revk/ESP32-LED/PCB/README.md

# PCBs

Various PCBs designed for use with LED code.

## Trademark

This is an open source project, but bear in mind you cannot sell boards bearing the Andrews & Arnold Ltd name, the A&A logo, the registered trademark AJK logo, or the GS1 allocated EANs assigned to Andrews & Arnold Ltd.

## Coaster

Coaster board

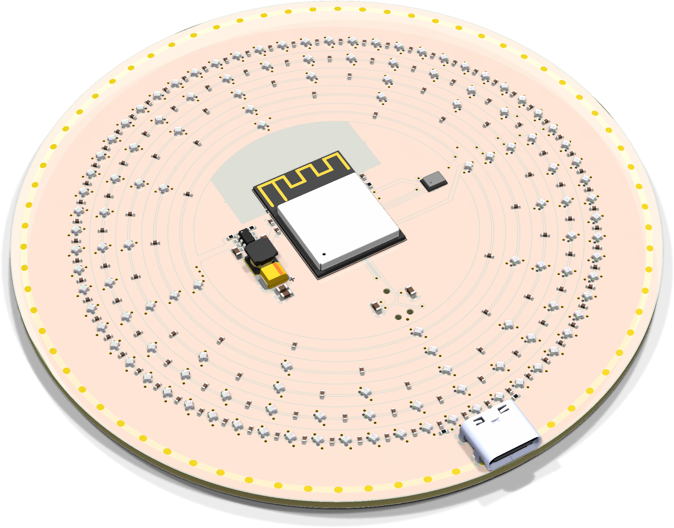
[picture p10: PCB/Coaster2/Coaster-90.png]
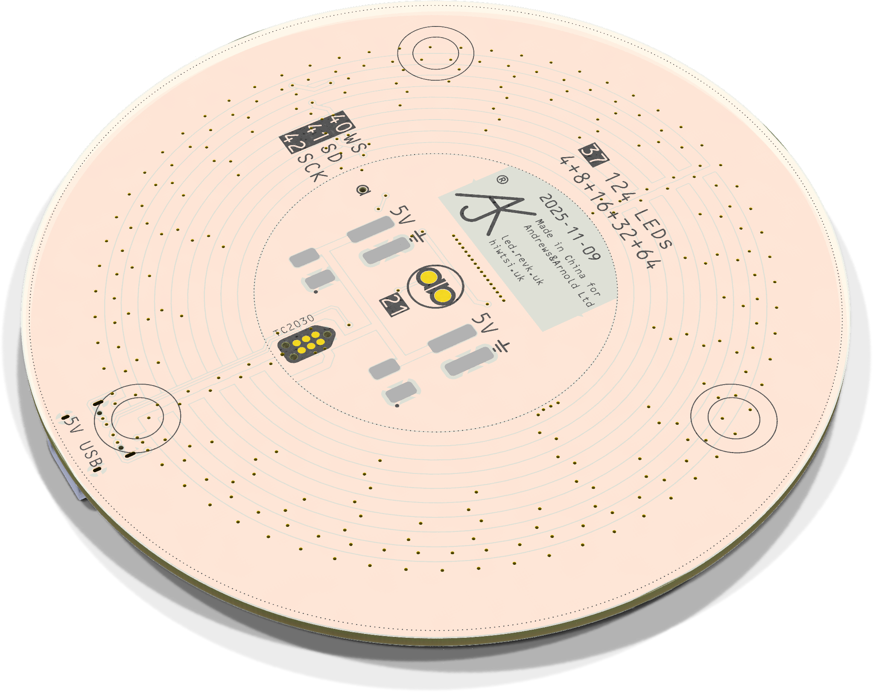
[picture p11: PCB/Coaster2/Coaster-bottom.png]
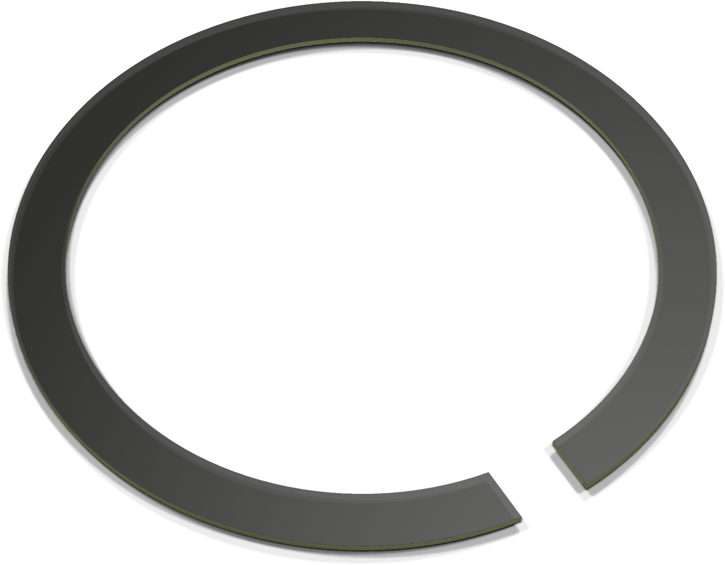
[picture p12: PCB/Coaster2/Spacer-90.png]
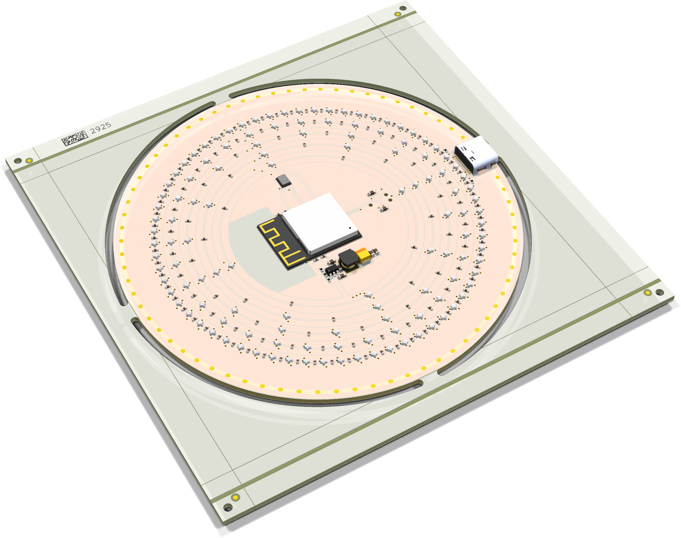
[picture p13: PCB/Coaster2/Coaster-panel.png]


## LEDA

USB-A board

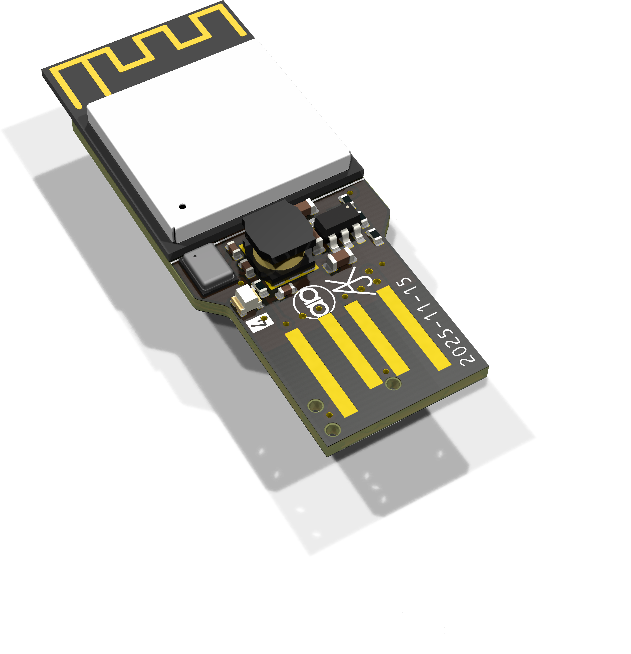
[picture p14: PCB/LEDA/LED-alt-90.png]
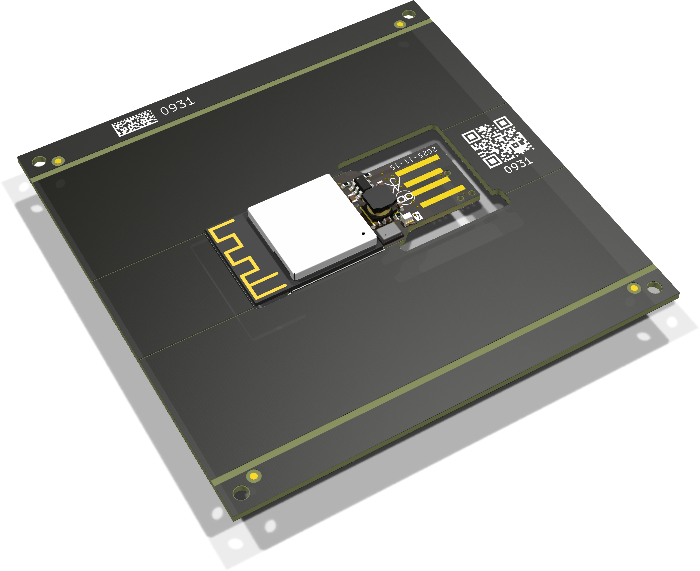
[picture p15: PCB/LEDA/LED-panel.png]


## LEDC

USB-C board

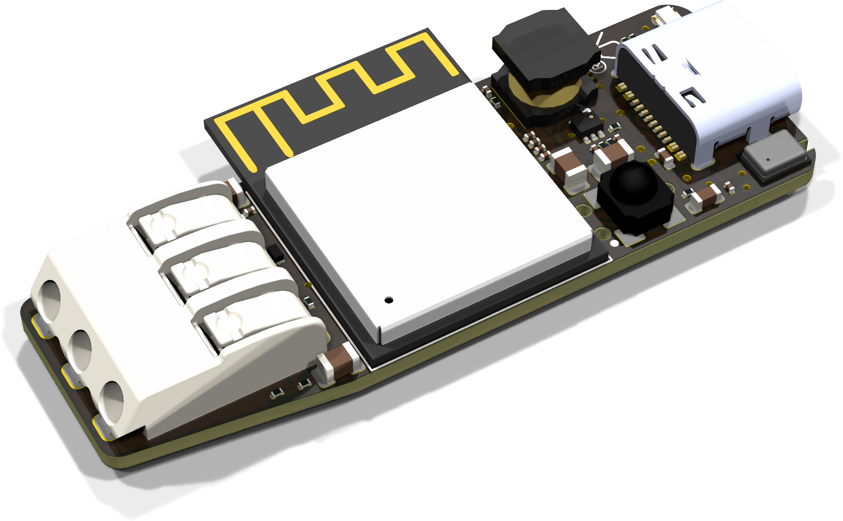
[picture p16: PCB/LEDC12/LED.png]
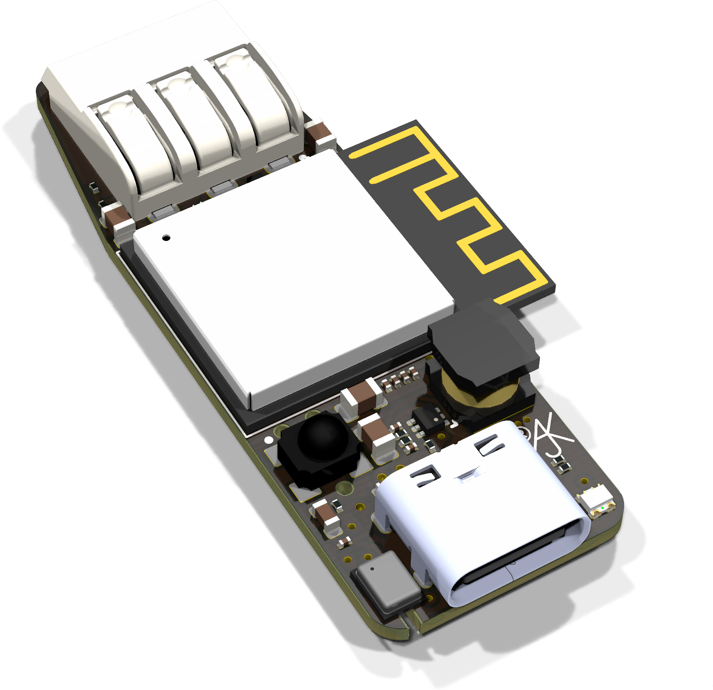
[picture p17: PCB/LEDC12/LED-90.png]
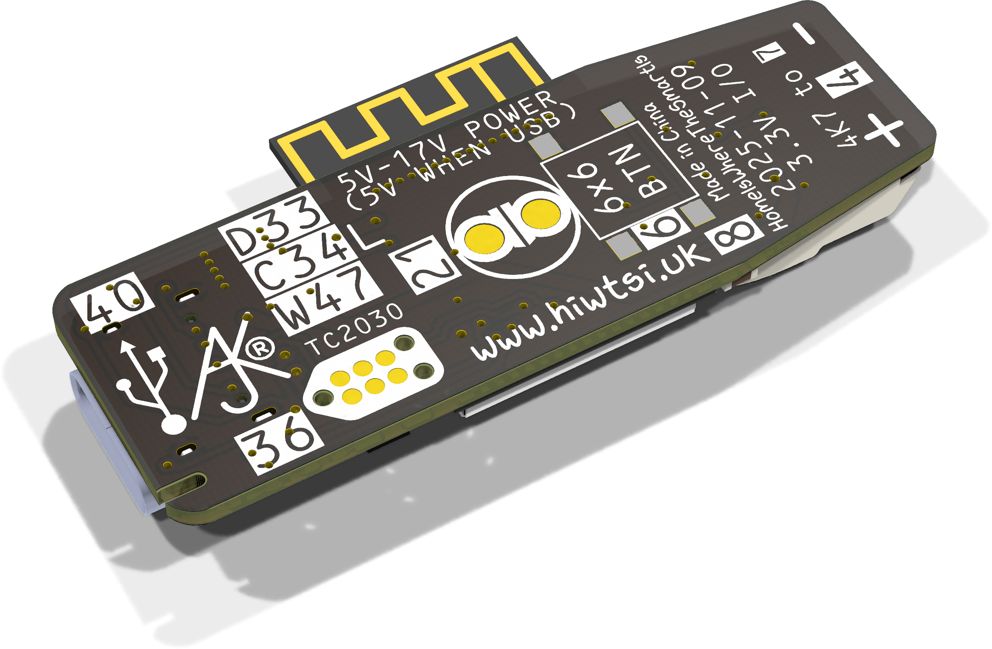
[picture p18: PCB/LEDC12/LED-bottom.png]
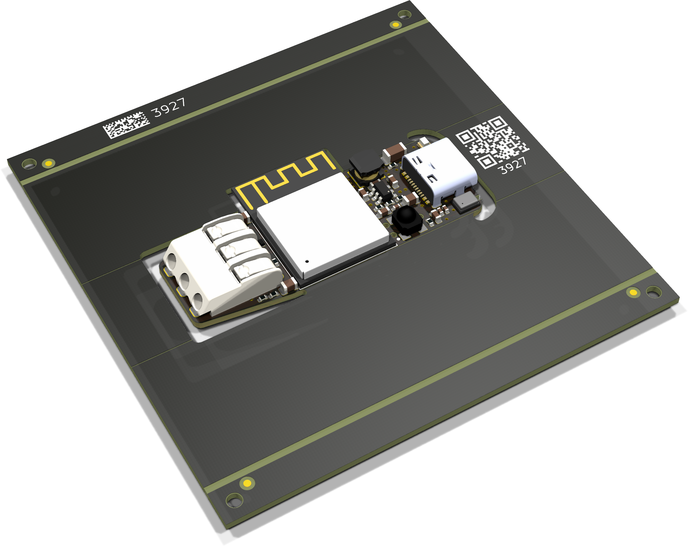
[picture p19: PCB/LEDC/LED-panel.png]
 

## LEDX

Non USB board

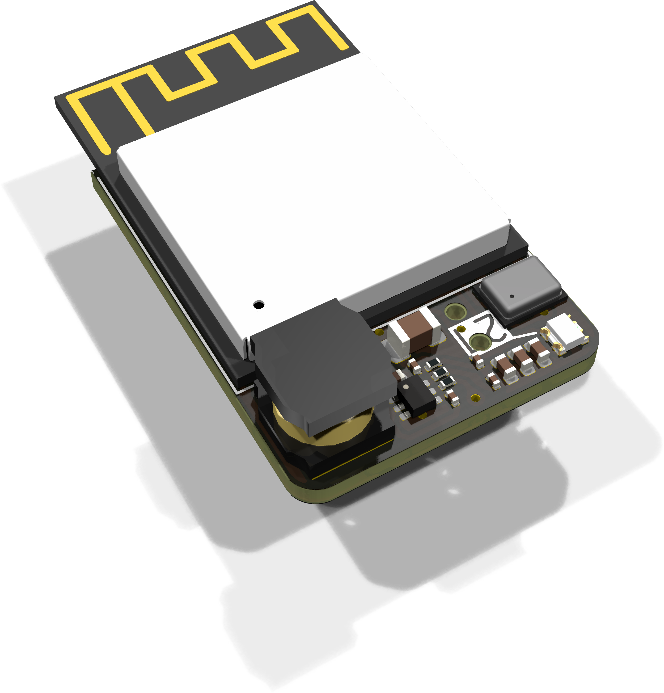
[picture p20: PCB/LEDX12/LED-90.png]
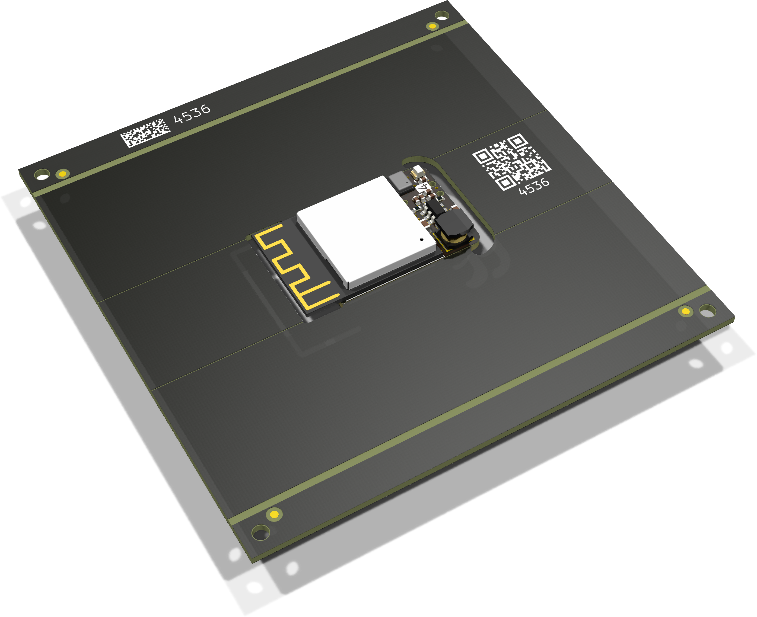
[picture p21: PCB/LEDX/LED-panel.png]


## LEDR

USB-C uber board

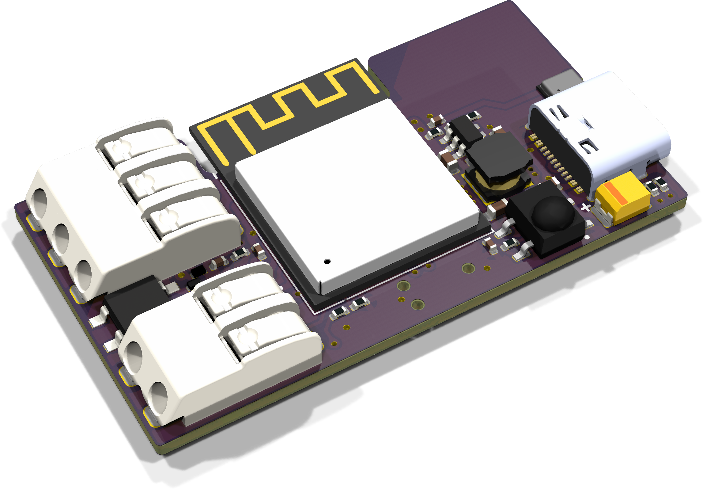
[picture p22: PCB/LEDR/LED.png]
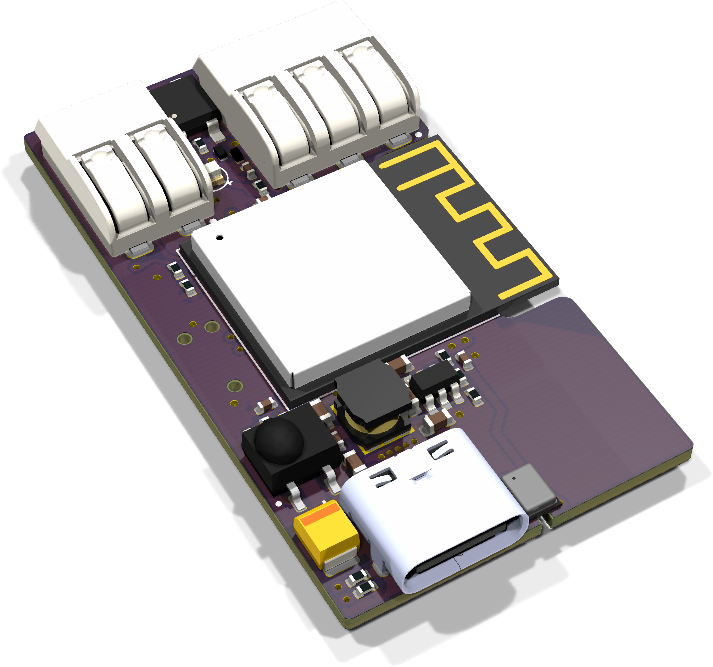
[picture p23: PCB/LEDR/LED-90.png]
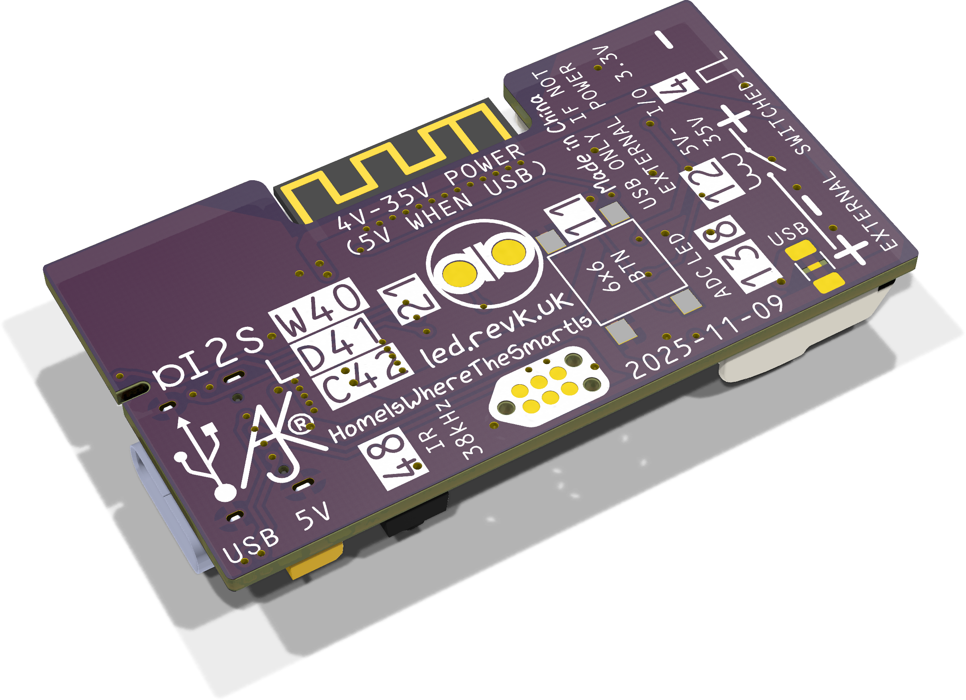
[picture p24: PCB/LEDR/LED-bottom.png]
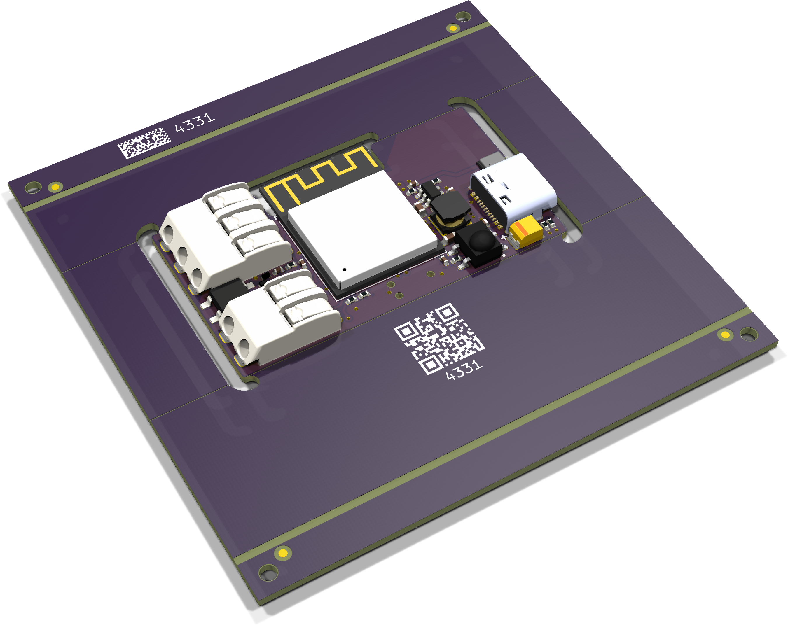
[picture p25: PCB/LEDR/LED-panel.png]


## LEDx2

USB-C dual LED board

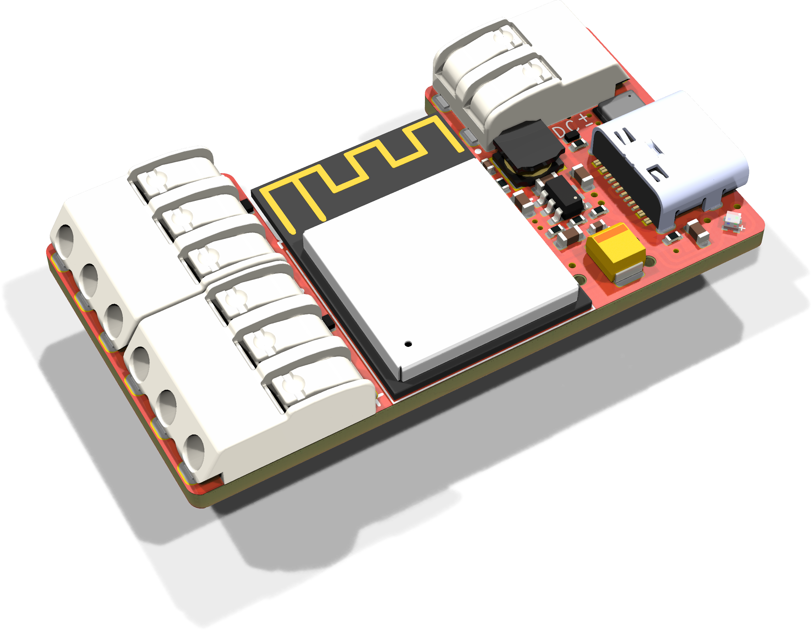
[picture p26: PCB/LEDx2/LED.png]
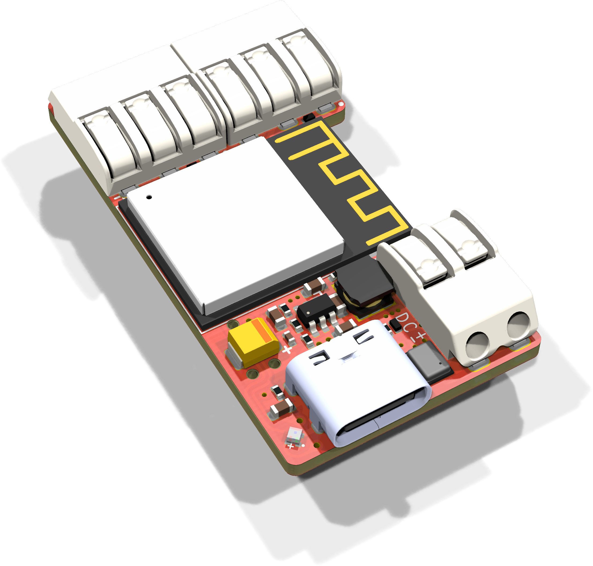
[picture p27: PCB/LEDx2/LED-90.png]
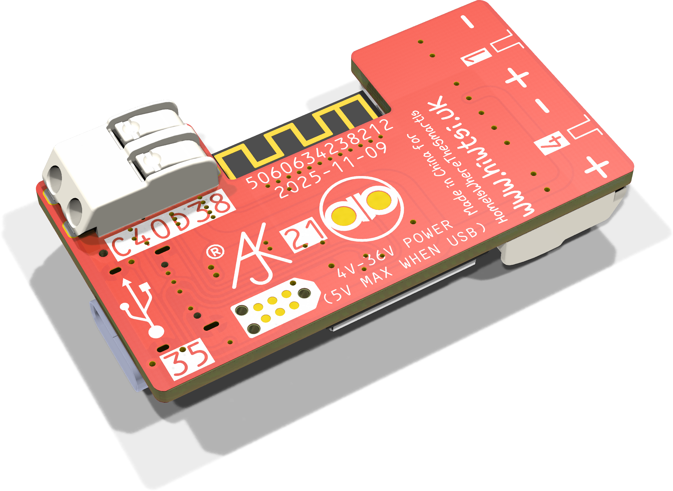
[picture p28: PCB/LEDx2/LED-bottom.png]
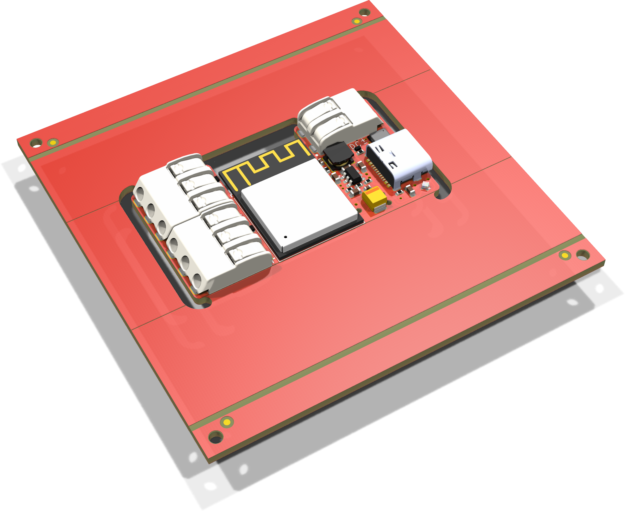
[picture p29: PCB/LEDx2/LED-panel.png]


## LED32

88 LED disk, 32mm diameter

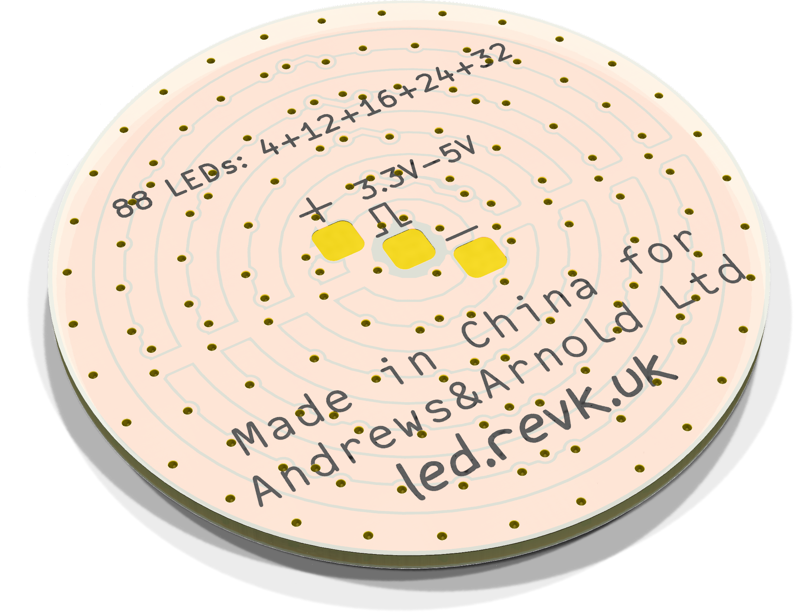
[picture p30: PCB/LED32/LED-bottom.png]
