revk/ESP32-LED/PCB/LEDA/README.md

# LEDA

## Trademark

This is an open source project, but bear in mind you cannot sell boards or cases bearing the Andrews & Arnold Ltd name, the A&A logo, the registered trademark AJK logo, or the GS1 allocated EANs assigned to Andrews & Arnold Ltd.

## PCB Designs

These files are for use with [KiCAD](https://www.kicad.org).

- [LED](LED.kicad_pro)

## 3D

3D case designs are normally automatically created from the PCB so as to ensure correct details and placement of apertures, etc.

|Design|Bottom|Top|Combined|
|---|---|---|---|
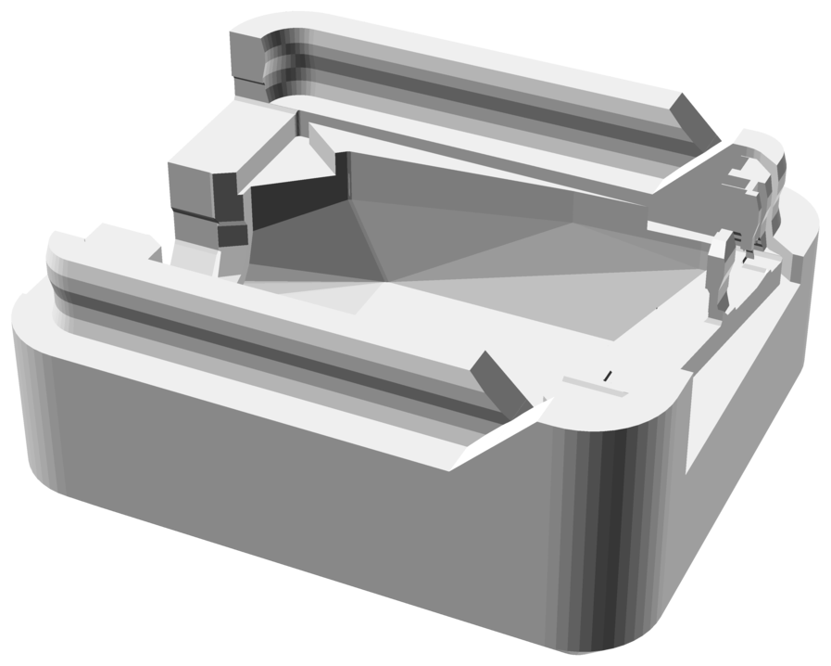
[picture p31: PCB/LEDA/LEDB.png]
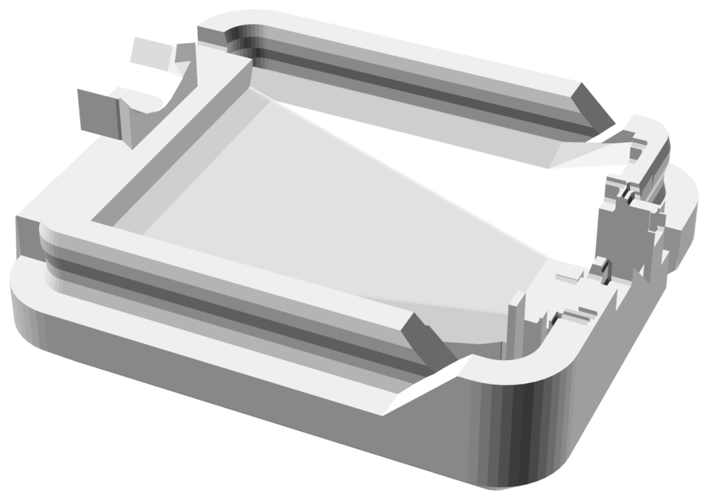
[picture p32: PCB/LEDA/LEDT.png]
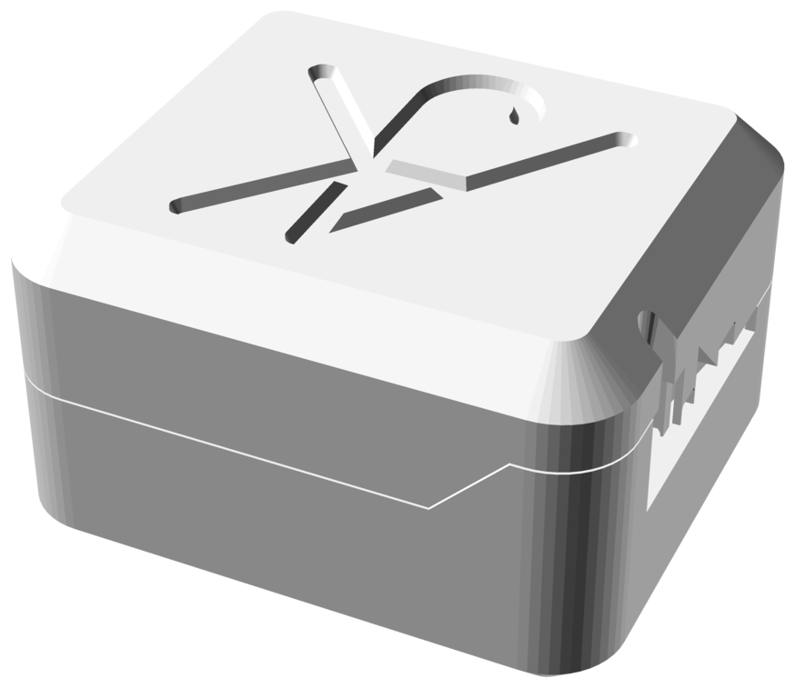
[picture p33: PCB/LEDA/LEDC.png]
|LED||||

## PCB Images

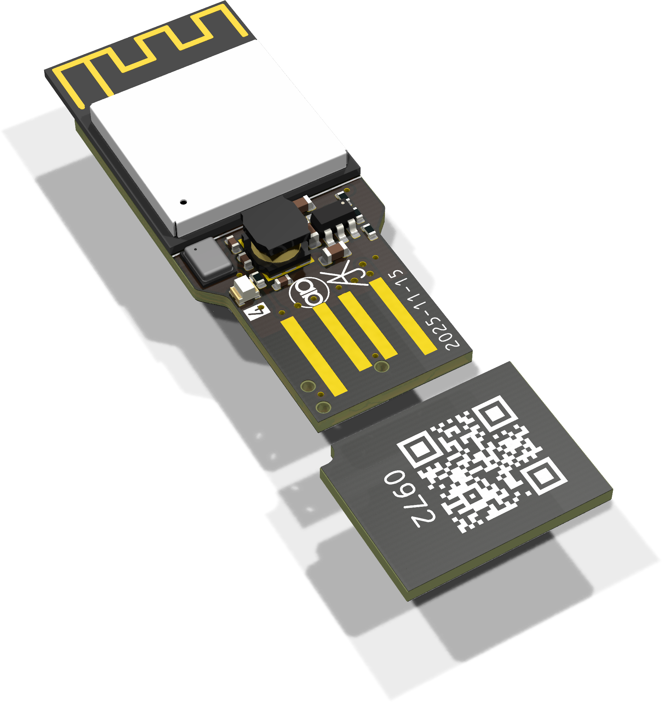
[picture p34: PCB/LEDA/LED-90.png]

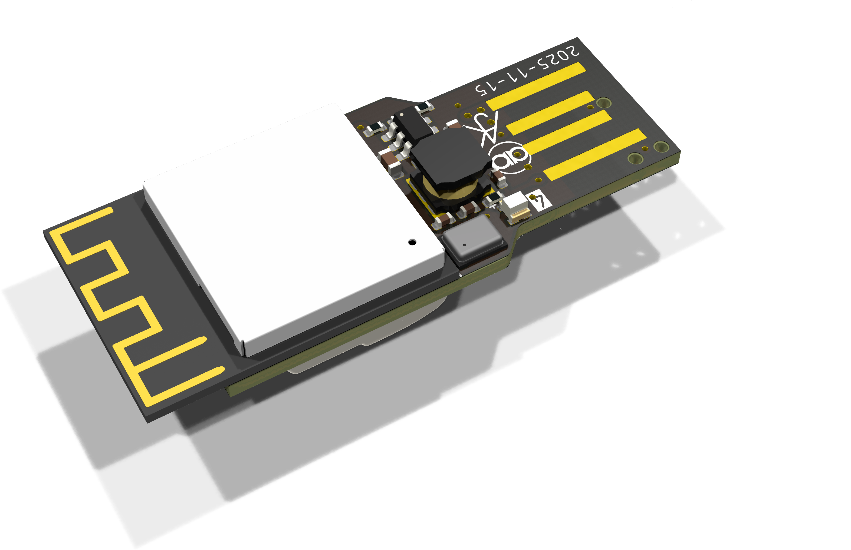
[picture p35: PCB/LEDA/LED-alt.png]
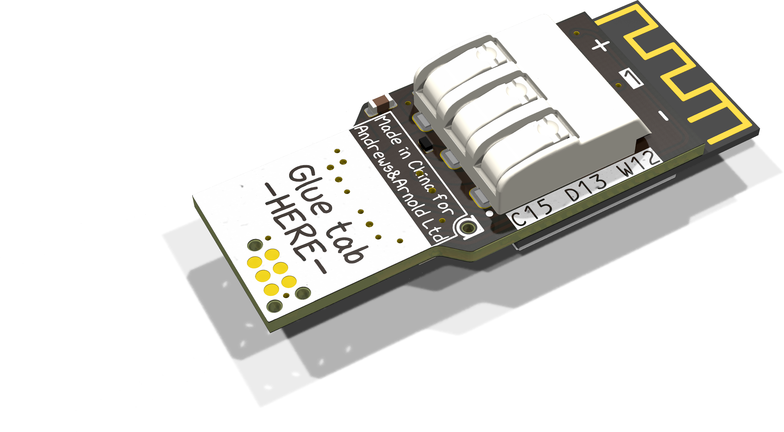
[picture p36: PCB/LEDA/LED-alt-bottom.png]

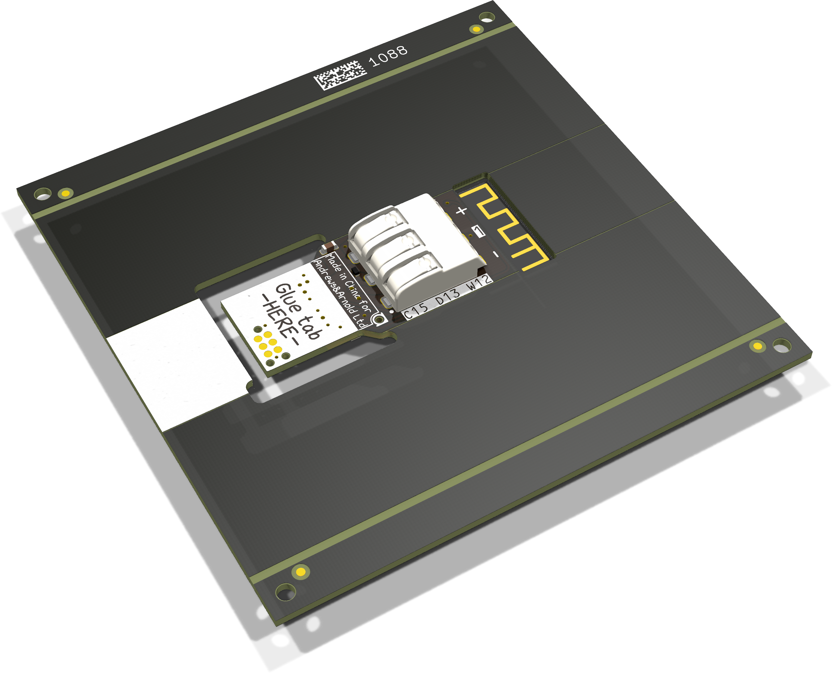
[picture p37: PCB/LEDA/LED-panel-bottom.png]


---

*Auto generated README.md 2025-11-15T10:07:33*
