revk/ESP32-LED/PCB/LEDC12/README.md

# LEDC12

## Trademark

This is an open source project, but bear in mind you cannot sell boards or cases bearing the Andrews & Arnold Ltd name, the A&A logo, the registered trademark AJK logo, or the GS1 allocated EANs assigned to Andrews & Arnold Ltd.

## PCB Designs

These files are for use with [KiCAD](https://www.kicad.org).

- [LED](LED.kicad_pro)

## 3D

3D case designs are normally automatically created from the PCB so as to ensure correct details and placement of apertures, etc.

|Design|Bottom|Top|Combined|
|---|---|---|---|
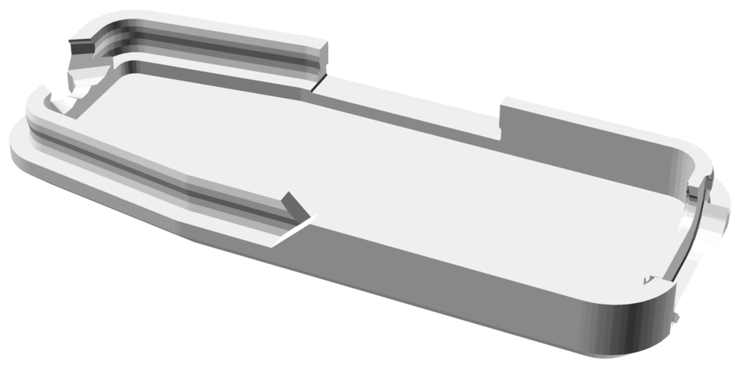
[picture p44: PCB/LEDC12/LEDB.png]
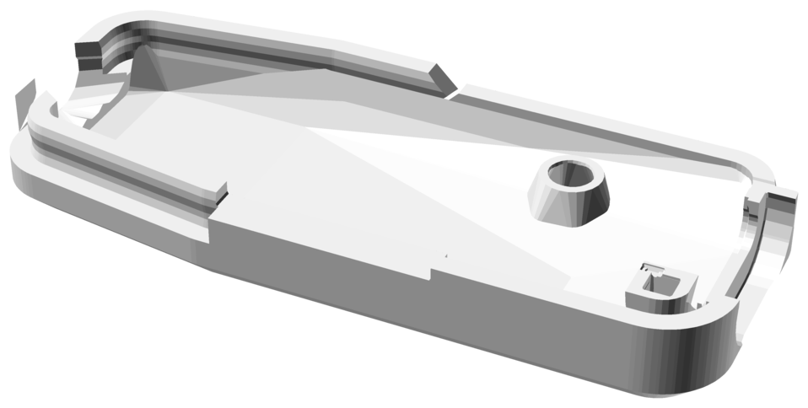
[picture p45: PCB/LEDC12/LEDT.png]
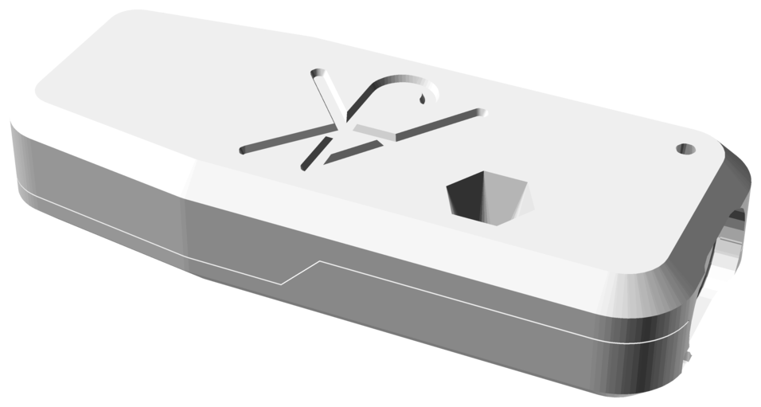
[picture p46: PCB/LEDC12/LEDC.png]
|LED||||

## PCB Images


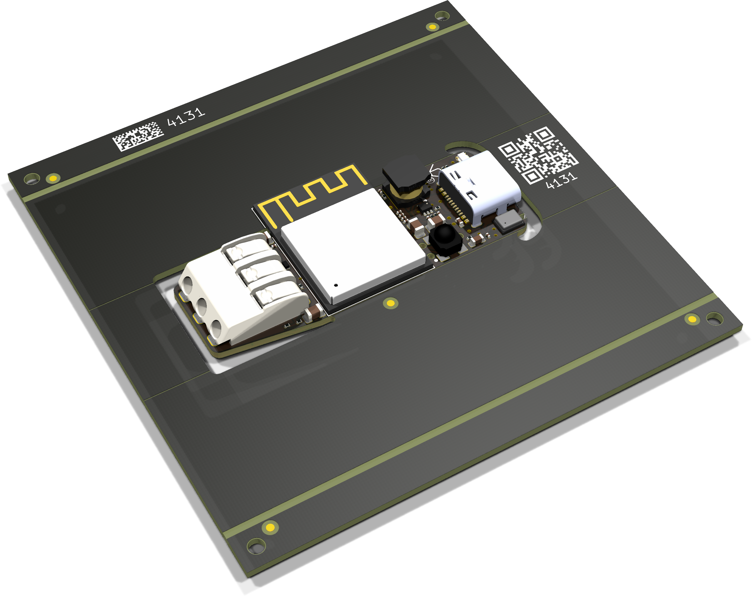
[picture p47: PCB/LEDC12/LED-panel.png]
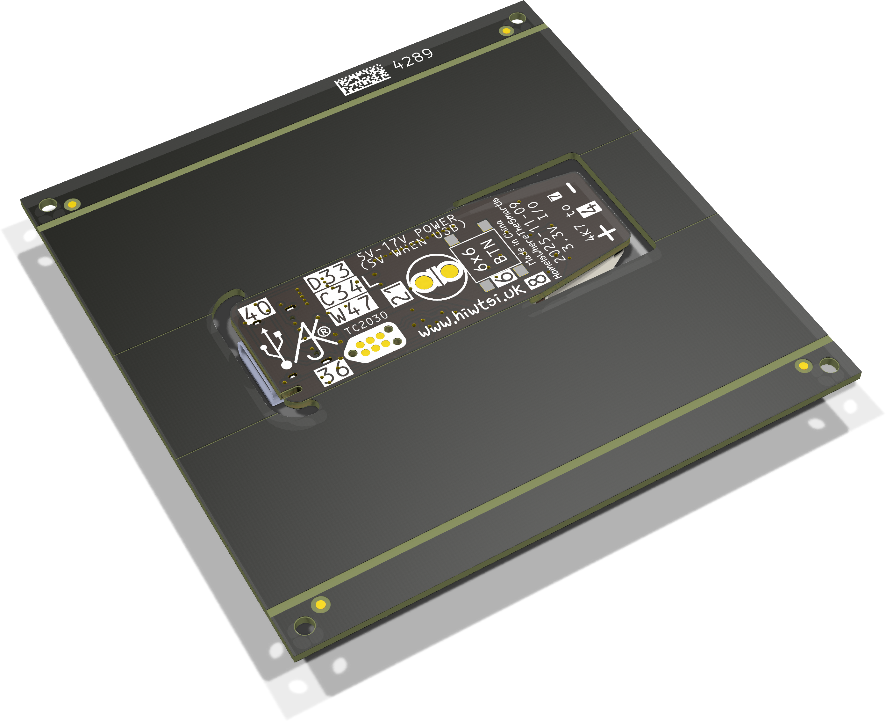
[picture p48: PCB/LEDC12/LED-panel-bottom.png]


---

*Auto generated README.md 2025-11-15T09:00:35*
