revk/ESP32-LED/PCB/LEDR/README.md

# LEDR

## Trademark

This is an open source project, but bear in mind you cannot sell boards or cases bearing the Andrews & Arnold Ltd name, the A&A logo, the registered trademark AJK logo, or the GS1 allocated EANs assigned to Andrews & Arnold Ltd.

## PCB Designs

These files are for use with [KiCAD](https://www.kicad.org).

- [LED](LED.kicad_pro)

## 3D

3D case designs are normally automatically created from the PCB so as to ensure correct details and placement of apertures, etc.

|Design|Bottom|Top|Combined|
|---|---|---|---|
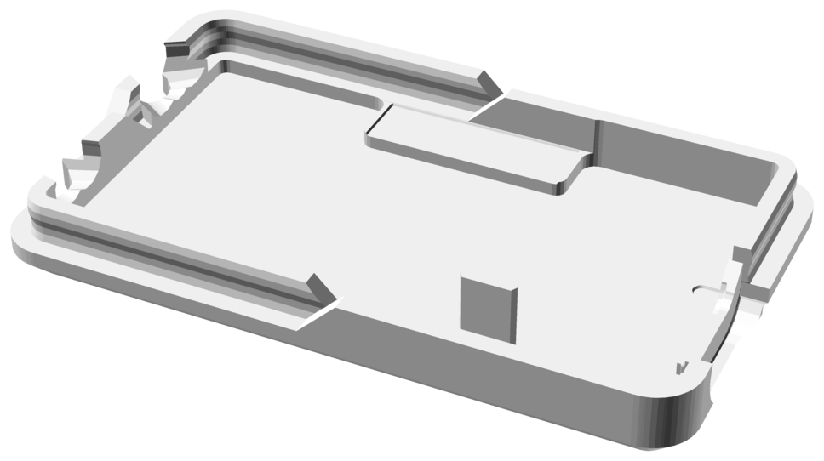
[picture p49: PCB/LEDR/LEDB.png]
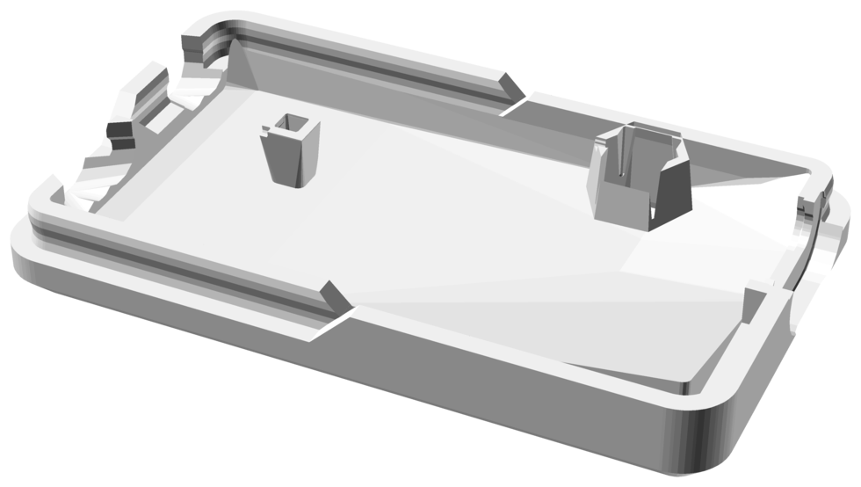
[picture p50: PCB/LEDR/LEDT.png]
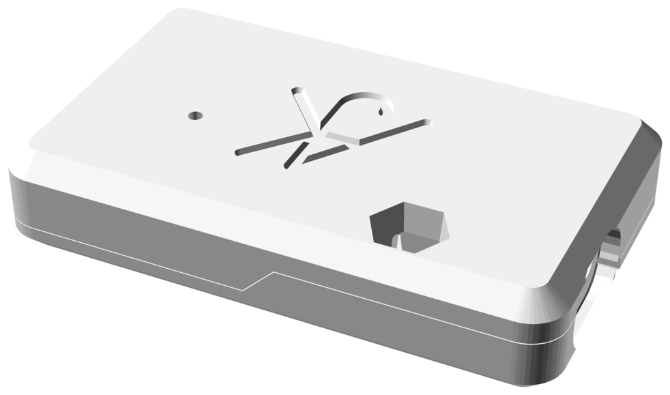
[picture p51: PCB/LEDR/LEDC.png]
|LED||||

## PCB Images


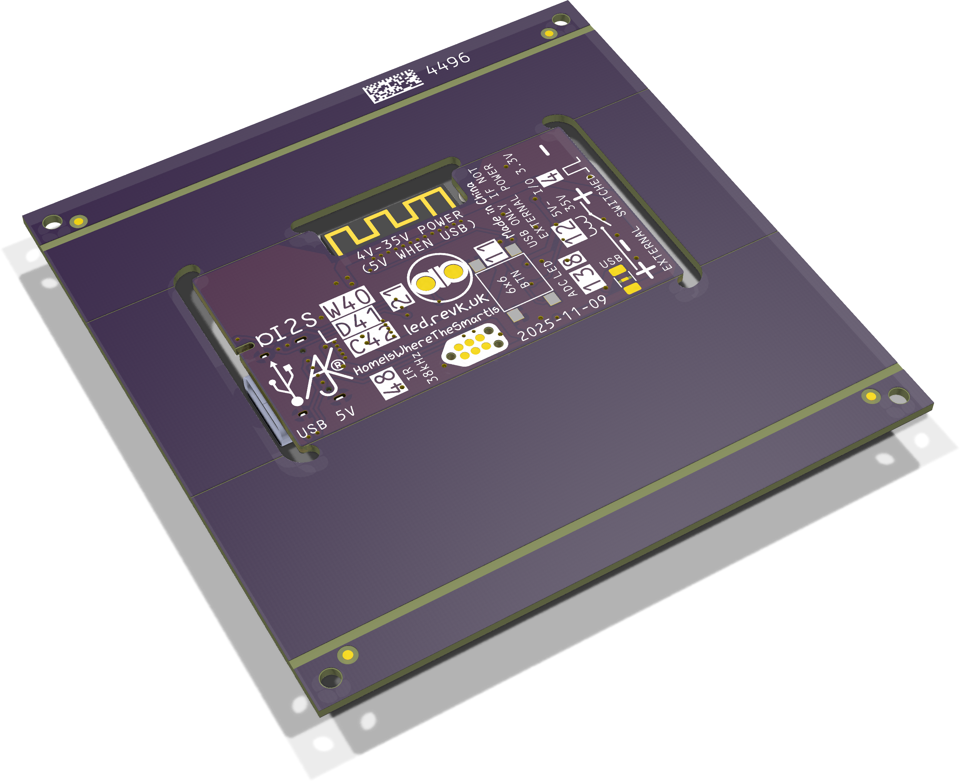
[picture p52: PCB/LEDR/LED-panel-bottom.png]


---

*Auto generated README.md 2025-11-15T09:00:37*
