revk/ESP32-LED/PCB/LEDX/README.md

# LEDX

## Trademark

This is an open source project, but bear in mind you cannot sell boards or cases bearing the Andrews & Arnold Ltd name, the A&A logo, the registered trademark AJK logo, or the GS1 allocated EANs assigned to Andrews & Arnold Ltd.

## PCB Designs

These files are for use with [KiCAD](https://www.kicad.org).

- [LED](LED.kicad_pro)

## 3D

3D case designs are normally automatically created from the PCB so as to ensure correct details and placement of apertures, etc.

|Design|Bottom|Top|Combined|
|---|---|---|---|
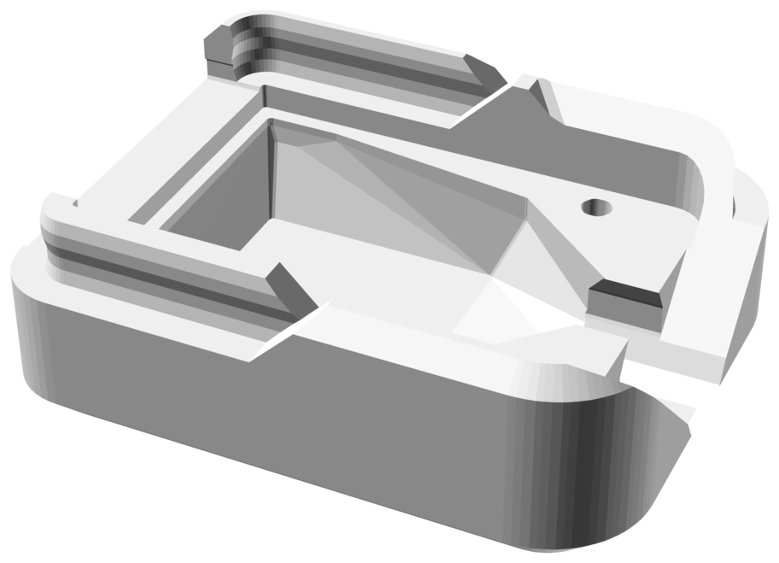
[picture p53: PCB/LEDX/LEDB.png]
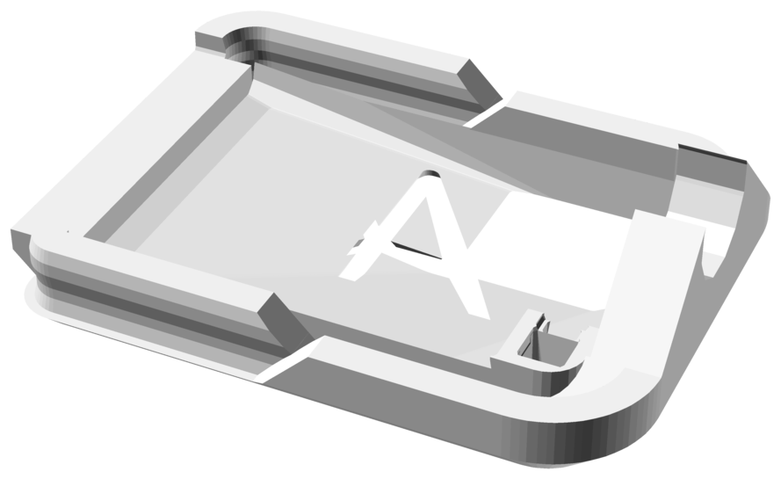
[picture p54: PCB/LEDX/LEDT.png]
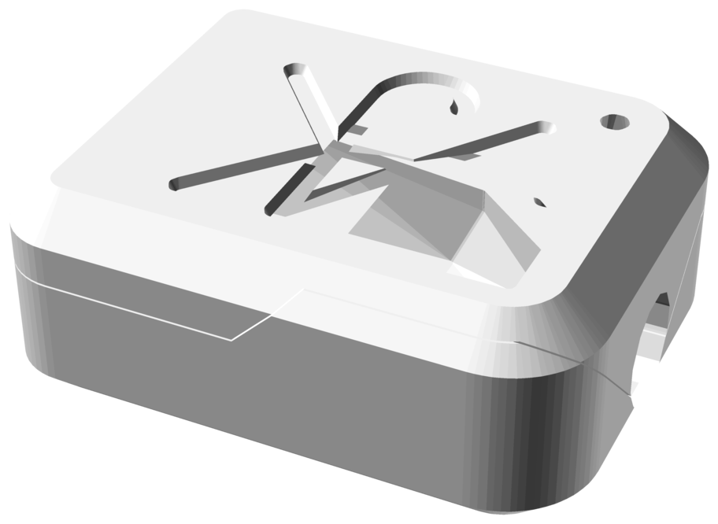
[picture p55: PCB/LEDX/LEDC.png]
|LED||||

## PCB Images

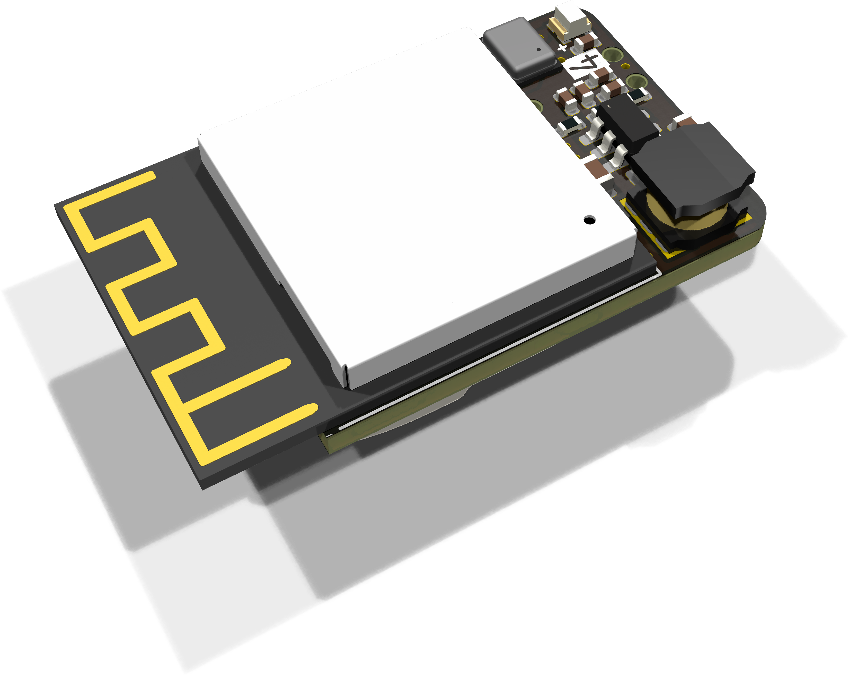
[picture p56: PCB/LEDX/LED.png]
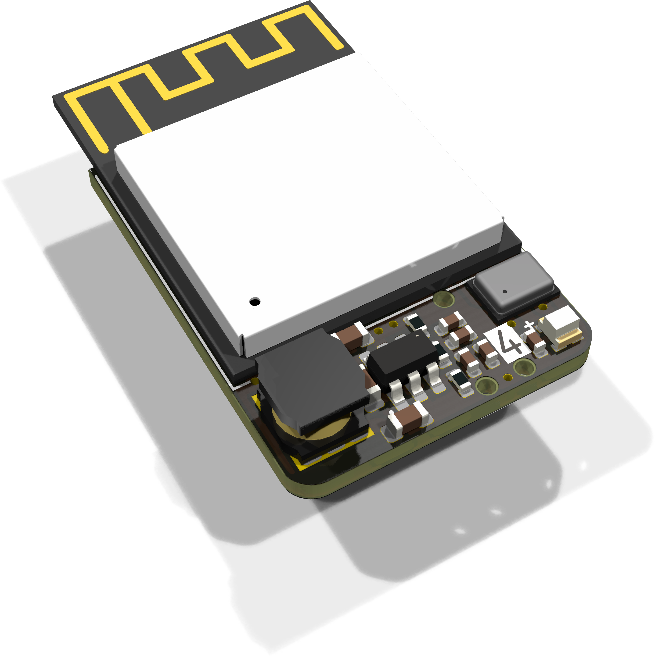
[picture p57: PCB/LEDX/LED-90.png]
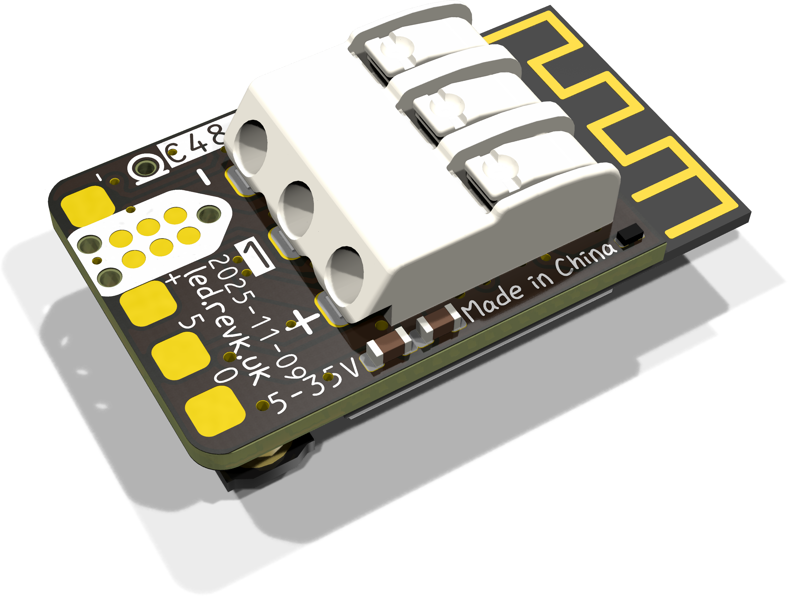
[picture p58: PCB/LEDX/LED-bottom.png]

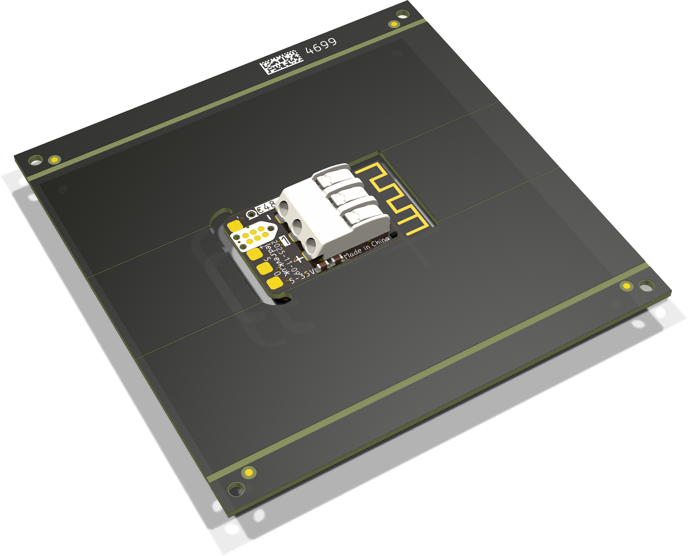
[picture p59: PCB/LEDX/LED-panel-bottom.png]


---

*Auto generated README.md 2025-11-15T09:00:40*
