revk/ESP32-LED/PCB/30x9/README.md

# 30x9

## Trademark

This is an open source project, but bear in mind you cannot sell boards or cases bearing the Andrews & Arnold Ltd name, the A&A logo, the registered trademark AJK logo, or the GS1 allocated EANs assigned to Andrews & Arnold Ltd.

## PCB Designs

These files are for use with [KiCAD](https://www.kicad.org).

- [30x9](30x9.kicad_pro)

## PCB Images

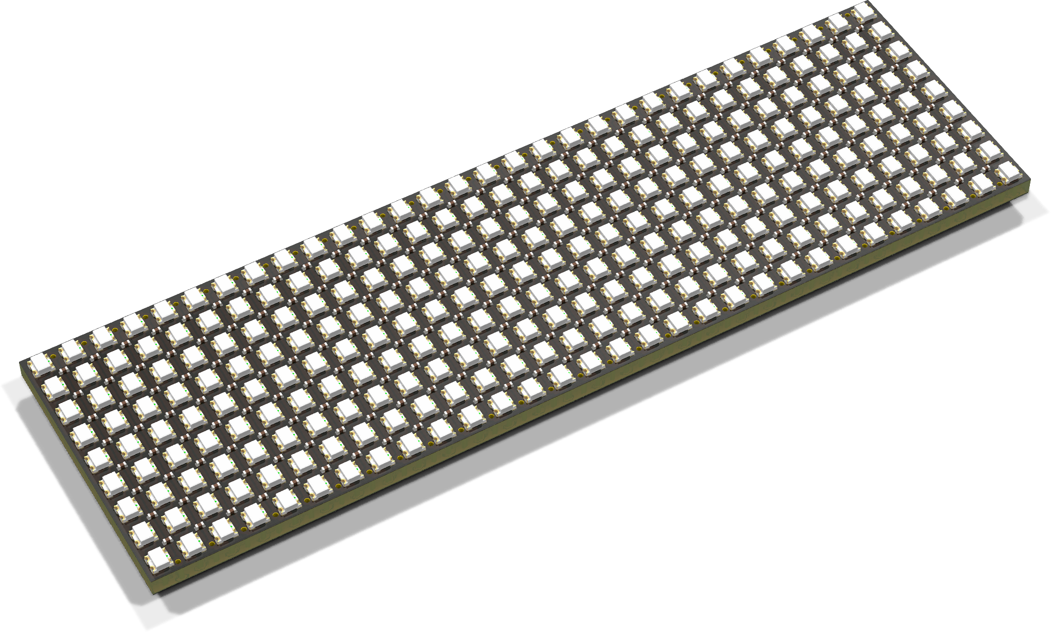
[picture p65: PCB/30x9/30x9.png]
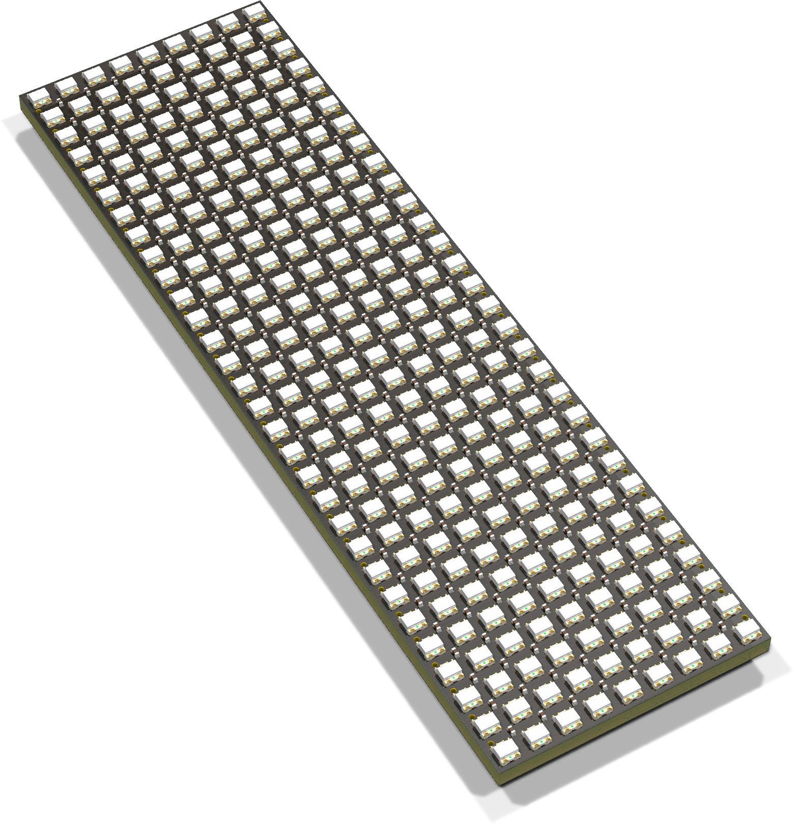
[picture p66: PCB/30x9/30x9-90.png]
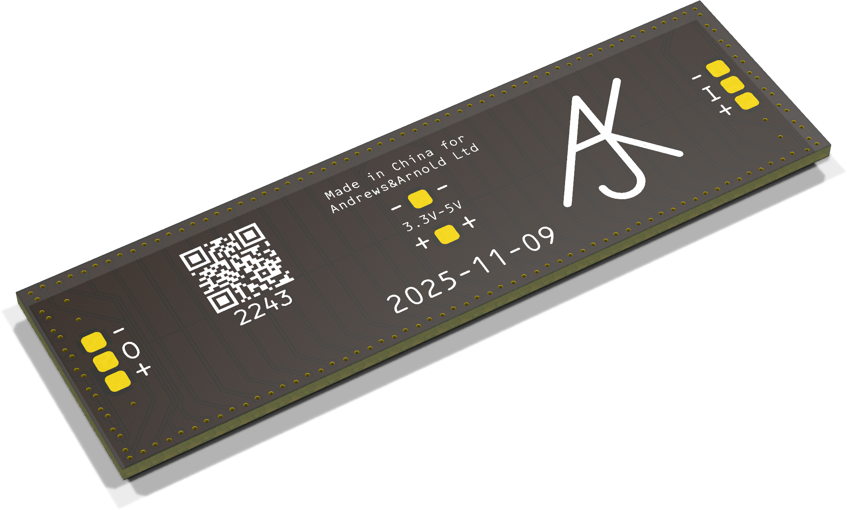
[picture p67: PCB/30x9/30x9-bottom.png]


---

*Auto generated README.md 2025-11-09T11:15:14*
