revk/ESP32-LED/PCB/Gate/README.md

# Gate

## Trademark

This is an open source project, but bear in mind you cannot sell boards or cases bearing the Andrews & Arnold Ltd name, the A&A logo, the registered trademark AJK logo, or the GS1 allocated EANs assigned to Andrews & Arnold Ltd.

## PCB Designs

These files are for use with [KiCAD](https://www.kicad.org).

- [Gate](Gate.kicad_pro)

## 3D

3D case designs are normally automatically created from the PCB so as to ensure correct details and placement of apertures, etc.

- [Stargate](Stargate.stl)
- [StargateBottom](StargateBottom.stl)
- [StargateRamp](StargateRamp.stl)
- [StargateRampBottom](StargateRampBottom.stl)
- [StargateRampTop](StargateRampTop.stl)
- [StargateTop](StargateTop.stl)

## PCB Images

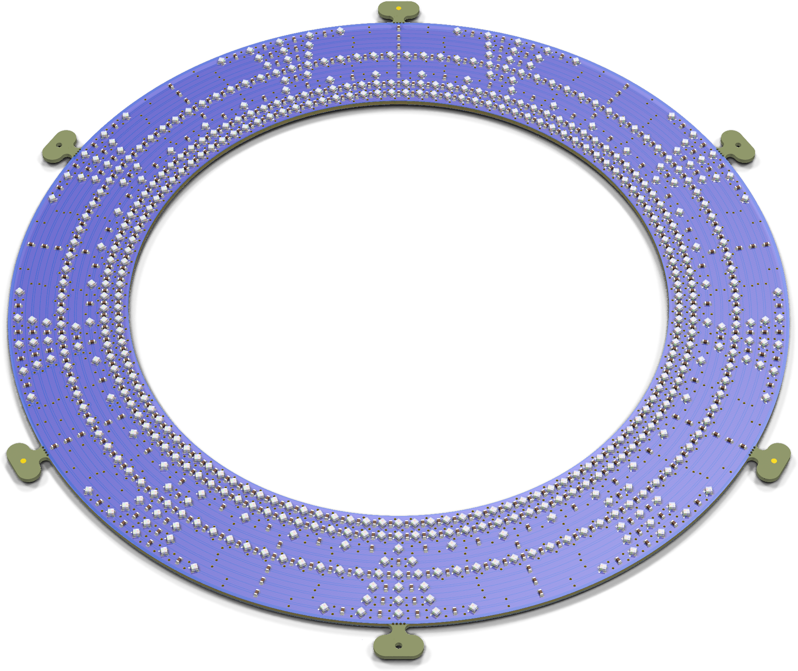
[picture p68: PCB/Gate/Gate-90.png]
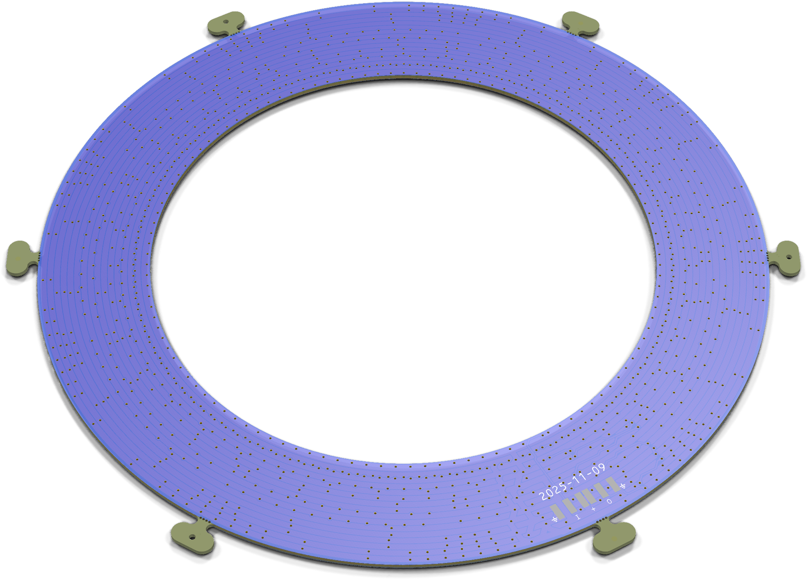
[picture p69: PCB/Gate/Gate-bottom.png]


---

*Auto generated README.md 2025-11-09T11:03:06*
