revk/ESP32-LED/PCB/5x7/README.md

# 5x7

These files are for use in [KiCad](https://www.kicad.org).

## Trademark

This is an open source project, but bear in mind you cannot sell boards bearing the Andrews & Arnold Ltd name, the A&A logo, the registered trademark AJK logo, or the GS1 allocated EANs assigned to Andrews & Arnold Ltd.

## Images

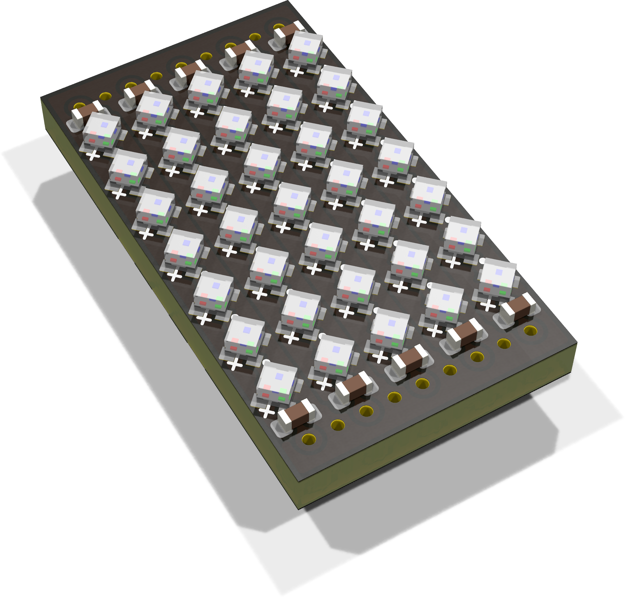
[picture p70: PCB/5x7/5x7.png]
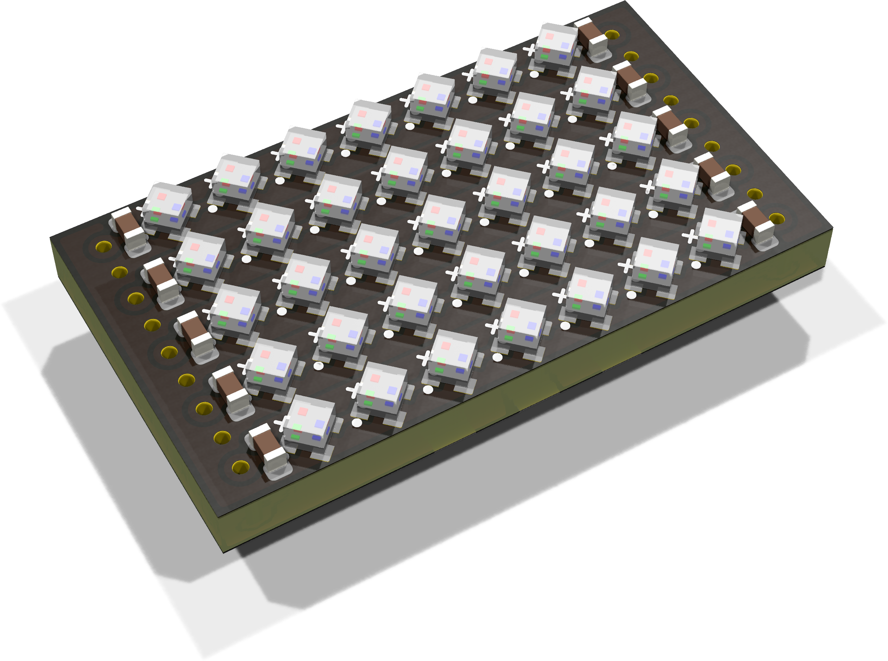
[picture p71: PCB/5x7/5x7-90.png]
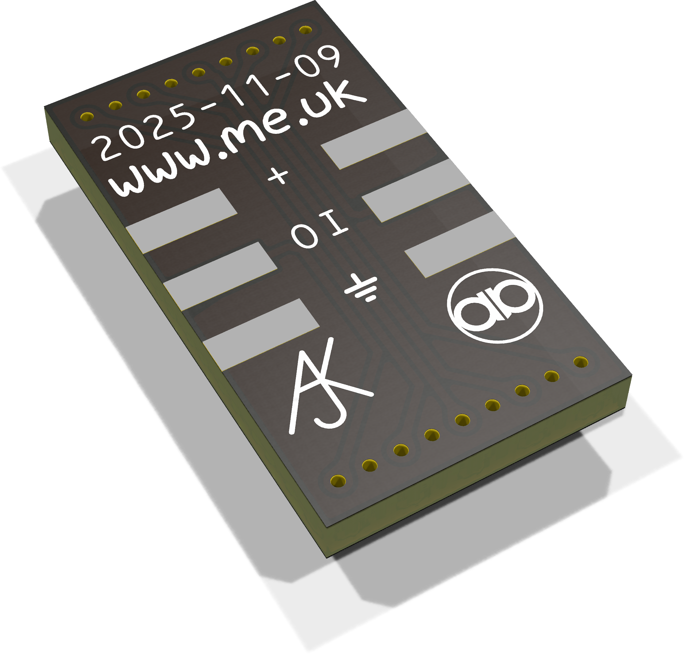
[picture p72: PCB/5x7/5x7-bottom.png]


*Auto generated 2025-08-12T11:30:27*
