revk/ESP32-LED/PCB/5x9/README.md

# 5x9

These files are for use in [KiCad](https://www.kicad.org).

## Trademark

This is an open source project, but bear in mind you cannot sell boards bearing the Andrews & Arnold Ltd name, the A&A logo, the registered trademark AJK logo, or the GS1 allocated EANs assigned to Andrews & Arnold Ltd.

## Images

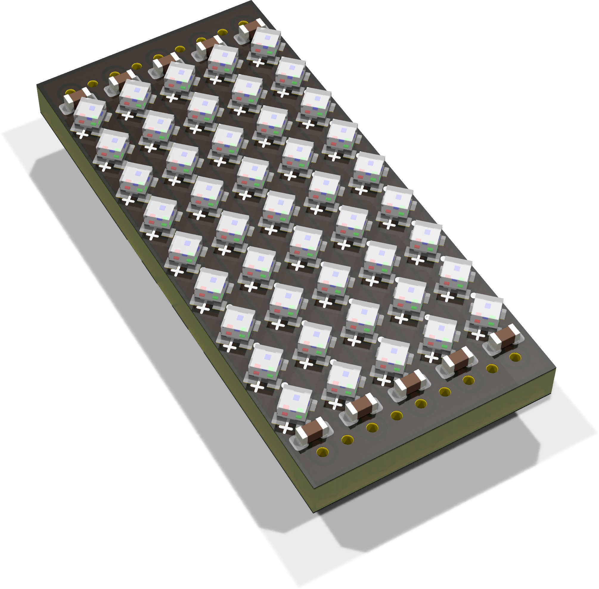
[picture p73: PCB/5x9/5x9.png]
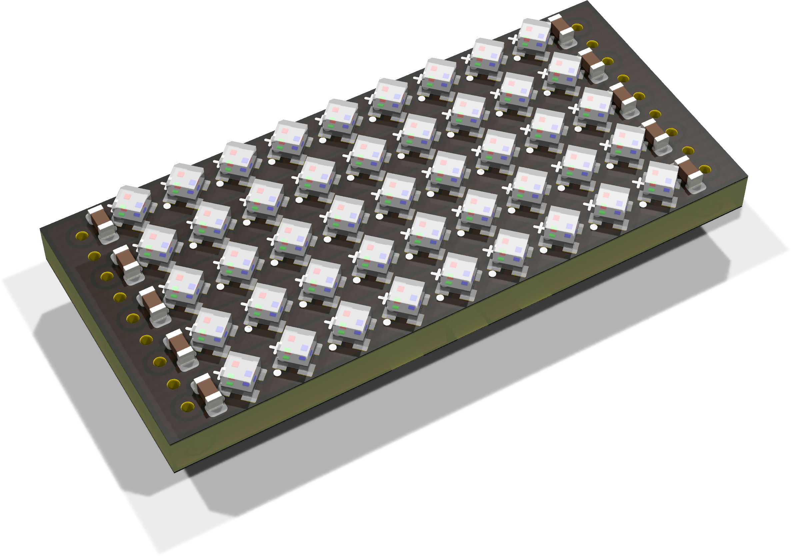
[picture p74: PCB/5x9/5x9-90.png]
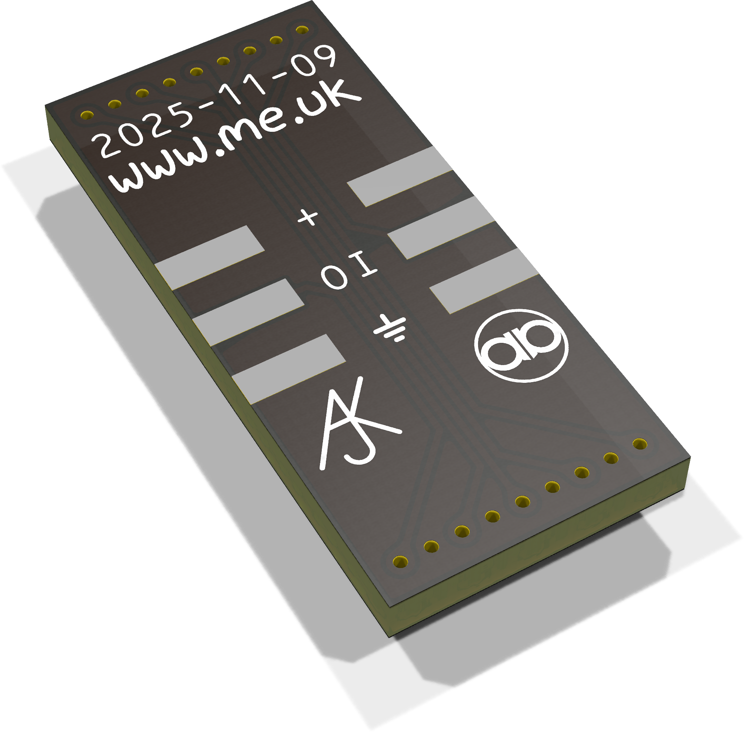
[picture p75: PCB/5x9/5x9-bottom.png]


*Auto generated 2025-08-12T11:32:16*
