revk/ESP32-LED/PCB/Clock/README.md

# Clock

These files are for use in [KiCad](https://www.kicad.org).

## Trademark

This is an open source project, but bear in mind you cannot sell boards bearing the Andrews & Arnold Ltd name, the A&A logo, the registered trademark AJK logo, or the GS1 allocated EANs assigned to Andrews & Arnold Ltd.

## Images

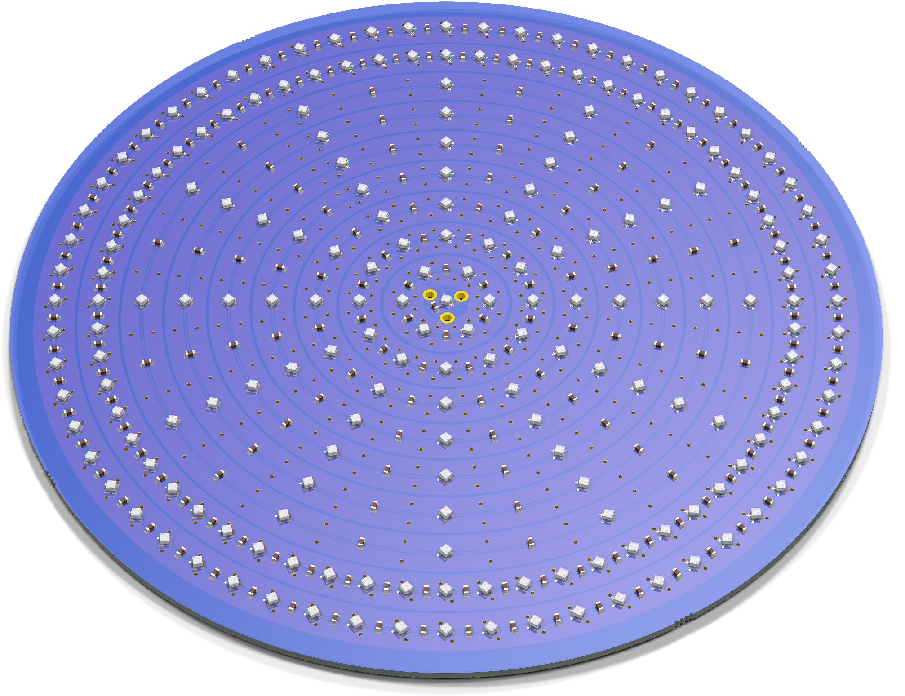
[picture p76: PCB/Clock/Clock.png]
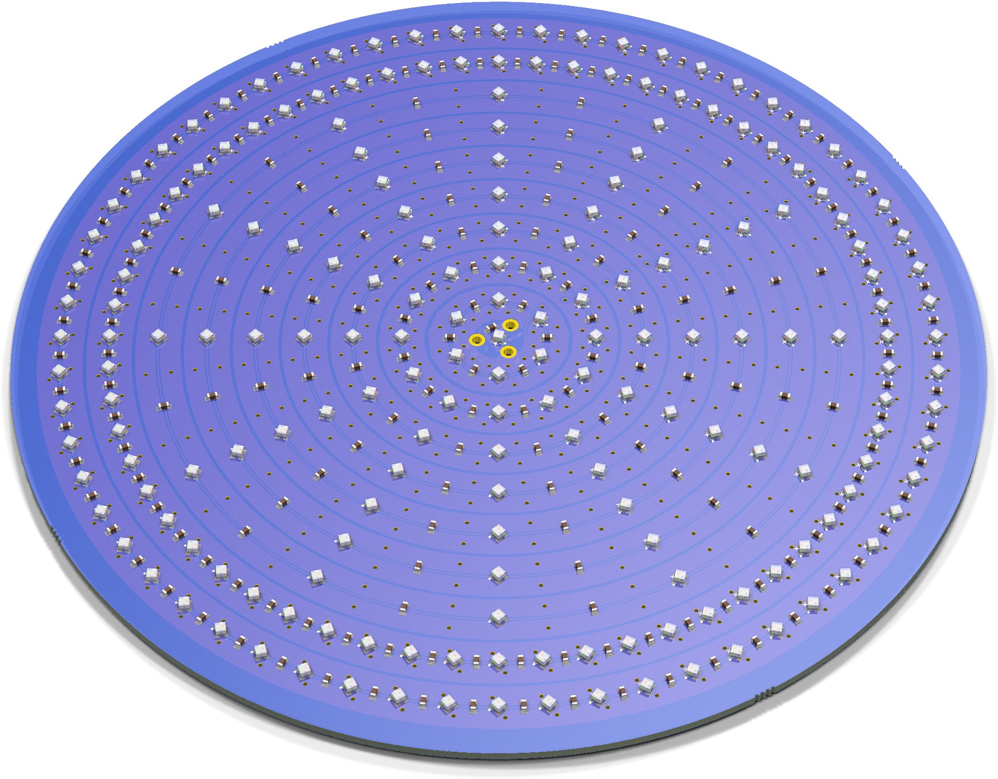
[picture p77: PCB/Clock/Clock-90.png]
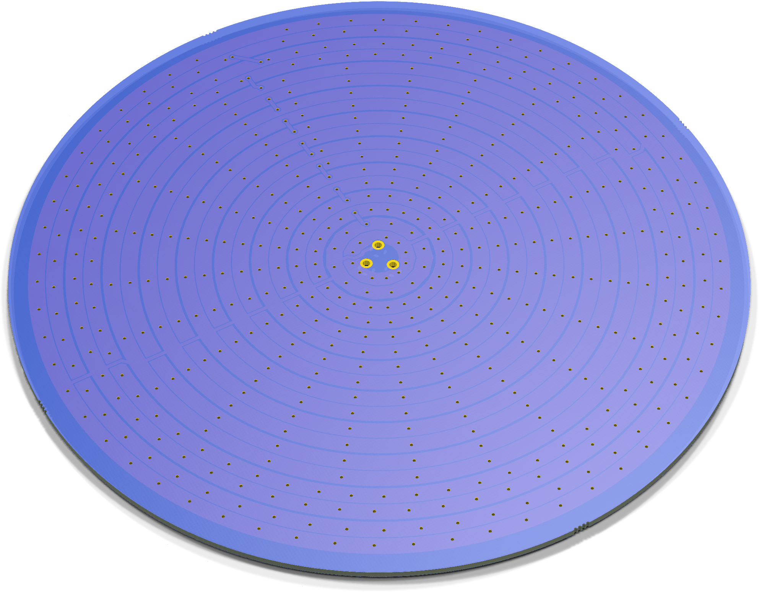
[picture p78: PCB/Clock/Clock-bottom.png]

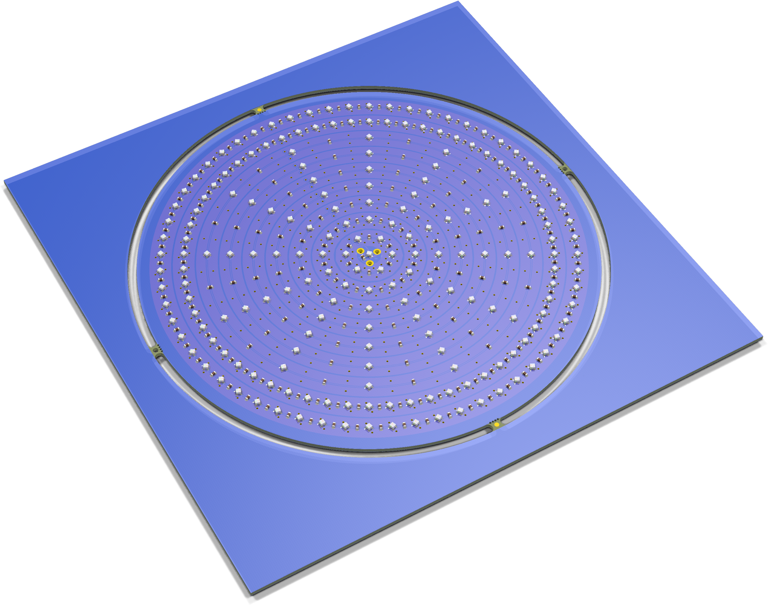
[picture p79: PCB/Clock/Clock-panel.png]
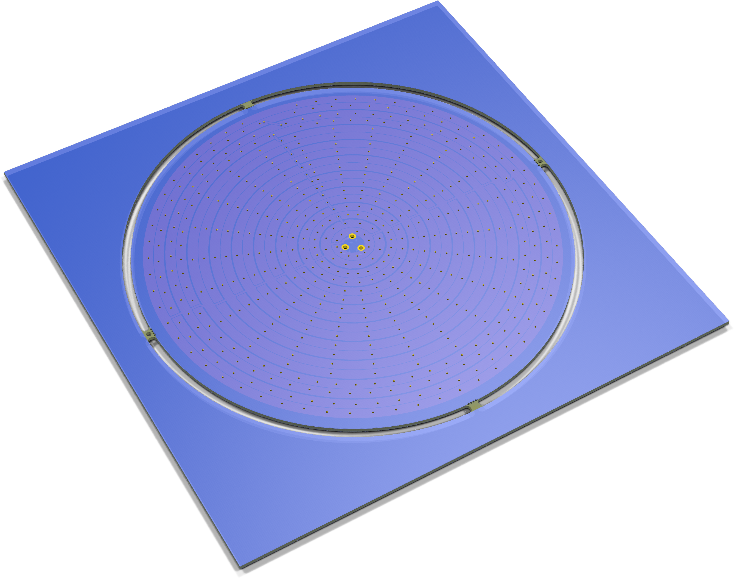
[picture p80: PCB/Clock/Clock-panel-bottom.png]


*Auto generated 2025-08-12T11:36:16*
