revk/ESP32-LED/PCB/Coaster/README.md

# Coaster

These files are for use in [KiCad](https://www.kicad.org).

## Trademark

This is an open source project, but bear in mind you cannot sell boards bearing the Andrews & Arnold Ltd name, the A&A logo, the registered trademark AJK logo, or the GS1 allocated EANs assigned to Andrews & Arnold Ltd.

## Images

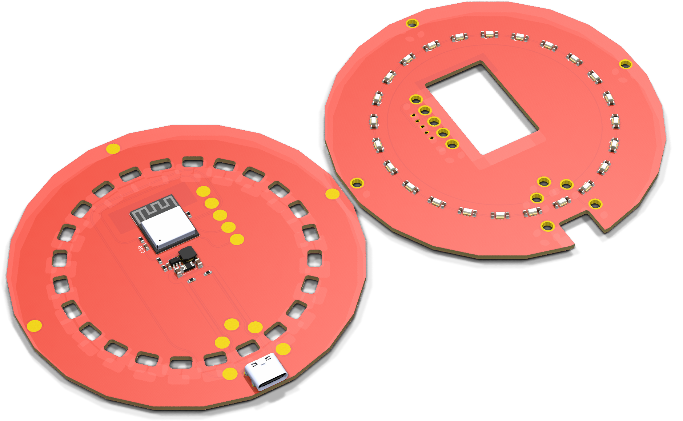
[picture p81: PCB/Coaster/Coaster.png]
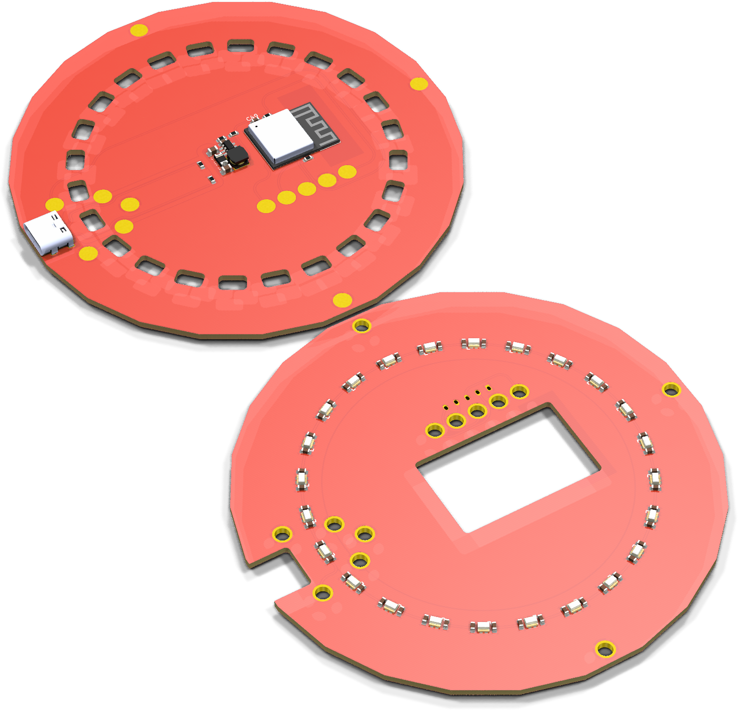
[picture p82: PCB/Coaster/Coaster-90.png]
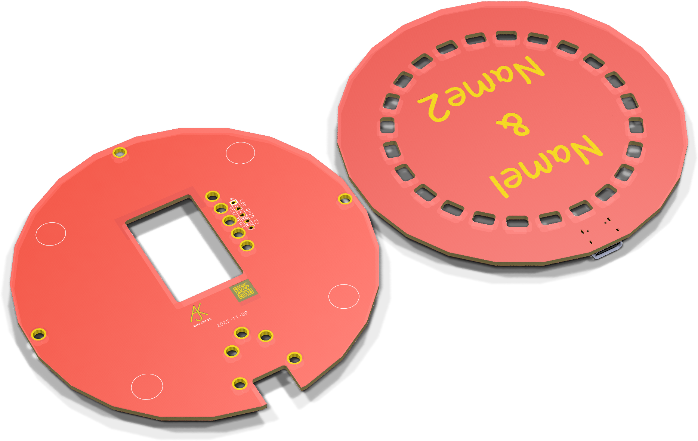
[picture p83: PCB/Coaster/Coaster-bottom.png]


*Auto generated 2025-08-12T11:38:05*
