revk/ESP32-LED/PCB/LED32/README.md

# LED

These files are for use in [KiCad](https://www.kicad.org).

## Trademark

This is an open source project, but bear in mind you cannot sell boards bearing the Andrews & Arnold Ltd name, the A&A logo, the registered trademark AJK logo, or the GS1 allocated EANs assigned to Andrews & Arnold Ltd.

## Images

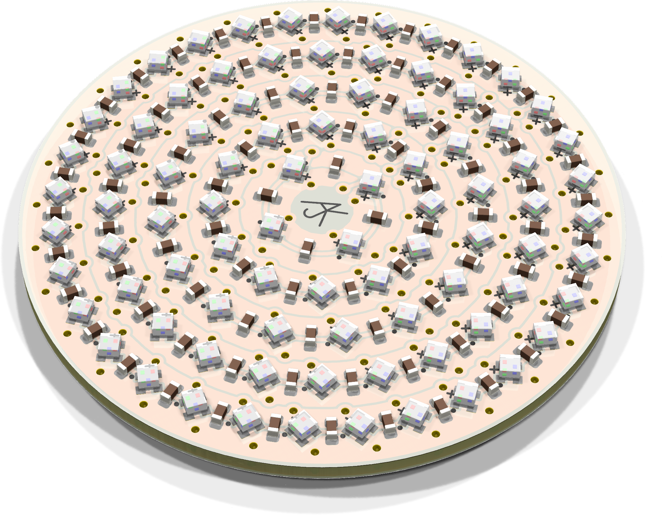
[picture p84: PCB/LED32/LED-90.png]


*Auto generated 2025-07-19T13:27:36*
