revk/ESP32-LED/PCB/LEDx2/README.md

# LED

These files are for use in [KiCad](https://www.kicad.org).

## Trademark

This is an open source project, but bear in mind you cannot sell boards bearing the Andrews & Arnold Ltd name, the A&A logo, the registered trademark AJK logo, or the GS1 allocated EANs assigned to Andrews & Arnold Ltd.

## Images


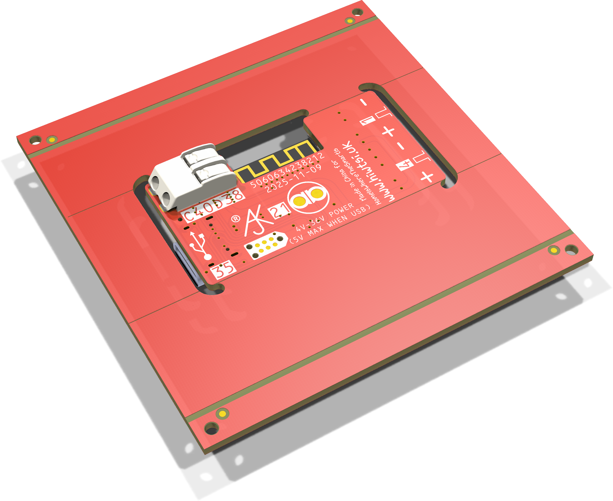
[picture p85: PCB/LEDx2/LED-panel-bottom.png]


*Auto generated 2025-07-19T13:48:54*
