revk/ESP32-LED/PCB/Coaster2/README.md

# Coaster

These files are for use in [KiCad](https://www.kicad.org).

## Trademark

This is an open source project, but bear in mind you cannot sell boards bearing the Andrews & Arnold Ltd name, the A&A logo, the registered trademark AJK logo, or the GS1 allocated EANs assigned to Andrews & Arnold Ltd.

## Images



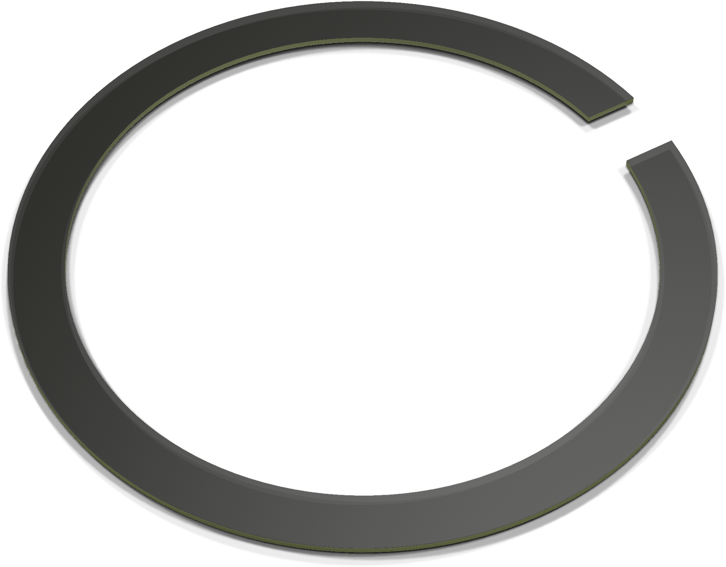
[picture p86: PCB/Coaster2/Spacer.png]
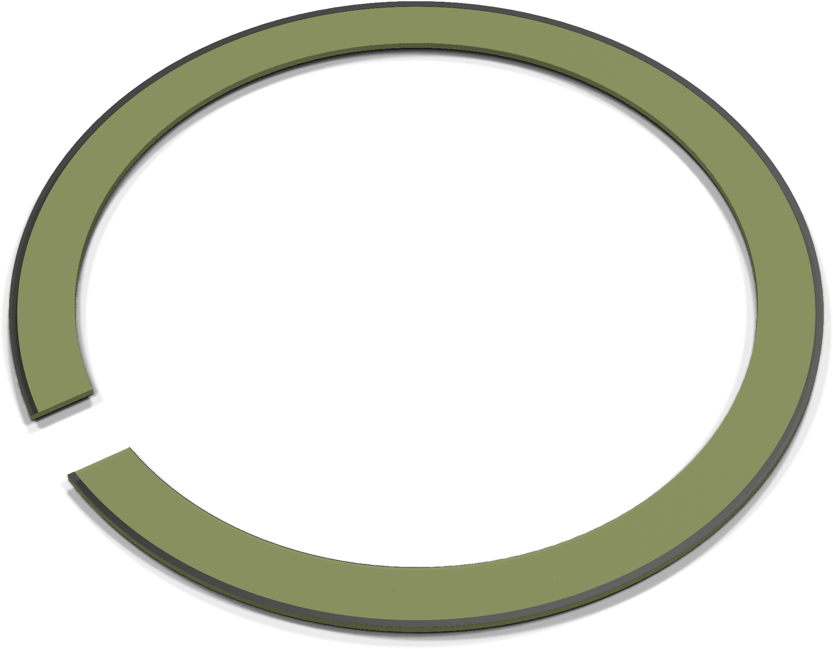
[picture p87: PCB/Coaster2/Spacer-bottom.png]
