revk/ESP32-LED/PCB/5x7.jpg

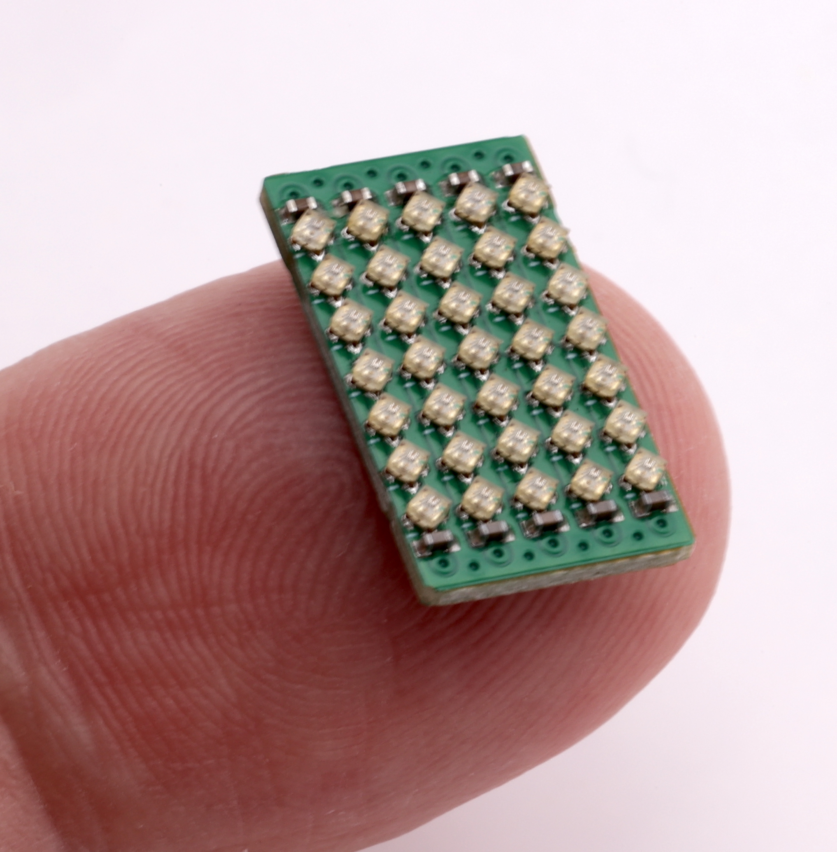
PCB/5x7.jpg
