revk/ESP32-LED/PCB/Coaster2/Coaster-panel-bottom.png

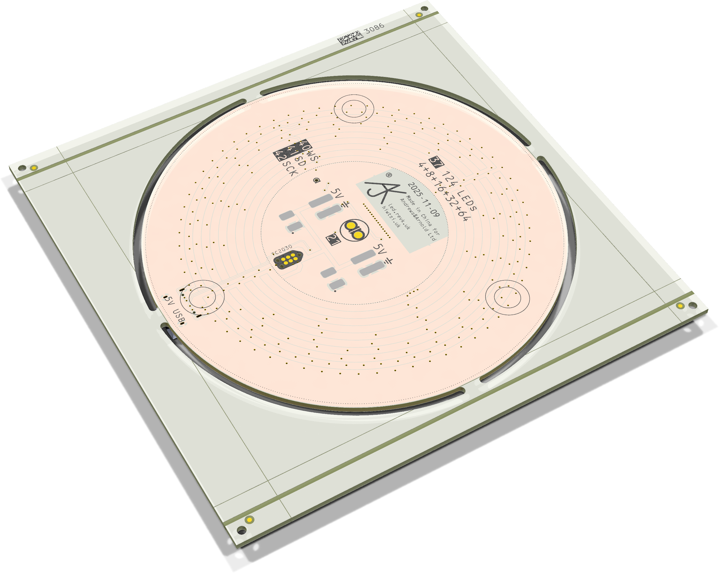
PCB/Coaster2/Coaster-panel-bottom.png
