revk/ESP32-LED/PCB/Coaster3/Coaster-bottom.png

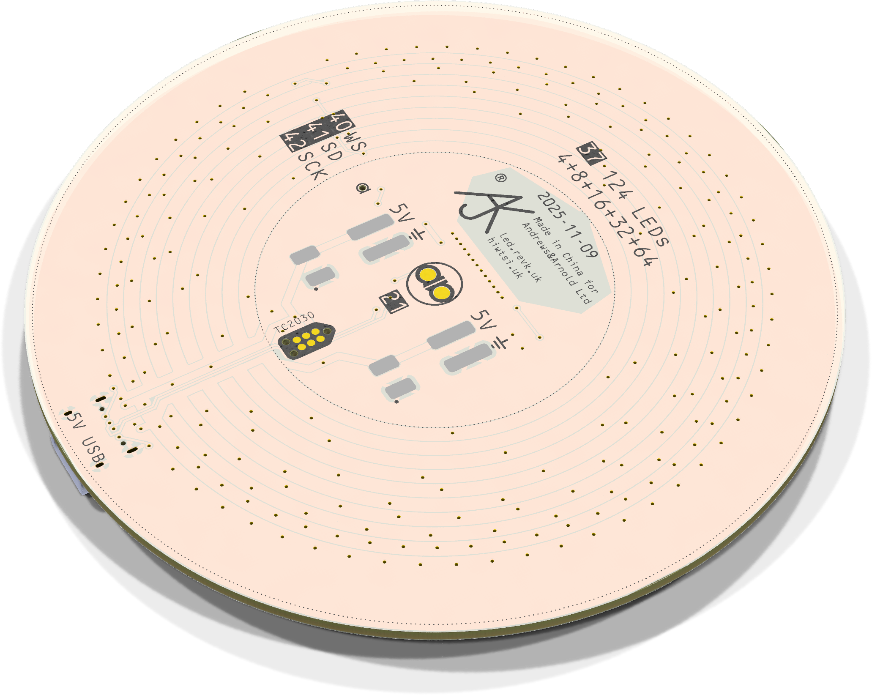
PCB/Coaster3/Coaster-bottom.png
