revk/ESP32-LED/PCB/Gate/Stargate.png

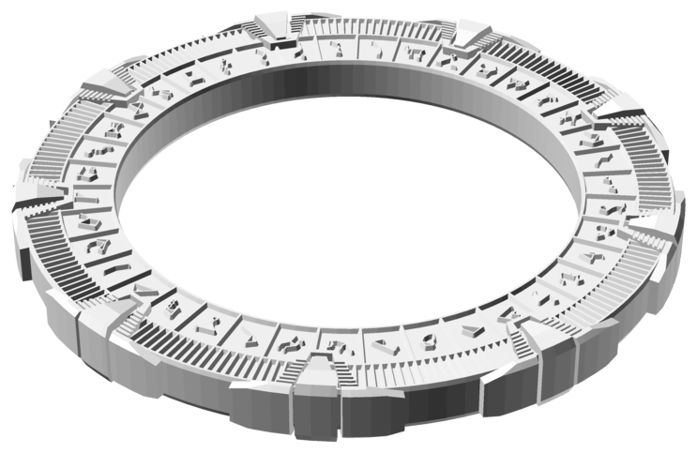
PCB/Gate/Stargate.png
