revk/ESP32-LED/PCB/Gate/StargateBottom.png

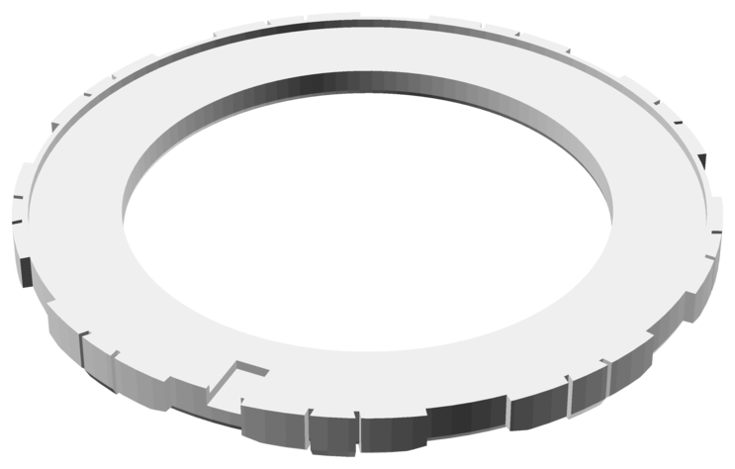
PCB/Gate/StargateBottom.png
