revk/ESP32-LED/PCB/Gate/StargateRamp.png

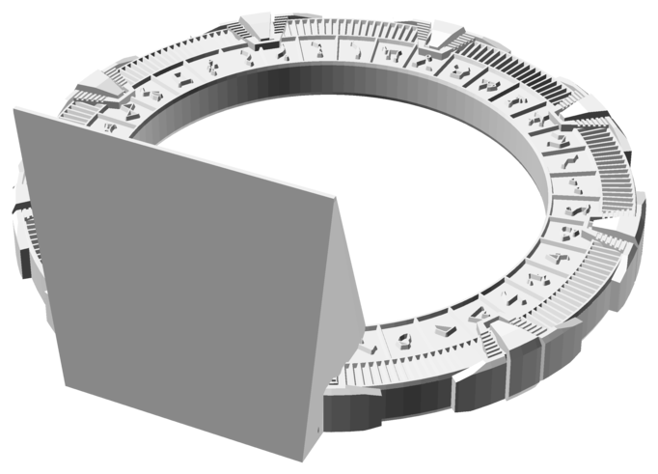
PCB/Gate/StargateRamp.png
