revk/ESP32-LED/PCB/Gate/StargateRampBottom.png

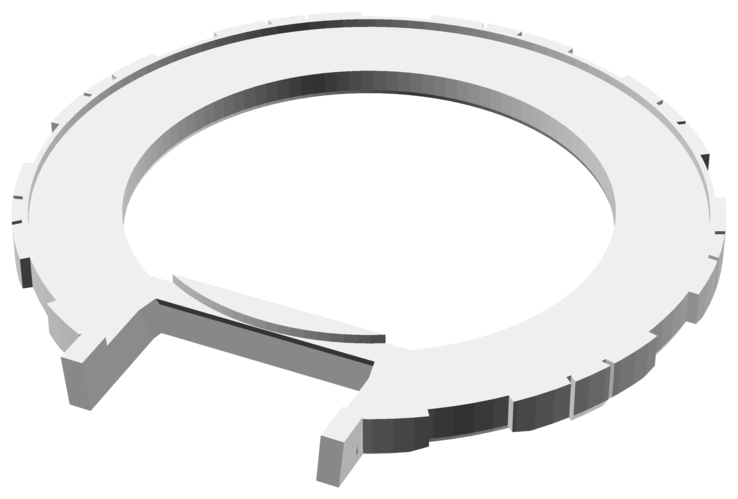
PCB/Gate/StargateRampBottom.png
