revk/ESP32-LED/PCB/Gate/StargateRampTop.png

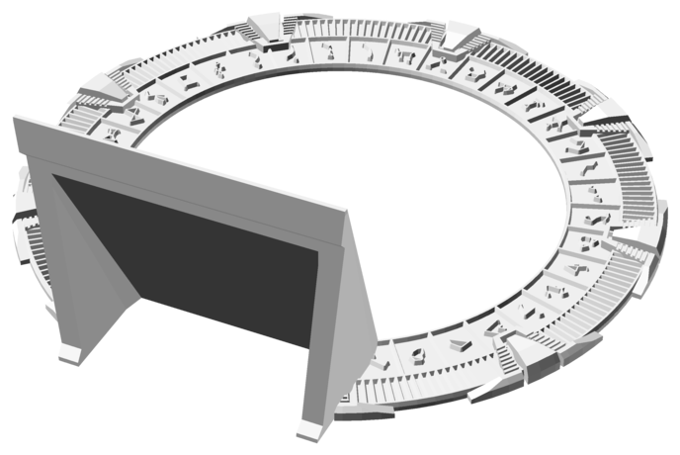
PCB/Gate/StargateRampTop.png
