revk/ESP32-LED/PCB/Gate/StargateTop.png

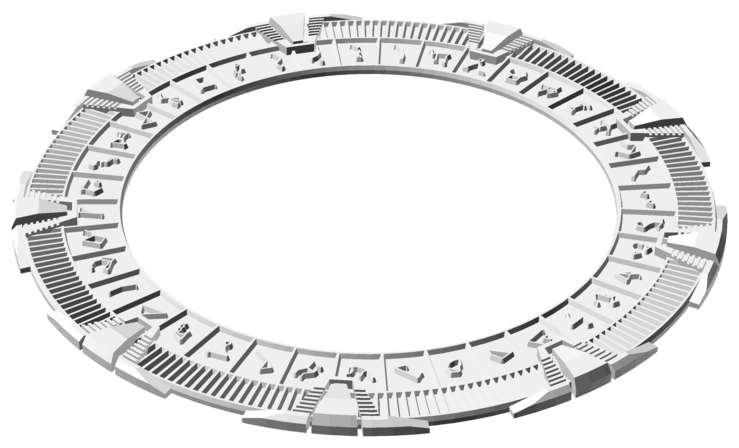
PCB/Gate/StargateTop.png
