revk/ESP32-LED/PCB/LEDC/production/bom.csv

Designator | Footprint | Quantity | Value | LCSC Part #
C1 | C_1206 | 1 | 220uF | C412252
C10 | C_0603_ | 1 | 10uF 35V | C194427
C11 | C_0603_ | 1 | 10uF 6.3V | C1691
C12 | C_0603_ | 1 | 100nF
C13, C2, C4, C8 | C_0402 | 4 | 100nF
C14 | C_0603 | 1 | 47uF
C3 | C_0603 | 1 | 22uF
C5, C6, C7 | C_0805 | 3 | 22uF 35V | C6119901
C9 | C_0402 | 1 | 1uF
D1 | SMD1615 | 1 | XL-1010RGBC-WS2812B | C5349954
D2 | DFN1006-2L | 1 | ~ | C5137770
J2 | WAGO-2060-453-998-404 | 1 | Wago | C2765056
J5 | USB-C-Socket-H | 1 | USB-C-Socket-H | C709357
L2 | L_4x4_ | 1 | 10uH | C167879
R1 | R_0402 | 1 | 124K | C2933070
R13 | R_0402 | 1 | 4k7 | C25900
R14 | R_0402_ | 1 | 39k2 | C137996
R15 | R_0402_ | 1 | 1M | C26083
R2, R3 | R_0402 | 2 | 10K | C25744
R4 | R_0402_ | 1 | 124k | C2933070
R5, R6 | R_0402 | 2 | 5K1 | C25905
R7 | R_0402 | 1 | 47R | C25118
U1 | ICS43434_MEMS_Mic_Open | 1 | ICS43434_MEMS_Mic | C5656610
U2 | IR-SMD-4P,3.35x3.9mm | 1 | IRMHF384 | C7280961
U6 | ESP32-S3-MINI-1 | 1 | ESP32-S3-MINI-1 | C3013941
U7 | SOT-23-6-MD8942 | 1 | MD8942 | C2684786
