revk/ESP32-LED/PCB/LEDX/production/bom.csv

Designator | Footprint | Quantity | Value | LCSC Part #
C1 | C_0402 | 1 | 100nF
C10, C11, C2, C9 | C_0402 | 4 | 22uF
C3 | C_0402 | 1 | 1uF
C4, C5 | C_0603 | 2 | 10uF 35V | C194427
C6 | C_0603_ | 1 | 10uF 35V | C194427
C7 | C_0603_ | 1 | 10uF 6.3V | C1691
C8 | C_0603_ | 1 | 100nF
D1 | SMD1010 | 1 | XL-1010RGBC-WS2812B | C5349953
D2 | DFN1006-2L | 1 | ~ | C5137770
J2 | WAGO-2060-453-998-404-O | 1 | Conn_01x03 | C2765056
L2 | L_4x4_ | 1 | 10uH
R1 | R_0402 | 1 | 10K
R10 | R_0402_ | 1 | 39k2
R11 | R_0402_ | 1 | 1M
R9 | R_0402_ | 1 | 124k
U1 | ICS43434_MEMS_Mic | 1 | ICS43434_MEMS_Mic | C5656610
U2 | ESP32-S3-MINI-1 | 1 | ESP32-S3-MINI-1 | C3013941
U5 | SOT-23-6-MD8942 | 1 | MD8942 | C2684786
