revk/ESP32-LED/PCB/5x7/production/bom.csv

Designator | Footprint | Quantity | Value | LCSC Part #
C1, C10, C2, C3, C4, C5, C6, C7, C8, C9 | C_0402 | 10 | 330nF
D1, D10, D11, D12, D13, D14, D15, D16, D17, D18, D19, D2, D20, D21, D22, D23, D24, D25, D26, D27, D28, D29, D3, D30, D31, D32, D33, D34, D35, D4, D5, D6, D7, D8, D9 | SMD1010 | 35 | XL-1010RGBC-WS2812B
J1, J2 | 3-PADS | 2 | Conn_01x03
