revk/ESP32-LED/PCB/Test/production/bom.csv

Designator | Footprint | Quantity | Value | LCSC Part #
D1, D10, D2, D3, D4, D5, D6, D7, D8, D9 | SMD1010 | 10 | XL-1010RGBC-WS2812B | C5349953
D11, D12, D13, D14, D15, D16, D17, D18, D19, D20, D41, D42, D43, D44, D45, D46, D47, D48 | SMD1615 | 18 | XL-1615RGBC-WS2812B | C5349954
D21, D22, D23, D24, D25, D26, D27, D28, D29, D30, D31, D32, D33, D34, D35, D36, D37, D38, D39, D40 | SMD2020 | 20 | XL-2020RGBC-WS2812B | C5349955
