revk/ESP32-LED/PCB/Gate/production/bom.csv

Designator | Footprint | Quantity | Value | LCSC Part #
C1, C10, C100, C101, C102, C103, C104, C105, C106, C107, C108, C109, C11, C110, C111, C112, C113, C114, C115, C116, C117, C118, C119, C12, C120, C121, C122, C123, C124, C125, C126, C127, C128, C129, C13, C130, C131, C132, C133, C134, C135, C136, C137, C138, C139, C14, C140, C141, C142, C143, C144, C145, C146, C147, C148, C149, C15, C150, C151, C152, C153, C154, C155, C156, C157, C158, C159, C16, C160, C161, C162, C163, C164, C165, C166, C167, C168, C169, C17, C170, C171, C172, C173, C174, C175, C176, C177, C178, C179, C18, C180, C181, C182, C183, C184, C185, C186, C187, C188, C189, C19, C190, C191, C192, C193, C194, C195, C196, C197, C198, C199, C2, C20, C200, C201, C202, C203, C204, C205, C206, C207, C208, C209, C21, C210, C211, C212, C213, C214, C215, C216, C217, C218, C219, C22, C220, C221, C222, C223, C224, C225, C226, C227, C228, C229, C23, C230, C231, C232, C233, C234, C235, C236, C237, C238, C239, C24, C240, C241, C242, C243, C244, C245, C246, C247, C248, C249, C25, C250, C251, C252, C253, C254, C255, C256, C257, C258, C259, C26, C260, C261, C262, C263, C264, C265, C266, C267, C268, C269, C27, C270, C271, C272, C273, C274, C275, C276, C277, C278, C279 | C_0402 | 200 | 100nF
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
