revk/ESP32-LED/PCB/Gate/StargateRamp.stl

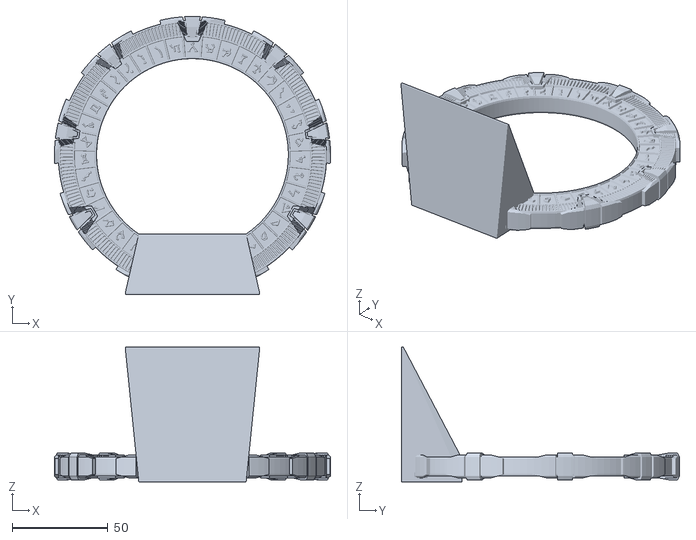
[picture p97: CAD file, 2023-10-25]
PCB/Gate/StargateRamp.stl
144.0 x 145.0 x 70.2
