revk/ESP32-LED/PCB/LEDA/LEDB.stl

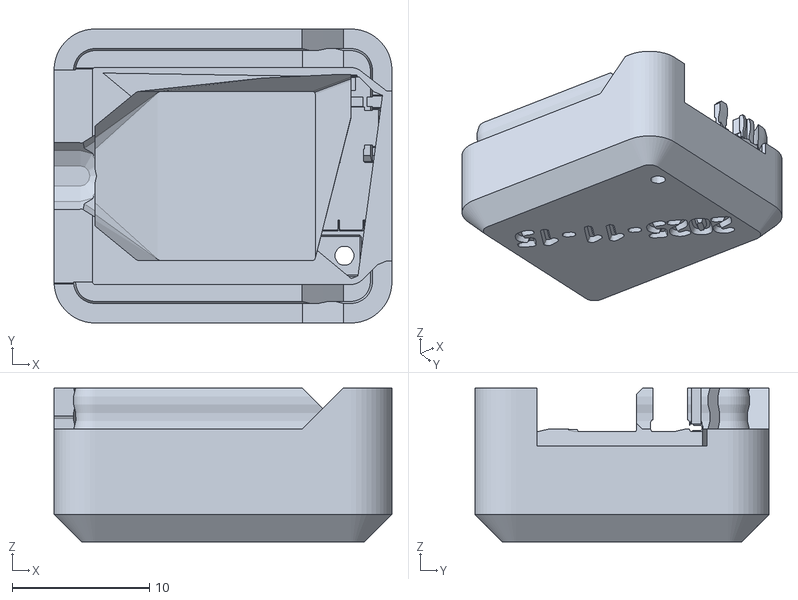
[picture p98: CAD file, 2025-11-15]
PCB/LEDA/LEDB.stl
24.6 x 21.4 x 11.2
