revk/ESP32-LED/PCB/LEDC/LEDB.stl

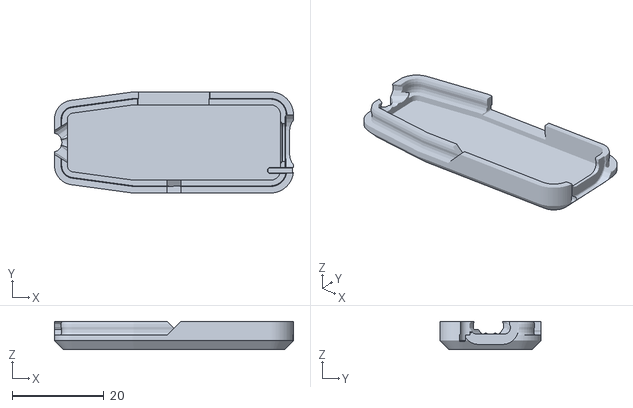
[picture p99: CAD file, 2025-11-15]
PCB/LEDC/LEDB.stl
52.0 x 22.0 x 6.20
