revk/ESP32-LED/PCB/LEDC12/LEDC.stl

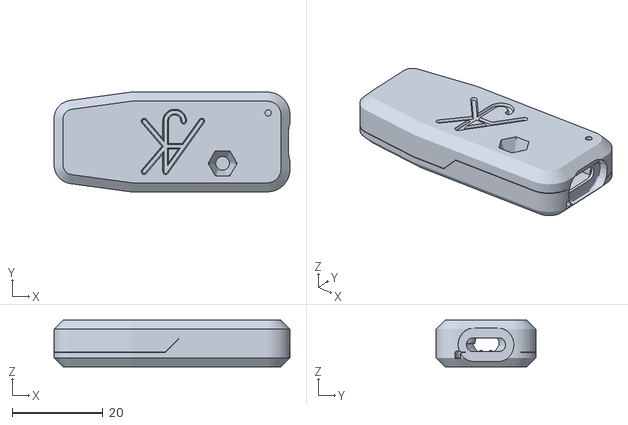
[picture p100: CAD file, 2025-11-15]
PCB/LEDC12/LEDC.stl
52.0 x 22.0 x 10.3
