revk/ESP32-LED/PCB/LEDR/LEDB.stl

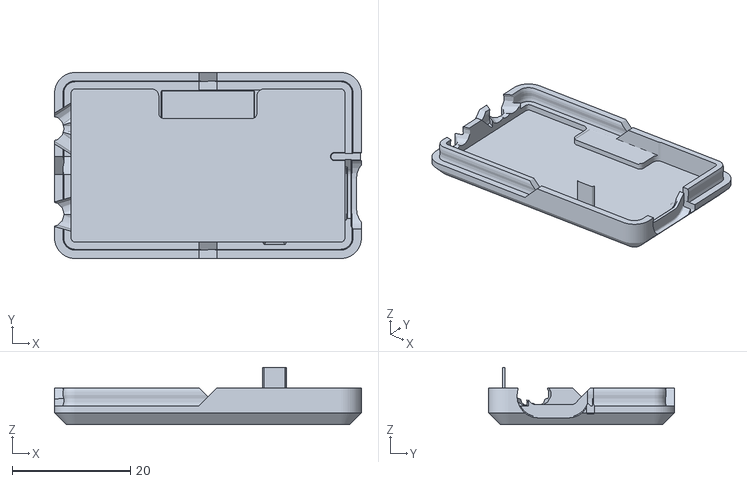
[picture p101: CAD file, 2025-11-15]
PCB/LEDR/LEDB.stl
52.0 x 31.5 x 9.73
