revk/ESP32-LED/PCB/LEDX/LEDB.stl

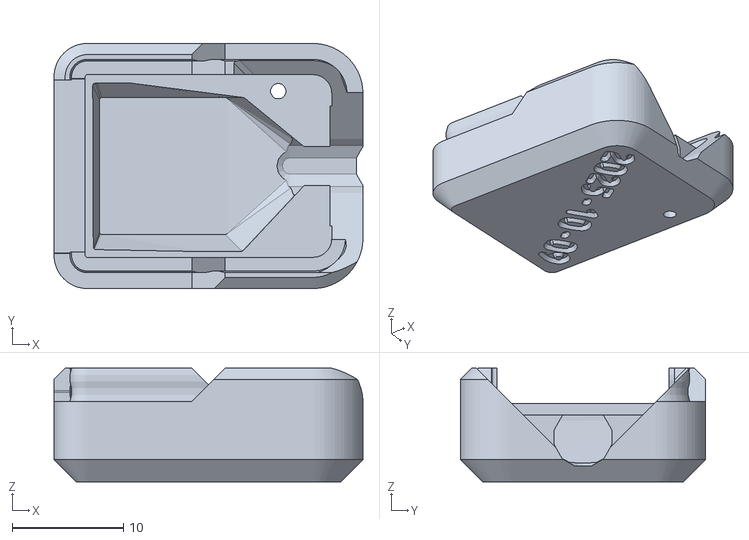
[picture p102: CAD file, 2025-11-15]
PCB/LEDX/LEDB.stl
27.7 x 22.0 x 10.2
