revk/ESP32-LED/PCB/LEDX12/LEDC.stl

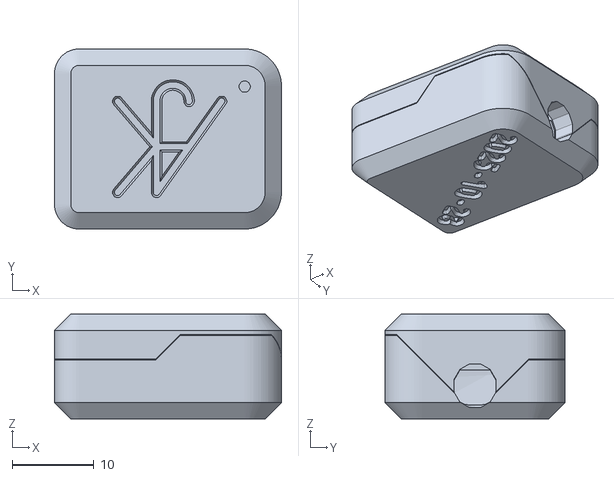
[picture p103: CAD file, 2025-11-15]
PCB/LEDX12/LEDC.stl
27.7 x 22.0 x 12.8
