revk/ESP32-LED/PCB/Test/LEDT.stl

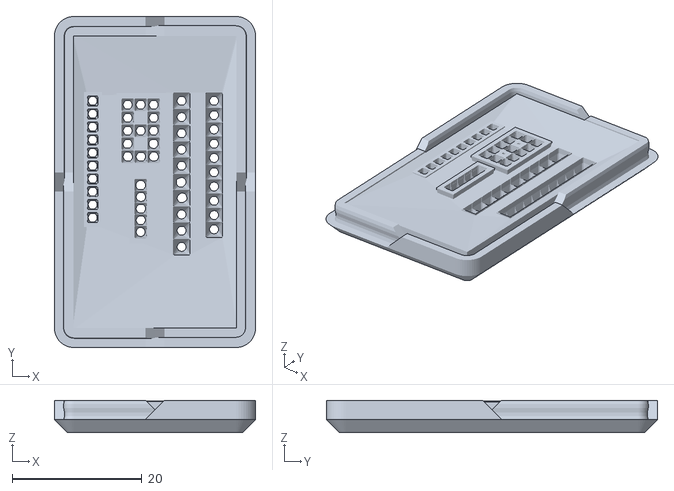
[picture p104: CAD file, 2025-11-09]
PCB/Test/LEDT.stl
31.0 x 51.0 x 4.99
