revk/ESP32-LED/PCB/Gate/StargateTop.stl

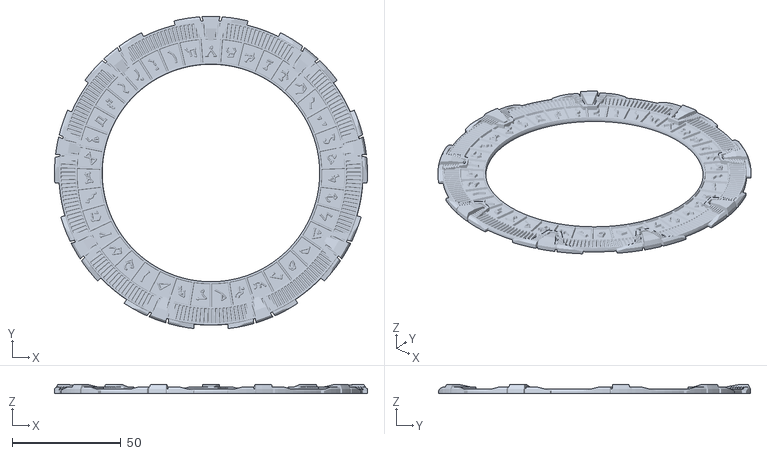
[picture p105: CAD file, 2023-10-25]
PCB/Gate/StargateTop.stl
144.0 x 143.5 x 4.00
