revk/ESP32-LED/PCB/LEDA/LEDC.stl

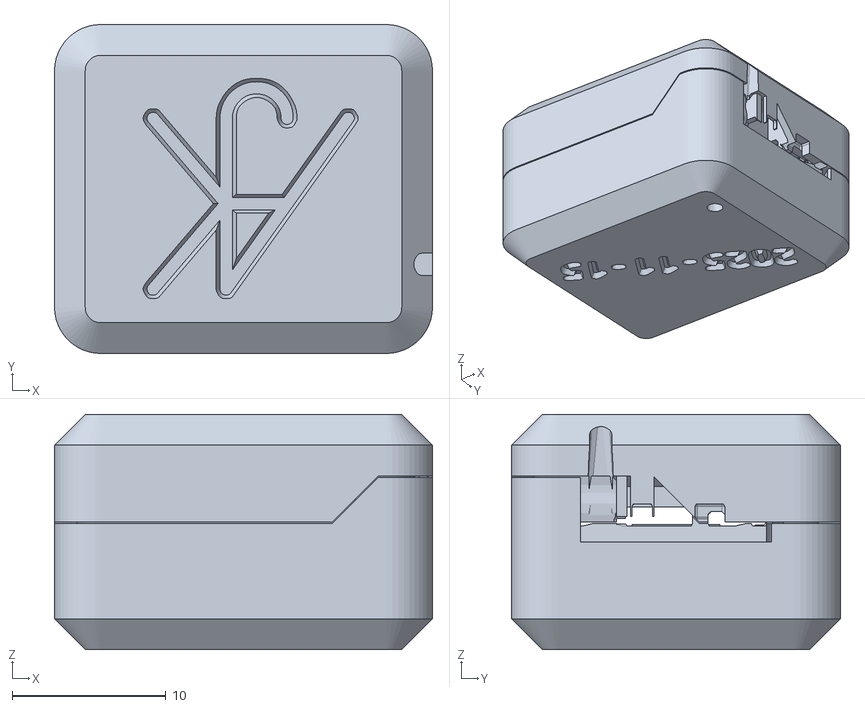
[picture p106: CAD file, 2025-11-15]
PCB/LEDA/LEDC.stl
24.6 x 21.4 x 15.3
