revk/ESP32-LED/PCB/LEDC/LEDT.stl

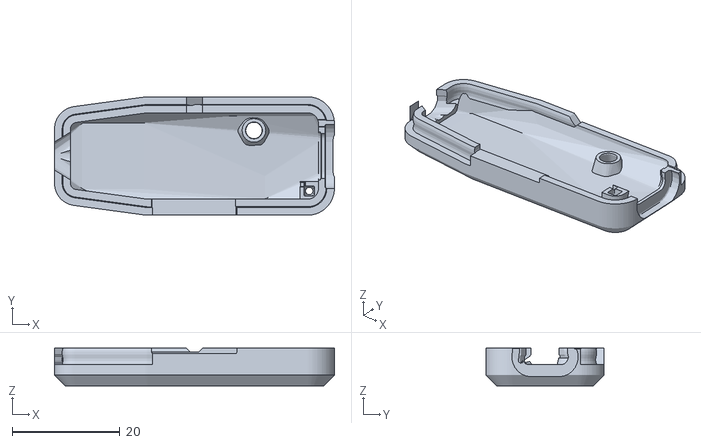
[picture p107: CAD file, 2025-11-09]
PCB/LEDC/LEDT.stl
52.0 x 22.0 x 6.99
