revk/ESP32-LED/PCB/LEDR/LEDC.stl

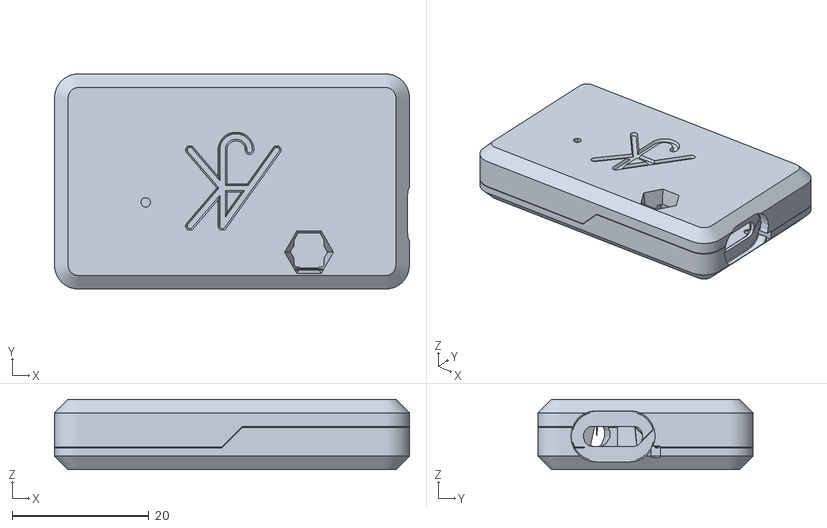
[picture p108: CAD file, 2025-11-09]
PCB/LEDR/LEDC.stl
52.0 x 31.5 x 10.3
