revk/ESP32-LED/PCB/LEDX/LEDT.stl

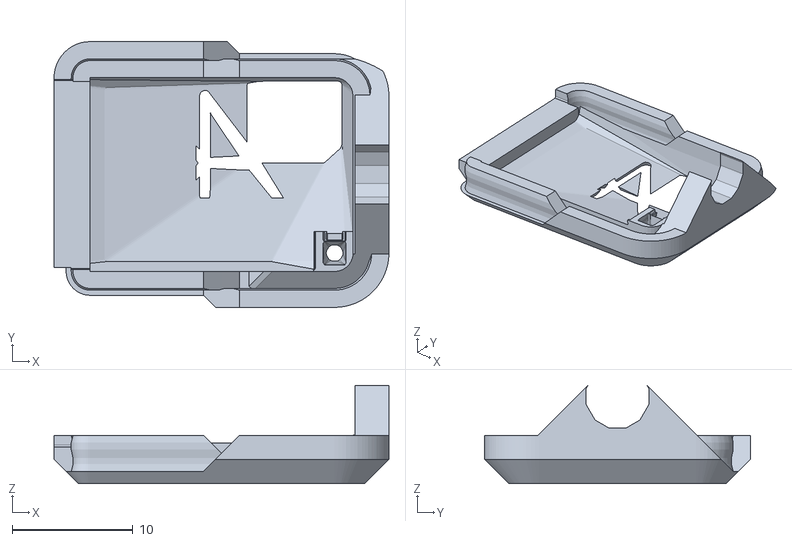
[picture p109: CAD file, 2025-11-09]
PCB/LEDX/LEDT.stl
27.7 x 22.0 x 8.12
