revk/ESP32-LED/PCB/Test/LEDB.stl

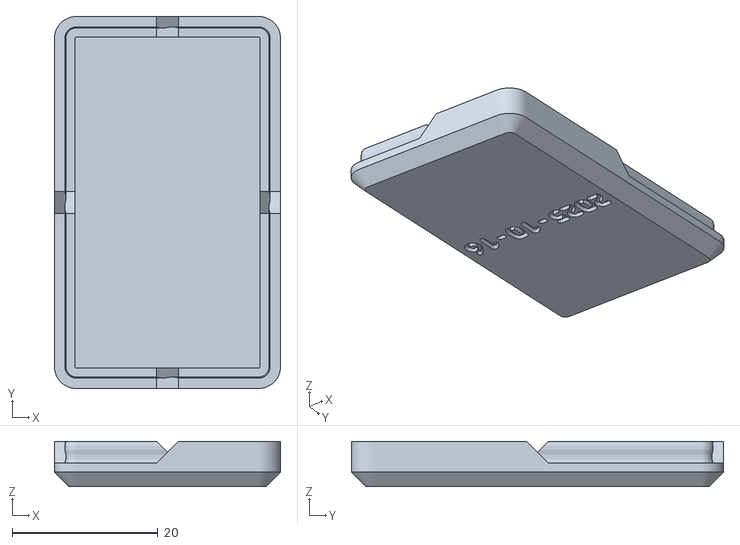
[picture p110: CAD file, 2025-11-09]
PCB/Test/LEDB.stl
31.0 x 51.0 x 6.20
