revk/ESP32-LED/PCB/Gate/Stargate.stl

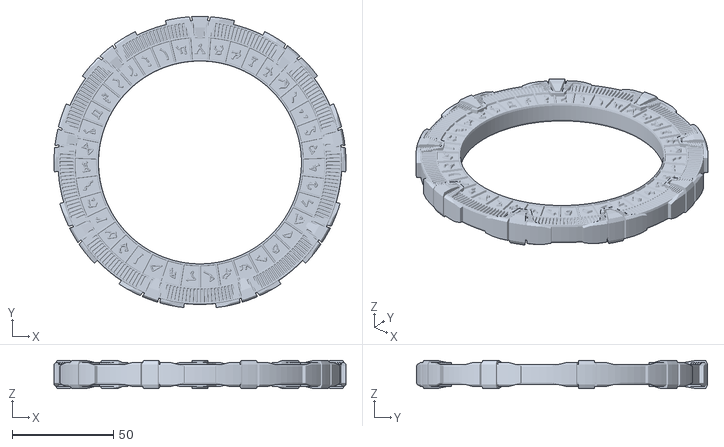
[picture p111: CAD file, 2023-10-25]
PCB/Gate/Stargate.stl
144.0 x 143.5 x 14.0
