revk/ESP32-LED/PCB/LEDA/LEDT.stl

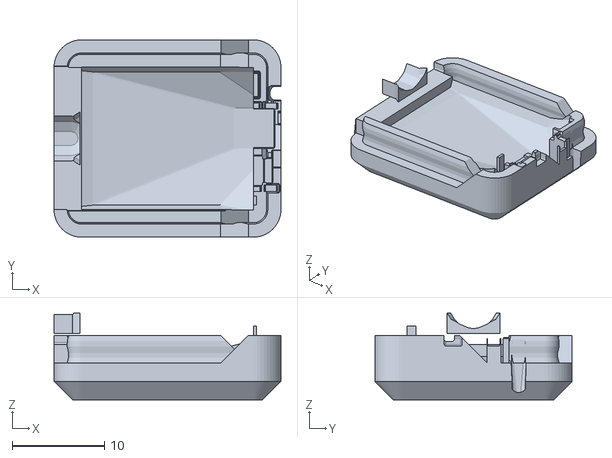
[picture p112: CAD file, 2025-11-15]
PCB/LEDA/LEDT.stl
24.6 x 21.4 x 9.40
