revk/ESP32-LED/PCB/LEDR/LEDT.stl

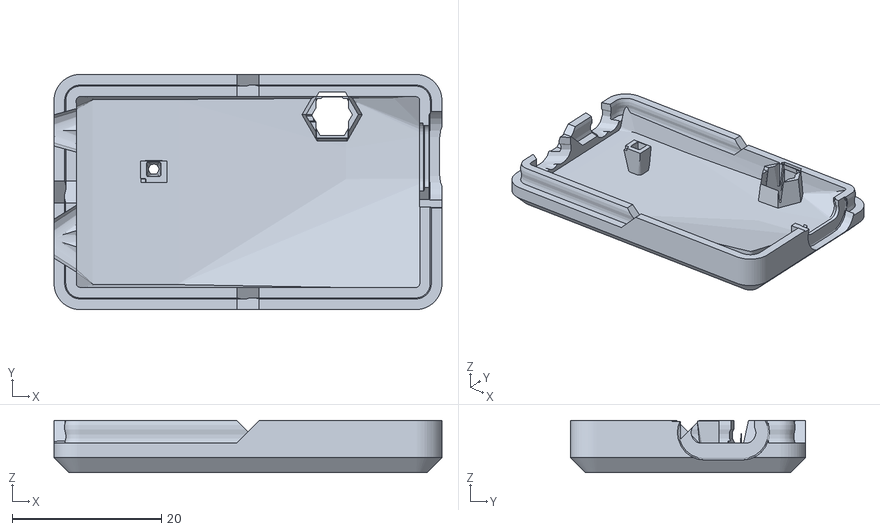
[picture p113: CAD file, 2025-11-09]
PCB/LEDR/LEDT.stl
52.0 x 31.5 x 7.00
