revk/ESP32-LED/PCB/LEDX/LEDC.stl

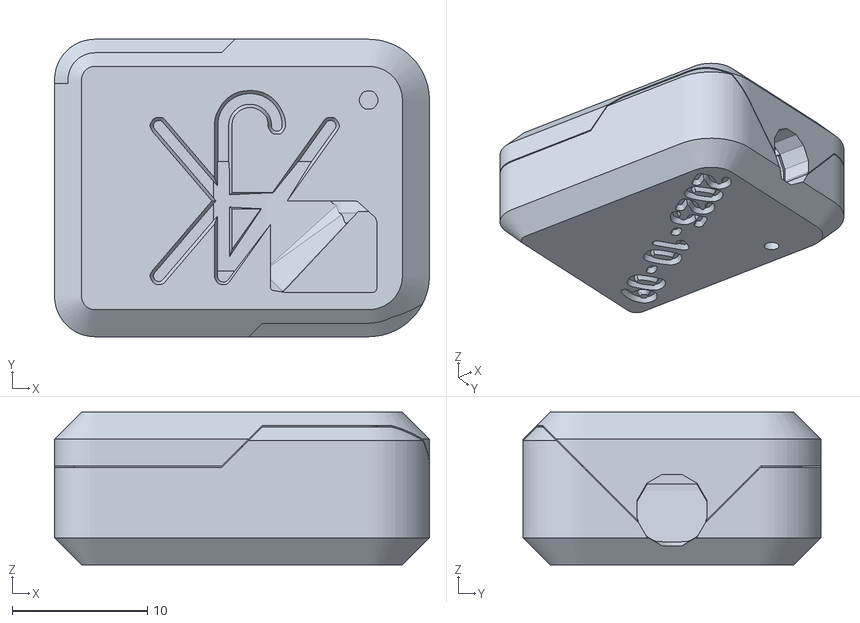
[picture p114: CAD file, 2025-11-09]
PCB/LEDX/LEDC.stl
27.7 x 22.0 x 11.3
