revk/ESP32-LED/PCB/LEDX12/LEDT.stl

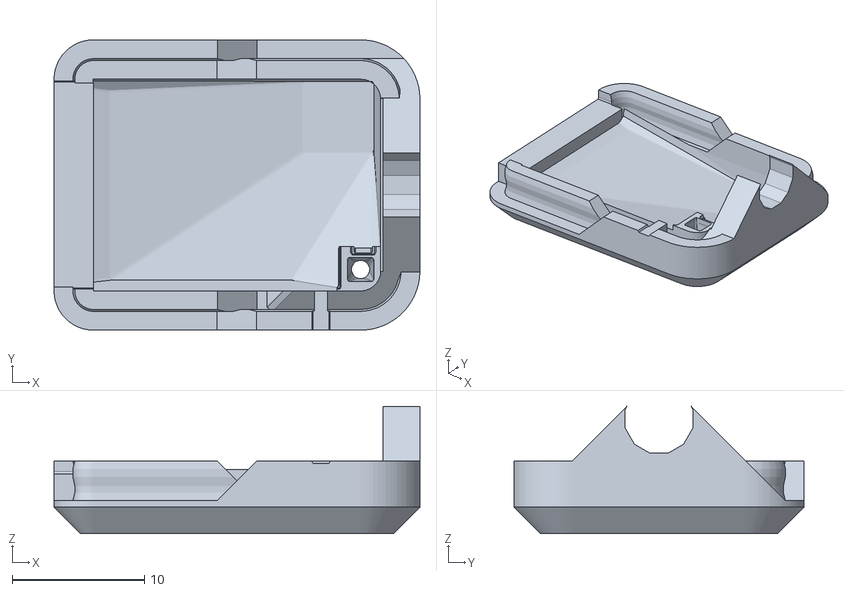
[picture p115: CAD file, 2025-11-09]
PCB/LEDX12/LEDT.stl
27.7 x 22.0 x 9.62
