revk/ESP32-LED/PCB/Gate/StargateRampBottom.stl

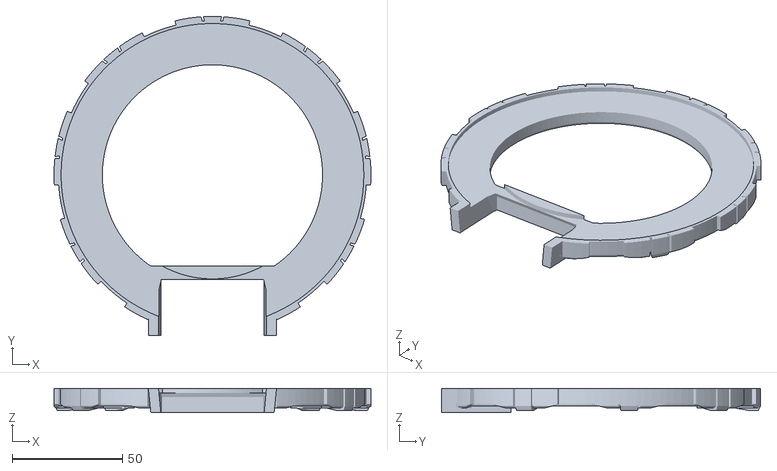
[picture p116: CAD file, 2023-10-25]
PCB/Gate/StargateRampBottom.stl
144.0 x 145.0 x 11.0
