revk/ESP32-LED/PCB/Gate/StargateRampTop.stl

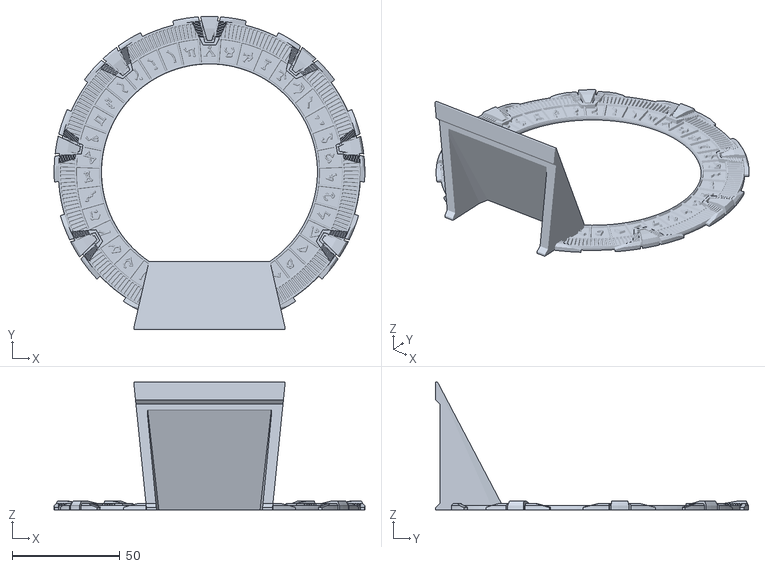
[picture p117: CAD file, 2023-10-25]
PCB/Gate/StargateRampTop.stl
144.0 x 145.0 x 59.2
