revk/ESP32-LED/PCB/Gate/StargateBottom.stl

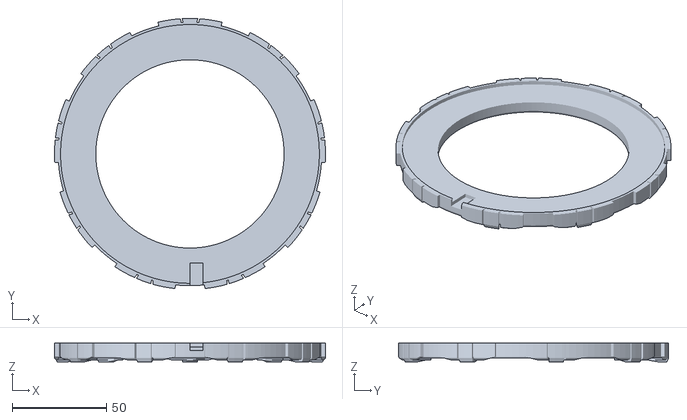
[picture p118: CAD file, 2023-10-25]
PCB/Gate/StargateBottom.stl
144.0 x 143.5 x 10.0
