revk/ESP32-LED/PCB/Gate/Glyphs.dxf

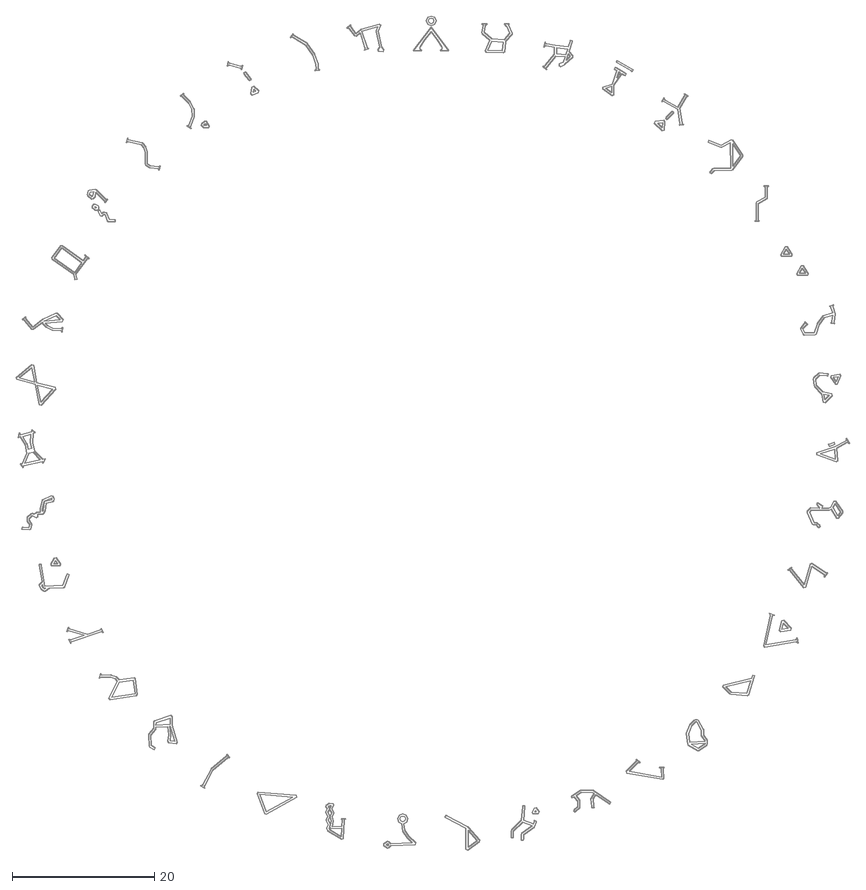
[picture p119: CAD file, 2023-10-11]
PCB/Gate/Glyphs.dxf
117.0 x 117.1
