revk/ESP32-LED/(list of files, cad)

Other CAD files:
PCB/LEDC12/LEDB.stl
PCB/LEDX12/LEDB.stl
PCB/LEDC/LEDC.stl
PCB/LEDC12/LEDT.stl
PCB/LEDA/LEDC.scad
PCB/LEDA/LEDT.scad
PCB/LEDC/LEDB.scad
PCB/LEDC/LEDC.scad
PCB/LEDC/LEDT.scad
PCB/LEDC12/LEDB.scad
PCB/LEDC12/LEDC.scad
PCB/LEDC12/LEDT.scad
PCB/LEDR/LEDB.scad
PCB/LEDR/LEDC.scad
PCB/LEDR/LEDT.scad
PCB/LEDX/LEDB.scad
PCB/LEDX/LEDC.scad
PCB/LEDX/LEDT.scad
PCB/LEDX12/LEDB.scad
PCB/LEDX12/LEDC.scad
PCB/LEDX12/LEDT.scad
PCB/Test/LEDB.scad
PCB/Test/LEDC.scad
PCB/Test/LEDT.scad
