revk/ESP32-LED/Manuals/Drop.md

# Drop

The `drop` effect has additional settings which can be set in a preset JSON

|Setting|Meaning|
|---|---|
|`balls`|How many balls|
|`height`|Height of segment (m)|
|`gravity`|Gravity (m/s²)|
|`size`|Size of ball (m)|
|`drag`|Loss of speed per scan (0-1)|
|`bounce`|Amount of bounce (0-1)|
|`up`|Boolean, reverses strip|
|`random`|Boolean, use random *position* picking palette for each ball rather than time|
