revk/ESP32-LED/Manuals/USB-A-Bottom.jpg

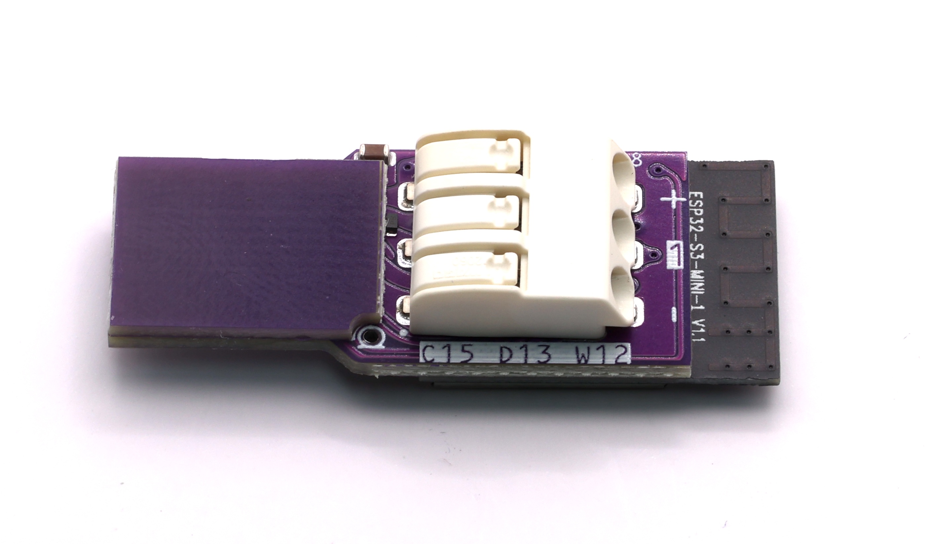
Manuals/USB-A-Bottom.jpg
