revk/ESP32-LED/Manuals/USB-A-Top.jpg

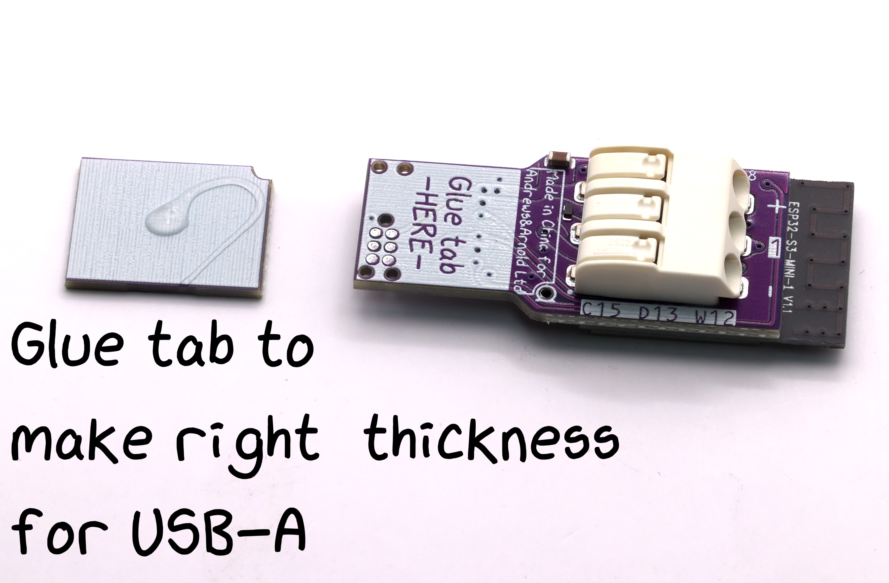
Manuals/USB-A-Top.jpg
