revk/ESP32-LED/Manuals/USB-C-Top.jpg

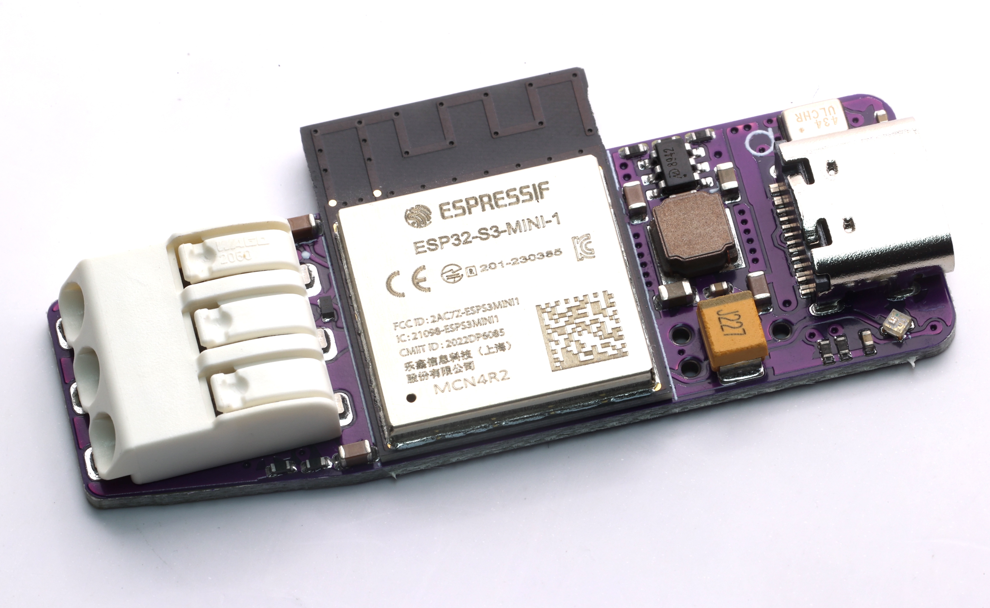
Manuals/USB-C-Top.jpg
