revk/ESP32-LED/PCB/Test/LED-90.png

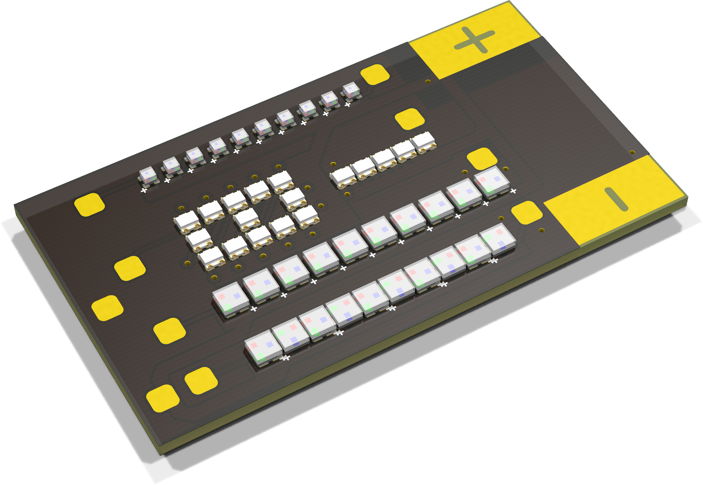
PCB/Test/LED-90.png
