revk/ESP32-LED/PCB/Test/LED-bottom.png

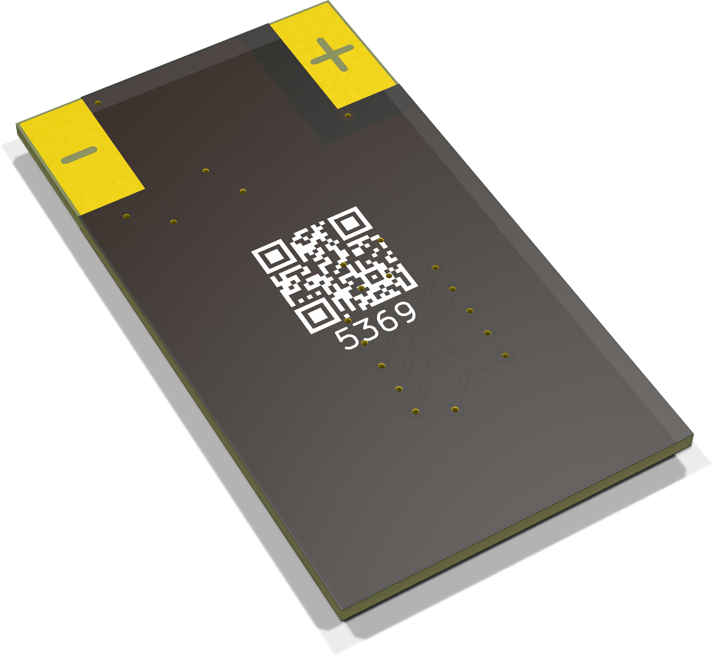
PCB/Test/LED-bottom.png
