revk/ESP32-LED/PCB/Test/LED.png

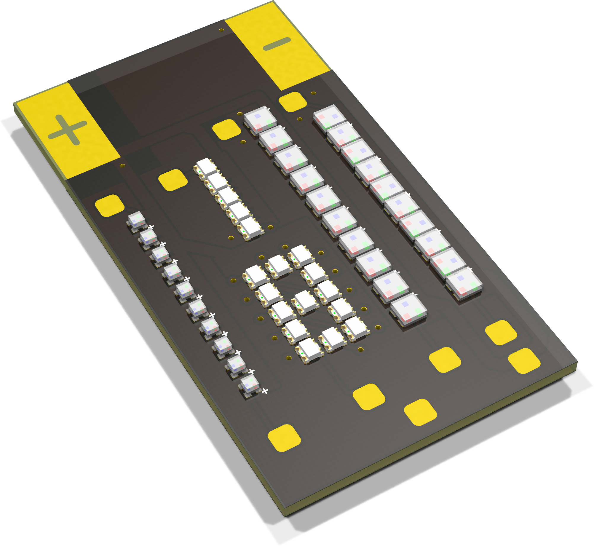
PCB/Test/LED.png
