revk/ESP32-LED/(threads)

Thread 6 (2024-09-24):

Missing Case

b-bilko, 2024-09-24:
Hi,

I have a board on order from amazon, and came here looking for the mentioned case design.

Can you add this to the repo for easy reference?

Many thanks!

revk, 2024-09-24:
Surley
https://github.com/revk/ESP32-LED/blob/main/PCB/LED/LED-Screw.stl
and
https://github.com/revk/ESP32-LED/blob/main/PCB/LED/LED.stl

Closed 2024-09-24.

Thread 7 (2024-09-25):

Board flashing, but not showing AP.

b-bilko, 2024-09-25:
Hi,

I have my board from Amazon, and flashed it with WLED today.

First use I was getting lights flashing blue and green lights, but not I'm not getting any lights.

It still shows up as a Com port, and WLED seems to flash ok, but I don't get the AP for next stage config.

Do I have a faulty board, or is there something I can do to recover it?

revk, 2024-09-26:
If you flash WLED it is kind of down to WLED - the processor with WiFi is self contained, if it shows as a com port, it means it is powered correctly, so not a lot that could be faulty (apart from code).

You flashed the right WLED build? ESP32 S3 4M ?

jsouto77, 2024-09-28:
Im having exactly the same issue as thee OP . I have flashed every build of ESP32 S3 4M  and it just doesn't work unfortunately. It's a good thing I only bought 1 to try and not the whole 4 that were available.

Was this actually tested before advertising WLED compatibility?

revk, 2024-09-28:
We have them working with WLED, no problem. Flashed using the web based WLED flasher, using the ESP32S3 4M build. I have flashed them myself and had them working.

jsouto77, 2024-09-28:
> We have them working with WLED, no problem. Flashed using the web based WLED flasher, using the ESP32S3 4M build. I have flashed them myself and had them working.

Ive used all the files you said from https://wled-install.github.io  to no avail. Flashing the your bin file back in does revive the controller to a working state as per received.

revk, 2024-09-28:
Did you try using their web based flasher? That is literally what I did, and just worked.

jsouto77, 2024-09-28:
> Did you try using their web based flasher? That is literally what I did, and just worked.

Yes. Used https://install.wled.me/  which only allows release selection. This was actually the first tool I used.

revk, 2024-09-28:
This is what I have just tried...

- I went to https://wled-install.github.io in Chrome
- Selected English
- Selected ESP32-S3 (4M Flash)
- Clicked Agree
- Clicked Install
- Selected USB JTAG/serial debug unit (cu.usbmodem71201)
- Selected INSTALL WLED (ESP32-S3, 4M)
- Selected INSTALL
- Waited while it installed

It then appeared as a WiFi AP, so working fine.

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

jsouto77, 2024-09-28:
I have tried the exact same multiple times. It flashes but the device becomes dead and no lights and does not ask to configure at the end. I have also unplugged and plugged back in and left it for a while but still no lights on board and no WLED wifi to be seen.

If I flash back with your bin file, it installs with an error at the end saying failed but after unplugging and plugging back in the lights on the device come on and I get the wifi for it just as when received and works fine.

revk, 2024-09-28:
Yes, the usb port will be different, but I don't see how it would break. Clearly the ESP32S3 module is OK (else my code would not run), but I cannot see why WLED would have an issue. It may be worth asking on the WLED forums if they have any clue. There really is not a lot to go wrong - it has power supply, an ESP32S3 module, and connection to terminals for LED.

revk, 2024-09-28:
It may be worth trying to build WLED with the GPIO we use pre-defined?

jsouto77, 2024-10-01:
> It may be worth trying to build WLED with the GPIO we use pre-defined?

If you would kindly provide one, that would be great. In the meantime ive received some other esp32 chips and can load WLED on them without issues.

revk, 2024-10-01:
I have no how to build WLED

jsouto77, 2024-10-14:
Was about to shelf this today and gave it another go. The latest bets flash 4mb S3 worked and i managed to get it work on GPIO 4 for communication.

revk, 2024-10-14:
Ah good

jsouto77, 2024-10-14:
Can comfortably say it's a very nice board in its own right. Nice and compact and perfect if you just want a straight forward led controller AND you dont want any extras such a reactive sound etc... Very neat.

My sole opinion is that you should just ship it with WLED  pre-installed.

As you have some manufacturing setup, I would advise you make something like quinLED for this side of the pond :)

revk, 2024-10-14:
Thanks for feedback

Closed 2024-10-14.

Thread 8 (2024-09-27):

can't get led strip to light up

DuplicantWood, 2024-09-27:
Hi i bought this on amazon with an WS2812B led strip ([specifically this one](https://www.amazon.co.uk/YUNBO-Individually-Addressable-NO-Waterproof-Flexible/dp/B07Q9KCC6M/)). I've got it powered on and connected to  my internet but the led strip won't light up.

I've set the led amount in settings and tried using the basic effects but nothing happens.

Any idea what i could be doing wrong?

Thanks

DuplicantWood, 2024-09-27:
Nevermind it's a faulty led strip (just tested with an arduino)

Sorry about that, this is a very cool product.

revk, 2024-09-27:
Thanks

Closed 2024-09-27.

Thread 9 (2024-09-29):

Level shifter and switch off

njh, 2024-09-29:
I really like the simplicity / compactness of the board, but it would be great it it had these two features:
- Level shifter to bring the data pin to 5v, so I can use it with my [24V RGBW strip](https://www.aliexpress.com/item/1005005997509613.html)
- A way of switching off the power to the strip, when it is completely off, so save energy

Lots of boards use relays to switch off the strip - but I guess a transistor / MOFSET could be used as an alternative?

BTW, I bought one of these from Amazon ([B0C1W1XJS8](https://www.amazon.co.uk/dp/B0C1W1XJS8)). I was slightly surprised to receive a HIWTSI version - no AJK branding.

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

revk, 2024-09-29:
We have gone for hiwtsi and AJK on the latest boards. Hiwtsi is my son's.

Level shifter is a pain as we done have a 5V as such, just whatever power is. So would code when using USB, worth a thought, but if powered from the strip at 24V it would drive 24V.

Board power using a FET, again, good idea, but you have to think of the current. I guess that would only work when USB, and would mean we can't power from the strip (which we can now).

So tricky ones. Maybe with some links to select. But quickly becomes way less compact.

But thanks for feedback.

Thread 10 (2024-10-27):

Feature Request: brightness control

njh, 2024-10-27:
Please can you an overall brightness control, which scales the output of running apps before passing the values to the LED strip?

* Slider on web control (between 0 and 100%)
* Command and status of brightness via MQTT

Thanks!

revk, 2024-10-27:
MQTT has a brightness and HA sets that anyway.

There is also a global max setting for each of R G and B in settings.

njh, 2024-10-27:
I don't know why I am so resistant to installing HomeAssistant.
I am running out of excuses not to install it.

I am attempting to use [HomeBridge](https://homebridge.io/) + [MQTT Thing](https://github.com/arachnetech/homebridge-mqttthing) to do basic RGBW LED strip control.

revk, 2024-10-27:
Ok but brightness is still a setting at MQTT and there are still the global settings.

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

Closed 2024-10-27.

Thread 15 (2024-12-13):

Backup/recover settings

NiccyB, 2024-12-13:
Is it possible to backup/recover the current settings? If not, is it possible this could be added?

revk, 2024-12-13:
Can be done via MQTT

NiccyB, 2024-12-13:
Ah. OK. I think the problem is then that I can't find the documentation for the board - neither website shown on the board seems to have any details about what functionality is available.

revk, 2024-12-13:
Main thing is the GPIOs marked on the board. The GitHub has the actual kicad schematics if needed.

revk, 2024-12-13:
Main thing is the GPIOs marked on the board. The GitHub has the actual kicad schematics if needed.
