revk/ESP32-LED/main/settings.h

// Settings
// Generated from:-
// main/settings.def
// components/ESP32-RevK/settings.def

#include <stdint.h>
#include <stddef.h>
typedef struct revk_settings_s revk_settings_t;
struct revk_settings_s {
 void *ptr;
 const char name[16];
 const char *def;
 union {
  const char *flags;
  const char *enums;
 };
 const char *old;
 const char *unit;
 const char *comment;
 uint16_t size;
 uint8_t group;
 uint8_t bit;
 uint8_t dot:4;
 uint8_t len:4;
 uint8_t type:3;
 uint8_t decimal:5;
 uint8_t digits:5;
 uint8_t array:7;
 uint8_t malloc:1;
 uint8_t revk:1;
 uint8_t live:1;
 uint8_t hide:1;
 uint8_t fix:1;
 uint8_t set:1;
 uint8_t hex:1;
 uint8_t base32:1;
 uint8_t base64:1;
 uint8_t secret:1;
 uint8_t dq:1;
 uint8_t rtc:1;
 uint8_t gpio:1;
 uint8_t isenum:1;
};
#define	STRIPS	5
#ifdef	CONFIG_REVK_LED
#ifdef	CONFIG_REVK_LED_FULL
extern const char REVK_SETTINGS_LEDTYPE_ENUMS[];
enum {
REVK_SETTINGS_LEDTYPE_WS2812_GRB,
REVK_SETTINGS_LEDTYPE_WS2812_GBR,
REVK_SETTINGS_LEDTYPE_WS2812_RGB,
REVK_SETTINGS_LEDTYPE_WS2812_RBG,
REVK_SETTINGS_LEDTYPE_WS2812_BGR,
REVK_SETTINGS_LEDTYPE_WS2812_BRG,
REVK_SETTINGS_LEDTYPE_WS2812_GRBW,
REVK_SETTINGS_LEDTYPE_WS2812_GBRW,
REVK_SETTINGS_LEDTYPE_WS2812_RGBW,
REVK_SETTINGS_LEDTYPE_WS2812_RBGW,
REVK_SETTINGS_LEDTYPE_WS2812_BGRW,
REVK_SETTINGS_LEDTYPE_WS2812_BRGW,
REVK_SETTINGS_LEDTYPE_SK6812_GRB,
REVK_SETTINGS_LEDTYPE_SK6812_GBR,
REVK_SETTINGS_LEDTYPE_SK6812_RGB,
REVK_SETTINGS_LEDTYPE_SK6812_RBG,
REVK_SETTINGS_LEDTYPE_SK6812_BGR,
REVK_SETTINGS_LEDTYPE_SK6812_BRG,
REVK_SETTINGS_LEDTYPE_SK6812_GRBW,
REVK_SETTINGS_LEDTYPE_SK6812_GBRW,
REVK_SETTINGS_LEDTYPE_SK6812_RGBW,
REVK_SETTINGS_LEDTYPE_SK6812_RBGW,
REVK_SETTINGS_LEDTYPE_SK6812_BGRW,
REVK_SETTINGS_LEDTYPE_SK6812_BRGW,
REVK_SETTINGS_LEDTYPE_XING_GRB,
REVK_SETTINGS_LEDTYPE_XING_GBR,
REVK_SETTINGS_LEDTYPE_XING_RGB,
REVK_SETTINGS_LEDTYPE_XING_RBG,
REVK_SETTINGS_LEDTYPE_XING_BGR,
REVK_SETTINGS_LEDTYPE_XING_BRG,
REVK_SETTINGS_LEDTYPE_XING_GRBW,
REVK_SETTINGS_LEDTYPE_XING_GBRW,
REVK_SETTINGS_LEDTYPE_XING_RGBW,
REVK_SETTINGS_LEDTYPE_XING_RBGW,
REVK_SETTINGS_LEDTYPE_XING_BGRW,
REVK_SETTINGS_LEDTYPE_XING_BRGW,
};
#else
extern const char REVK_SETTINGS_LEDTYPE_ENUMS[];
enum {
REVK_SETTINGS_LEDTYPE_GRB,
REVK_SETTINGS_LEDTYPE_GBR,
REVK_SETTINGS_LEDTYPE_RGB,
REVK_SETTINGS_LEDTYPE_RBG,
REVK_SETTINGS_LEDTYPE_BGR,
REVK_SETTINGS_LEDTYPE_BRG,
REVK_SETTINGS_LEDTYPE_GRBW,
REVK_SETTINGS_LEDTYPE_GBRW,
REVK_SETTINGS_LEDTYPE_RGBW,
REVK_SETTINGS_LEDTYPE_RBGW,
REVK_SETTINGS_LEDTYPE_BGRW,
REVK_SETTINGS_LEDTYPE_BRGW,
};
#endif
#else
extern const char REVK_SETTINGS_LEDTYPE_ENUMS[];
enum {
REVK_SETTINGS_LEDTYPE_WS2812_GRB,
REVK_SETTINGS_LEDTYPE_WS2812_GBR,
REVK_SETTINGS_LEDTYPE_WS2812_RGB,
REVK_SETTINGS_LEDTYPE_WS2812_RBG,
REVK_SETTINGS_LEDTYPE_WS2812_BGR,
REVK_SETTINGS_LEDTYPE_WS2812_BRG,
REVK_SETTINGS_LEDTYPE_WS2812_GRBW,
REVK_SETTINGS_LEDTYPE_WS2812_GBRW,
REVK_SETTINGS_LEDTYPE_WS2812_RGBW,
REVK_SETTINGS_LEDTYPE_WS2812_RBGW,
REVK_SETTINGS_LEDTYPE_WS2812_BGRW,
REVK_SETTINGS_LEDTYPE_WS2812_BRGW,
REVK_SETTINGS_LEDTYPE_SK6812_GRB,
REVK_SETTINGS_LEDTYPE_SK6812_GBR,
REVK_SETTINGS_LEDTYPE_SK6812_RGB,
REVK_SETTINGS_LEDTYPE_SK6812_RBG,
REVK_SETTINGS_LEDTYPE_SK6812_BGR,
REVK_SETTINGS_LEDTYPE_SK6812_BRG,
REVK_SETTINGS_LEDTYPE_SK6812_GRBW,
REVK_SETTINGS_LEDTYPE_SK6812_GBRW,
REVK_SETTINGS_LEDTYPE_SK6812_RGBW,
REVK_SETTINGS_LEDTYPE_SK6812_RBGW,
REVK_SETTINGS_LEDTYPE_SK6812_BGRW,
REVK_SETTINGS_LEDTYPE_SK6812_BRGW,
};
#endif
#ifdef  CONFIG_IDF_TARGET_ESP32S3
#else
#endif
#ifdef  CONFIG_REVK_LED_TEST
#else
#endif
#ifdef	CONFIG_REVK_SETTINGS_PASSWORD
#endif
#ifdef  CONFIG_MDNS_MAX_INTERFACES
#else
#endif
#ifdef	CONFIG_REVK_WEB_BETA
#endif
#ifdef  CONFIG_IDF_TARGET_ESP32S3
#endif
#ifdef  CONFIG_IDF_TARGET_ESP32S3
#else
#endif
#ifdef	CONFIG_REVK_BLINK_DEF
#ifdef	CONFIG_REVK_BLINK_WS2812_DEF
#ifdef	CONFIG_REVK_LED_TEST
#endif
#else
#ifdef	CONFIG_REVK_LED_TEST
#else
#endif
#endif
#endif
#ifdef  CONFIG_REVK_APMODE
#ifdef	CONFIG_REVK_APCONFIG
#endif
#endif
#ifdef  CONFIG_REVK_MQTT
#endif
#if     defined(CONFIG_REVK_WIFI) || defined(CONFIG_REVK_MESH)
#endif
#ifndef	CONFIG_REVK_MESH
#endif
#ifdef	CONFIG_REVK_MESH
#endif
typedef struct revk_settings_blob_s revk_settings_blob_t;
struct revk_settings_blob_s {
 uint16_t len;
 uint8_t data[];
};
typedef struct revk_gpio_s revk_gpio_t;
struct revk_gpio_s {
 uint16_t num:10;
 uint16_t strong:1;
 uint16_t weak:1;
 uint16_t pulldown:1;
 uint16_t nopull:1;
 uint16_t invert:1;
 uint16_t set:1;
};
enum {
#define	STRIPS	5
#ifdef	CONFIG_REVK_LED
#ifdef	CONFIG_REVK_LED_FULL
#else
#endif
#else
#endif
#ifdef  CONFIG_IDF_TARGET_ESP32S3
#else
#endif
 REVK_SETTINGS_BITFIELD_irlog,
 REVK_SETTINGS_BITFIELD_irdebug,
 REVK_SETTINGS_BITFIELD_ir4x11,
 REVK_SETTINGS_BITFIELD_ir4x6,
 REVK_SETTINGS_BITFIELD_irha,
#ifdef  CONFIG_REVK_LED_TEST
#else
#endif
 REVK_SETTINGS_BITFIELD_usegamma,
 REVK_SETTINGS_BITFIELD_micright,
 REVK_SETTINGS_BITFIELD_haenable,
 REVK_SETTINGS_BITFIELD_stack,
 REVK_SETTINGS_BITFIELD_gridflip,
 REVK_SETTINGS_BITFIELD_gridsnake,
#ifdef	CONFIG_REVK_SETTINGS_PASSWORD
#endif
#ifdef  CONFIG_MDNS_MAX_INTERFACES
#else
#endif
 REVK_SETTINGS_BITFIELD_otaauto,
#ifdef	CONFIG_REVK_WEB_BETA
 REVK_SETTINGS_BITFIELD_otabeta,
#endif
 REVK_SETTINGS_BITFIELD_dark,
#ifdef  CONFIG_IDF_TARGET_ESP32S3
#endif
#ifdef  CONFIG_IDF_TARGET_ESP32S3
#else
#endif
 REVK_SETTINGS_BITFIELD_prefixapp,
 REVK_SETTINGS_BITFIELD_prefixhost,
#ifdef	CONFIG_REVK_BLINK_DEF
#ifdef	CONFIG_REVK_BLINK_WS2812_DEF
#ifdef	CONFIG_REVK_LED_TEST
#endif
 REVK_SETTINGS_BITFIELD_ws2812rgb,
#else
#ifdef	CONFIG_REVK_LED_TEST
#else
#endif
#endif
#endif
#ifdef  CONFIG_REVK_APMODE
#ifdef	CONFIG_REVK_APCONFIG
#endif
#endif
#ifdef  CONFIG_REVK_MQTT
#endif
#if     defined(CONFIG_REVK_WIFI) || defined(CONFIG_REVK_MESH)
 REVK_SETTINGS_BITFIELD_wifips,
 REVK_SETTINGS_BITFIELD_wifimaxps,
#endif
#ifndef	CONFIG_REVK_MESH
 REVK_SETTINGS_BITFIELD_aplr,
 REVK_SETTINGS_BITFIELD_aphide,
#endif
#ifdef	CONFIG_REVK_MESH
 REVK_SETTINGS_BITFIELD_meshlr,
 REVK_SETTINGS_BITFIELD_meshroot,
#endif
};
typedef struct revk_settings_bits_s revk_settings_bits_t;
struct revk_settings_bits_s {
#define	STRIPS	5
#ifdef	CONFIG_REVK_LED
#ifdef	CONFIG_REVK_LED_FULL
#else
#endif
#else
#endif
#ifdef  CONFIG_IDF_TARGET_ESP32S3
#else
#endif
 uint8_t irlog:1;	// IR log
 uint8_t irdebug:1;	// IR debug
 uint8_t ir4x11:1;	// 4x11 IR colour/LED remote
 uint8_t ir4x6:1;	// 4x6 IR colour/LED remote
 uint8_t irha:1;	// Announce keys to HA config
#ifdef  CONFIG_REVK_LED_TEST
#else
#endif
 uint8_t usegamma:1;	// Use gamme
 uint8_t micright:1;	// I2S Mic use right channel
 uint8_t haenable:1;	// Enable Home Assistant
 uint8_t stack:1;	// Presets have priority, in order, else most recent on top
 uint8_t gridflip:1;	// grid swap up/down
 uint8_t gridsnake:1;	// grid swap each column
#ifdef	CONFIG_REVK_SETTINGS_PASSWORD
#endif
#ifdef  CONFIG_MDNS_MAX_INTERFACES
#else
#endif
 uint8_t otaauto:1;	// OTA auto upgrade
#ifdef	CONFIG_REVK_WEB_BETA
 uint8_t otabeta:1;	// OTA from beta release
#endif
 uint8_t dark:1;	// Default LED off
#ifdef  CONFIG_IDF_TARGET_ESP32S3
#endif
#ifdef  CONFIG_IDF_TARGET_ESP32S3
#else
#endif
 uint8_t prefixapp:1;	// MQTT use appname/ in front of hostname in topic
 uint8_t prefixhost:1;	// MQTT use (appname/)hostname/topic instead of topic/(appname/)hostname
#ifdef	CONFIG_REVK_BLINK_DEF
#ifdef	CONFIG_REVK_BLINK_WS2812_DEF
#ifdef	CONFIG_REVK_LED_TEST
#endif
 uint8_t ws2812rgb:1;	// Reverse green and red on WS2812 LED
#else
#ifdef	CONFIG_REVK_LED_TEST
#else
#endif
#endif
#endif
#ifdef  CONFIG_REVK_APMODE
#ifdef	CONFIG_REVK_APCONFIG
#endif
#endif
#ifdef  CONFIG_REVK_MQTT
#endif
#if     defined(CONFIG_REVK_WIFI) || defined(CONFIG_REVK_MESH)
 uint8_t wifips:1;	// WiFi power save
 uint8_t wifimaxps:1;	// WiFi power save (max)
#endif
#ifndef	CONFIG_REVK_MESH
 uint8_t aplr:1;	// AP LR mode
 uint8_t aphide:1;	// AP hide SSID
#endif
#ifdef	CONFIG_REVK_MESH
 uint8_t meshlr:1;	// Mesh use LR mode
 uint8_t meshroot:1;	// This is preferred mesh root
#endif
};
#define	STRIPS	5
extern revk_gpio_t ledgpio[STRIPS];	// GPIO for LED string
extern uint16_t ledcount[STRIPS];	// How many LEDs in string
#ifdef	CONFIG_REVK_LED
#ifdef	CONFIG_REVK_LED_FULL
extern uint8_t ledtype[STRIPS];	// Type of LED string
#else
extern uint8_t ledtype[STRIPS];	// LED string colour coding
#endif
#else
extern uint8_t ledtype[STRIPS];	// Type of LED string
#endif
#ifdef  CONFIG_IDF_TARGET_ESP32S3
extern uint8_t cps;	// Change per second
#else
extern uint8_t cps;	// Change per second
#endif
extern revk_gpio_t relay;	// Relay for strip power
extern revk_gpio_t adc;	// ADC*13.4
extern revk_gpio_t button;	// Button
extern revk_gpio_t irgpio;	// IR receiver
#define	irlog	revk_settings_bits.irlog
#define	irdebug	revk_settings_bits.irdebug
#define	ir4x11	revk_settings_bits.ir4x11
#define	ir4x6	revk_settings_bits.ir4x6
#define	irha	revk_settings_bits.irha
#ifdef  CONFIG_REVK_LED_TEST
extern revk_gpio_t blink[3];	// R, G, B LED array (for WS2818, set first two the same, third can be loop test)
#else
extern revk_gpio_t blink[3];	// R, G, B LED array (for WS2812, set first two the same)
#endif
extern uint8_t maxr;	// Max RGB Red
extern uint8_t maxg;	// Max RGB Green
extern uint8_t maxb;	// Max RGB Blue
extern uint8_t maxw;	// Max RGBW White
#define	usegamma	revk_settings_bits.usegamma
extern uint8_t webcontrol;	// Web controls
extern revk_gpio_t lsscl;	// Colour sensor SCL
extern revk_gpio_t lssda;	// Colour sensor SDA
extern uint8_t lsals;	// Colour sensor ID
extern revk_gpio_t micdata;	// I2S Mic Data / SD / DATA
extern revk_gpio_t micclock;	// I2S Mic Clock / BCLK / SCK
extern revk_gpio_t micws;	// I2S Mic WS / LR (not set for PDM mode)
#define	micright	revk_settings_bits.micright
extern uint8_t micdamp;	// I2S Mic Damping from peak (higher is slower)
extern uint8_t micmaxgain;	// Max mic gain
extern uint8_t micrange;	// Range for reactive effects
#define	haenable	revk_settings_bits.haenable
extern uint8_t onpower;	// Activate specified preset on power up
extern uint8_t onclap;	// Activate specified preset on loud clap/tap
extern uint8_t onbutton;	// Activate specified preset on button press
extern char* name[CONFIG_REVK_WEB_EXTRA_PAGES];	// Name (must be set to appear in HA)
extern char* effect[CONFIG_REVK_WEB_EXTRA_PAGES];	// Default effect (leave blank for HA to pick)
extern char* colour[CONFIG_REVK_WEB_EXTRA_PAGES];	// Colour or palette name or #RGB style
extern uint16_t start[CONFIG_REVK_WEB_EXTRA_PAGES];	// First LED (default 1)
extern int16_t top[CONFIG_REVK_WEB_EXTRA_PAGES];	// Top LED (default to first)
extern uint16_t len[CONFIG_REVK_WEB_EXTRA_PAGES];	// Number of LEDs (default to end)
extern uint8_t bright[CONFIG_REVK_WEB_EXTRA_PAGES];	// Brightness
extern uint32_t delay[CONFIG_REVK_WEB_EXTRA_PAGES];	// Delay time, default 1s
extern uint16_t timed[CONFIG_REVK_WEB_EXTRA_PAGES];	// Timed start if not 0000 (use limit to stop)
extern uint32_t limit[CONFIG_REVK_WEB_EXTRA_PAGES];	// Time limit, default none
extern uint8_t speed[CONFIG_REVK_WEB_EXTRA_PAGES];	// Cycle time, default 1s
extern uint8_t fadein[CONFIG_REVK_WEB_EXTRA_PAGES];	// Fade in time, default 1s
extern uint8_t fadeout[CONFIG_REVK_WEB_EXTRA_PAGES];	// Fade out time, default 1s
extern char* config[CONFIG_REVK_WEB_EXTRA_PAGES];	// Settings as JSON and effect specific settings
#define	stack	revk_settings_bits.stack
extern uint8_t textheight;	// text height (default grid height)
extern uint8_t gridheight;	// grid height
extern uint8_t gridwidth;	// grid width before repeat grids
#define	gridflip	revk_settings_bits.gridflip
#define	gridsnake	revk_settings_bits.gridsnake
#ifdef	CONFIG_REVK_SETTINGS_PASSWORD
extern char* password;	// Settings password<br>(not sent securely so use with care)
#endif
#ifdef  CONFIG_MDNS_MAX_INTERFACES
extern char* hostname;	// Hostname[.local]<br>(used in DHCP and MQTT)
extern char* instance;	// Descriptive name of host, default is hostname
#else
extern char* hostname;	// Host name<br>(used in DHCP and MQTT)
#endif
extern char* otahost;	// OTA hostname
extern uint8_t otadays;	// OTA auto load (days)
extern uint16_t otastart;	// OTA check after startup (min seconds)
#define	otaauto	revk_settings_bits.otaauto
#ifdef	CONFIG_REVK_WEB_BETA
#define	otabeta	revk_settings_bits.otabeta
#endif
extern revk_settings_blob_t* otacert;	// OTA cert of otahost
#define	dark	revk_settings_bits.dark
extern char* ntphost;	// NTP host
extern char* tz;	// Timezone (<a href='https://gist.github.com/alwynallan/24d96091655391107939' target=_blank>info</a>)
extern uint32_t watchdogtime;	// Watchdog (seconds)
#ifdef  CONFIG_IDF_TARGET_ESP32S3
extern uint16_t usbuptime;	// USB  turns off after this many seconds
#endif
#ifdef  CONFIG_IDF_TARGET_ESP32S3
extern revk_gpio_t factorygpio;	// Factory reset GPIO (press 3 times)
#else
extern revk_gpio_t factorygpio;	// Factory reset GPIO (press 3 times)
#endif
extern char* topicgroup[2];	// MQTT Alternative hostname accepted for commands
extern char* topiccommand;	// MQTT Topic for commands
extern char* topicsetting;	// MQTT Topic for settings
extern char* topicstate;	// MQTT Topic for state
extern char* topicevent;	// MQTT Topic for event
extern char* topicinfo;	// MQTT Topic for info
extern char* topicerror;	// MQTT Topic for error
extern char* topicha;	// MQTT Topic for homeassistant
#define	prefixapp	revk_settings_bits.prefixapp
#define	prefixhost	revk_settings_bits.prefixhost
#ifdef	CONFIG_REVK_BLINK_DEF
#ifdef	CONFIG_REVK_BLINK_WS2812_DEF
extern revk_gpio_t blink;	// WS2812 LED
#ifdef	CONFIG_REVK_LED_TEST
extern revk_gpio_t blinktest;	// WS2812 LED loopback for testing LED strip
#endif
#define	ws2812rgb	revk_settings_bits.ws2812rgb
#else
#ifdef	CONFIG_REVK_LED_TEST
extern revk_gpio_t blink[3];	// R, G, B LED array (for WS2818, set first two the same, third can be loop test)
#else
extern revk_gpio_t blink[3];	// R, G, B LED array (for WS2812, set first two the same)
#endif
#endif
#endif
#ifdef  CONFIG_REVK_APMODE
#ifdef	CONFIG_REVK_APCONFIG
extern uint16_t apport;	// TCP port for config web pages on AP
#endif
extern uint32_t aptime;	// Limit AP to time (seconds)
extern uint32_t apwait;	// Wait off line before starting AP (seconds)
extern revk_gpio_t apgpio;	// Start AP on GPIO
#endif
#ifdef  CONFIG_REVK_MQTT
extern char* mqtthost[CONFIG_REVK_MQTT_CLIENTS];	// MQTT hostname
extern uint16_t mqttport[CONFIG_REVK_MQTT_CLIENTS];	// MQTT port
extern char* mqttuser[CONFIG_REVK_MQTT_CLIENTS];	// MQTT username
extern char* mqttpass[CONFIG_REVK_MQTT_CLIENTS];	// MQTT password
extern revk_settings_blob_t* mqttcert[CONFIG_REVK_MQTT_CLIENTS];	// MQTT CA certificate (for mqtts)
#endif
extern revk_settings_blob_t* clientkey;	// Client Key (OTA and MQTT TLS)
extern revk_settings_blob_t* clientcert;	// Client certificate (OTA and MQTT TLS)
#if     defined(CONFIG_REVK_WIFI) || defined(CONFIG_REVK_MESH)
extern uint16_t wifireset;	// Restart if WiFi off for this long (seconds)
extern char* wifissid;	// WiFI SSID (name)
extern char* wifipass;	// WiFi password
extern char* wifiip;	// WiFi Fixed IP
extern char* wifigw;	// WiFi Fixed gateway
extern char* wifidns[3];	// WiFi fixed DNS
extern uint8_t wifibssid[6];	// WiFI BSSID
extern uint8_t wifichan;	// WiFI channel
extern uint16_t wifiuptime;	// WiFI turns off after this many seconds
#define	wifips	revk_settings_bits.wifips
#define	wifimaxps	revk_settings_bits.wifimaxps
#endif
#ifndef	CONFIG_REVK_MESH
extern char* apssid;	// AP mode SSID (name)
extern char* appass;	// AP mode password
extern uint8_t apmax;	// AP max clients
extern char* apip;	// AP mode block
#define	aplr	revk_settings_bits.aplr
#define	aphide	revk_settings_bits.aphide
#endif
#ifdef	CONFIG_REVK_MESH
extern char* nodename;	// Mesh node name
extern uint16_t meshreset;	// Reset if mesh off for this long (seconds)
extern uint8_t meshid[6];	// Mesh ID (hex)
extern uint8_t meshkey[16];	// Mesh key
extern uint16_t meshwidth;	// Mesh width
extern uint16_t meshdepth;	// Mesh depth
extern uint16_t meshmax;	// Mesh max devices
extern char* meshpass;	// Mesh AP password
#define	meshlr	revk_settings_bits.meshlr
#define	meshroot	revk_settings_bits.meshroot
#endif
extern revk_settings_bits_t revk_settings_bits;
enum {
 REVK_SETTINGS_SIGNED,
 REVK_SETTINGS_UNSIGNED,
 REVK_SETTINGS_BIT,
 REVK_SETTINGS_BLOB,
 REVK_SETTINGS_STRING,
 REVK_SETTINGS_JSON,
 REVK_SETTINGS_OCTET,
};
#define	STRIPS	5
#define REVK_SETTINGS_LEDGPIO
#define REVK_SETTINGS_LEDCOUNT
#ifdef	CONFIG_REVK_LED
#ifdef	CONFIG_REVK_LED_FULL
#define REVK_SETTINGS_LEDTYPE
#else
#define REVK_SETTINGS_LEDTYPE
#endif
#else
#define REVK_SETTINGS_LEDTYPE
#endif
#ifdef  CONFIG_IDF_TARGET_ESP32S3
#define REVK_SETTINGS_CPS
#else
#define REVK_SETTINGS_CPS
#endif
#define REVK_SETTINGS_RELAY
#define REVK_SETTINGS_ADC
#define REVK_SETTINGS_BUTTON
#define REVK_SETTINGS_IRGPIO
#define REVK_SETTINGS_IRLOG
#define REVK_SETTINGS_IRDEBUG
#define REVK_SETTINGS_IR4X11
#define REVK_SETTINGS_IR4X6
#define REVK_SETTINGS_IRHA
#ifdef  CONFIG_REVK_LED_TEST
#define REVK_SETTINGS_BLINK
#else
#define REVK_SETTINGS_BLINK
#endif
#define REVK_SETTINGS_MAXR
#define REVK_SETTINGS_MAXG
#define REVK_SETTINGS_MAXB
#define REVK_SETTINGS_MAXW
#define REVK_SETTINGS_USEGAMMA
#define REVK_SETTINGS_WEBCONTROL
#define REVK_SETTINGS_LSSCL
#define REVK_SETTINGS_LSSDA
#define REVK_SETTINGS_LSALS
#define REVK_SETTINGS_MICDATA
#define REVK_SETTINGS_MICCLOCK
#define REVK_SETTINGS_MICWS
#define REVK_SETTINGS_MICRIGHT
#define REVK_SETTINGS_MICDAMP
#define REVK_SETTINGS_MICMAXGAIN
#define REVK_SETTINGS_MICRANGE
#define REVK_SETTINGS_HAENABLE
#define REVK_SETTINGS_ONPOWER
#define REVK_SETTINGS_ONCLAP
#define REVK_SETTINGS_ONBUTTON
#define REVK_SETTINGS_NAME
#define REVK_SETTINGS_EFFECT
#define REVK_SETTINGS_COLOUR
#define REVK_SETTINGS_START
#define REVK_SETTINGS_TOP
#define REVK_SETTINGS_LEN
#define REVK_SETTINGS_BRIGHT
#define REVK_SETTINGS_DELAY
#define REVK_SETTINGS_TIMED
#define REVK_SETTINGS_LIMIT
#define REVK_SETTINGS_SPEED
#define REVK_SETTINGS_FADEIN
#define REVK_SETTINGS_FADEOUT
#define REVK_SETTINGS_CONFIG
#define REVK_SETTINGS_STACK
#define REVK_SETTINGS_TEXTHEIGHT
#define REVK_SETTINGS_GRIDHEIGHT
#define REVK_SETTINGS_GRIDWIDTH
#define REVK_SETTINGS_GRIDFLIP
#define REVK_SETTINGS_GRIDSNAKE
#ifdef	CONFIG_REVK_SETTINGS_PASSWORD
#define REVK_SETTINGS_PASSWORD
#endif
#ifdef  CONFIG_MDNS_MAX_INTERFACES
#define REVK_SETTINGS_HOSTNAME
#define REVK_SETTINGS_INSTANCE
#else
#define REVK_SETTINGS_HOSTNAME
#endif
#define REVK_SETTINGS_OTAHOST
#define REVK_SETTINGS_OTADAYS
#define REVK_SETTINGS_OTASTART
#define REVK_SETTINGS_OTAAUTO
#ifdef	CONFIG_REVK_WEB_BETA
#define REVK_SETTINGS_OTABETA
#endif
#define REVK_SETTINGS_OTACERT
#define REVK_SETTINGS_DARK
#define REVK_SETTINGS_NTPHOST
#define REVK_SETTINGS_TZ
#define REVK_SETTINGS_WATCHDOGTIME
#ifdef  CONFIG_IDF_TARGET_ESP32S3
#define REVK_SETTINGS_USBUPTIME
#endif
#ifdef  CONFIG_IDF_TARGET_ESP32S3
#define REVK_SETTINGS_FACTORYGPIO
#else
#define REVK_SETTINGS_FACTORYGPIO
#endif
#define REVK_SETTINGS_TOPICGROUP
#define REVK_SETTINGS_TOPICCOMMAND
#define REVK_SETTINGS_TOPICSETTING
#define REVK_SETTINGS_TOPICSTATE
#define REVK_SETTINGS_TOPICEVENT
#define REVK_SETTINGS_TOPICINFO
#define REVK_SETTINGS_TOPICERROR
#define REVK_SETTINGS_TOPICHA
#define REVK_SETTINGS_PREFIXAPP
#define REVK_SETTINGS_PREFIXHOST
#ifdef	CONFIG_REVK_BLINK_DEF
#ifdef	CONFIG_REVK_BLINK_WS2812_DEF
#define REVK_SETTINGS_BLINK
#ifdef	CONFIG_REVK_LED_TEST
#define REVK_SETTINGS_BLINKTEST
#endif
#define REVK_SETTINGS_WS2812RGB
#else
#ifdef	CONFIG_REVK_LED_TEST
#define REVK_SETTINGS_BLINK
#else
#define REVK_SETTINGS_BLINK
#endif
#endif
#endif
#ifdef  CONFIG_REVK_APMODE
#ifdef	CONFIG_REVK_APCONFIG
#define REVK_SETTINGS_APPORT
#endif
#define REVK_SETTINGS_APTIME
#define REVK_SETTINGS_APWAIT
#define REVK_SETTINGS_APGPIO
#endif
#ifdef  CONFIG_REVK_MQTT
#define REVK_SETTINGS_MQTTHOST
#define REVK_SETTINGS_MQTTPORT
#define REVK_SETTINGS_MQTTUSER
#define REVK_SETTINGS_MQTTPASS
#define REVK_SETTINGS_MQTTCERT
#endif
#define REVK_SETTINGS_CLIENTKEY
#define REVK_SETTINGS_CLIENTCERT
#if     defined(CONFIG_REVK_WIFI) || defined(CONFIG_REVK_MESH)
#define REVK_SETTINGS_WIFIRESET
#define REVK_SETTINGS_WIFISSID
#define REVK_SETTINGS_WIFIPASS
#define REVK_SETTINGS_WIFIIP
#define REVK_SETTINGS_WIFIGW
#define REVK_SETTINGS_WIFIDNS
#define REVK_SETTINGS_WIFIBSSID
#define REVK_SETTINGS_WIFICHAN
#define REVK_SETTINGS_WIFIUPTIME
#define REVK_SETTINGS_WIFIPS
#define REVK_SETTINGS_WIFIMAXPS
#endif
#ifndef	CONFIG_REVK_MESH
#define REVK_SETTINGS_APSSID
#define REVK_SETTINGS_APPASS
#define REVK_SETTINGS_APMAX
#define REVK_SETTINGS_APIP
#define REVK_SETTINGS_APLR
#define REVK_SETTINGS_APHIDE
#endif
#ifdef	CONFIG_REVK_MESH
#define REVK_SETTINGS_NODENAME
#define REVK_SETTINGS_MESHRESET
#define REVK_SETTINGS_MESHID
#define REVK_SETTINGS_MESHKEY
#define REVK_SETTINGS_MESHWIDTH
#define REVK_SETTINGS_MESHDEPTH
#define REVK_SETTINGS_MESHMAX
#define REVK_SETTINGS_MESHPASS
#define REVK_SETTINGS_MESHLR
#define REVK_SETTINGS_MESHROOT
#endif
#define	REVK_SETTINGS_HAS_ENUM
#define	REVK_SETTINGS_HAS_OLD
#define	REVK_SETTINGS_HAS_UNIT
#define	REVK_SETTINGS_HAS_COMMENT
#define	REVK_SETTINGS_HAS_GPIO
#define	REVK_SETTINGS_HAS_NUMERIC
#define	REVK_SETTINGS_HAS_SIGNED
#define	REVK_SETTINGS_HAS_UNSIGNED
#define	REVK_SETTINGS_HAS_BIT
#define	REVK_SETTINGS_HAS_BLOB
#define	REVK_SETTINGS_HAS_STRING
#define	REVK_SETTINGS_HAS_JSON
#define	REVK_SETTINGS_HAS_OCTET
#define	delay_scale	10
#define	limit_scale	10
#define	speed_scale	10
#define	fadein_scale	10
#define	fadeout_scale	10
typedef uint8_t revk_setting_bits_t[16];
typedef uint8_t revk_setting_group_t[3];
extern const char revk_settings_secret[];
