revk/ESP32-LED/main/chars.h

#define	CHARH	9
typedef struct c_s c_t;
struct c_s
{
   char *c;
   unsigned char b[CHARH];
};

c_t chars[] = {
   {" ", {}},
   {"!", {0x20, 0x20, 0x20, 0x20, 0x20, 0x00, 0x20}},
   {"¡", {0x20, 0x00, 0x20, 0x20, 0x20, 0x20, 0x20}},
   {"\"", {0x50, 0x50, 0x50}},
   {"#", {0x50, 0x50, 0xF8, 0x50, 0xF8, 0x50, 0x50}},
   {"$", {0x70, 0xA8, 0xA0, 0x70, 0x28, 0xA8, 0x70}},
   {"%", {0xC0, 0xC8, 0x10, 0x20, 0x40, 0x98, 0x18}},
   {"&", {0x40, 0xA0, 0xA0, 0x40, 0xA8, 0x90, 0x68}},
   {"'", {0x20, 0x20, 0x20}},
   {"(", {0x10, 0x20, 0x40, 0x40, 0x40, 0x20, 0x10}},
   {")", {0x40, 0x20, 0x10, 0x10, 0x10, 0x20, 0x40}},
   {"*", {0x20, 0xA8, 0x70, 0x20, 0x70, 0xA8, 0x20}},
   {"∗", {0x20, 0xA8, 0x70, 0x20, 0x70, 0xA8, 0x20}},
   {"+", {0x00, 0x20, 0x20, 0xF8, 0x20, 0x20}},
   {"±", {0x20, 0x20, 0xF8, 0x20, 0x20, 0x00, 0xF8}},
   {"∓", {0xF8, 0x00, 0x20, 0x20, 0xF8, 0x20, 0x20}},
   {"∔", {0x20, 0x00, 0x20, 0x20, 0xF8, 0x20, 0x20}},
   {"−", {0x00, 0x00, 0x00, 0xF8}},
   {",", {0x00, 0x00, 0x00, 0x00, 0x00, 0x20, 0x20, 0x40}},
   {"-", {0x00, 0x00, 0x00, 0x70}},
   {"¬", {0x00, 0x00, 0x00, 0x70, 0x10}},
   {".", {0x00, 0x00, 0x00, 0x00, 0x00, 0x00, 0x20}},
   {"·", {0x00, 0x00, 0x00, 0x20}},
   {"/", {0x00, 0x08, 0x10, 0x20, 0x40, 0x80}},
   {"÷", {0x00, 0x20, 0x00, 0xF8, 0x00, 0x20}},
   {"0", {0x20, 0x50, 0x88, 0x88, 0x88, 0x50, 0x20}},
   {"1", {0x20, 0x60, 0x20, 0x20, 0x20, 0x20, 0x70}},
   {"2", {0x70, 0x88, 0x08, 0x30, 0x40, 0x80, 0xF8}},
   {"3", {0xF8, 0x08, 0x10, 0x30, 0x08, 0x88, 0x70}},
   {"4", {0x10, 0x30, 0x50, 0x90, 0xF8, 0x10, 0x10}},
   {"5", {0xF8, 0x80, 0xF0, 0x08, 0x08, 0x88, 0x70}},
   {"6", {0x30, 0x40, 0x80, 0xF0, 0x88, 0x88, 0x70}},
   {"7", {0xF8, 0x08, 0x10, 0x20, 0x40, 0x40, 0x40}},
   {"8", {0x70, 0x88, 0x88, 0x70, 0x88, 0x88, 0x70}},
   {"9", {0x70, 0x88, 0x88, 0x78, 0x08, 0x10, 0x60}},
   {":", {0x00, 0x00, 0x20, 0x00, 0x20}},
   {";", {0x00, 0x00, 0x20, 0x00, 0x20, 0x20, 0x40}},
   {"<", {0x10, 0x20, 0x40, 0x80, 0x40, 0x20, 0x10}},
   {"«", {0x00, 0x00, 0x48, 0x90, 0x48}},
   {"=", {0x00, 0x00, 0xF8, 0x00, 0xF8}},
   {">", {0x40, 0x20, 0x10, 0x08, 0x10, 0x20, 0x40}},
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
};
