revk/ESP32-LED/main/drop.c

// Simple drop color

#include "app.h"
#include <math.h>

typedef struct
{
   float position;              // m
   float speed;                 // m/s
   uint8_t pos;                 // used for colour pick, random
   uint8_t running:1;           // Ball running
   uint8_t burried:1;           // Ball stopped bouncing
} ball_t;

typedef struct
{
   float height;                // m, can be negative for other way
   float gravity;               // m/s/s
   float drag;                  // 0-1
   float bounce;                // 0-1
   float size;                  // m
   uint8_t balls;
   uint8_t up:1;
   uint8_t random:1;
   ball_t ball[0];
} config_t;

const char *
appdrop (app_t * a)
{
   if (!a->cycle)
   {
      if (!a->colourset)
         setcolour (a, "rainbow");
      free (a->data);
      memset (a->data = mallocspi (sizeof (config_t)), 0, sizeof (config_t));
   }
   config_t *c = a->data;
   if (!a->cycle)
   {
      // Defaults
      c->height = 1;
      c->drag = 0.01;
      c->gravity = 1;           // 9.8 is way too fast even if realistic
      c->bounce = 0.3;
      c->balls = 3;
      if (a->config)
      {
         jo_t j = jo_parse_str (a->config);
         if (jo_here (j) == JO_OBJECT)
         {
            void setf (const char *tag, float *fp)
            {
               if (jo_find (j, tag) == JO_NUMBER)
                  *fp = jo_read_float (j);
            }
            setf ("height", &c->height);
            setf ("gravity", &c->gravity);
            setf ("drag", &c->drag);
            setf ("bounce", &c->bounce);
            setf ("size", &c->size);
            if (jo_find (j, "balls") == JO_NUMBER)
               c->balls = jo_read_int (j);
         }
         if (jo_find (j, "up") == JO_TRUE)
            c->up = 1;
         if (jo_find (j, "random") == JO_TRUE)
            c->random = 1;
         jo_free (&j);
      }
      if (c->bounce < 0)
         c->bounce = 0;
      if (c->drag < 0)
         c->drag = 0;
      if (c->drag > 1)
         c->drag = 1;
      if (c->balls < 1)
         c->balls = 1;
      if (c->balls > 10)
         c->balls = 10;
      if (c->height == 0)
         c->height = 1;
      if (c->height < 0)
      {                         // bodgy way to set up
         c->height = 0 - c->height;
         c->up = 1;
      }
      if (c->size <= 0)
         c->size = c->height * 9 / a->len;
      // Report config
      jo_t n = jo_object_alloc ();
      jo_litf (n, "height", "%.2f", c->height);
      jo_litf (n, "gravity", "%.2f", c->gravity);
      jo_litf (n, "bounce", "%.2f", c->bounce);
      jo_litf (n, "drag", "%.2f", c->drag);
      jo_litf (n, "size", "%.2f", c->size);
      jo_int (n, "balls", c->balls);
      if (c->up)
         jo_bool (n, "up", 1);
      if (c->random)
         jo_bool (n, "random", 1);
      char *was = a->config;
      a->config = jo_finisha (&n);
      free (was);
      // Adjust for use
      c->drag = pow (1.0 - c->drag, 1.0 / cps);
      c = a->data = realloc (c, sizeof (config_t) + c->balls * sizeof (ball_t));
      memset (c->ball, 0, c->balls * sizeof (ball_t));
   }
   // Start a new ball?
   for (int i = 0; i < c->balls; i++)
   {
      ball_t *b = &c->ball[i];
      if (b->running)
         continue;
      if (esp_random () % cps)
         continue;
      b->pos = (c->random ? esp_random () : a->cycle);
      b->position = c->height + c->size / 2;
      b->speed = -c->gravity * (esp_random () & 255) / 256 / cps;
      b->burried = 0;
      b->running = 1;
      break;
   }
   // Draw and move balls
   for (int i = 0; i < c->balls; i++)
   {
      ball_t *b = &c->ball[i];
      if (!b->running)
         continue;
      int p = a->len * b->position / c->height;
      int n = a->len * c->size / c->height / 2;
      if (c->up)
         p = a->len - 1 - p;
      if (!n)
         n = 1;
      for (int i = 0; i < n; i++)
      {
         uint8_t l = (int) a->fader * cos8[128 * i / n] / 255;
         if (p - i >= 0 && p - i < a->len)
            setl (a->start + p - i, a, b->pos, 255, l);
         if (p + i >= 0 && p + i < a->len && i)
            setl (a->start + p + i, a, b->pos, 255, l);
      }
      // Move
      b->position += b->speed / cps;
      b->speed -= c->gravity / cps;
      b->speed *= c->drag;
      if (b->position <= 0 && !b->burried && c->bounce > 0)
      {                         // Bounce
         b->position = (-b->position * c->bounce);
         b->speed = (-b->speed * c->bounce);
      }
      if ((b->burried && b->position < -c->size / 2) || (b->position > c->height + c->size / 2))
         b->running = 0;        // Fallen off the ends
      else if ((b->speed >= 0 && b->speed <= c->gravity / cps && b->position < c->size / 2))
         b->burried = 1;        // peak of bounce, and it is low, so stop bouncing and let fall off end
   }
   return NULL;
}
