revk/ESP32-LED/main/apps.h

// The list of apps

#ifndef	a
#define	a(n,d)                  // App
#endif
#ifndef	r
#define	r(n,d) a(n,d)           // Ring
#endif
#ifndef	t
#define	t(n,d) a(n,d)           // Text
#endif
#ifndef	s
#define	s(n,d) a(n,d)           // Sound
#endif

//
a (idle, Fixed colour)          //
   a (pulse, Pulse)             //
   a (bargraph, Bargraph)       //
   a (cylon, Cylon)             //
   a (countdown, Countdown)     //
   a (random, Random)           //
   a (twinkle, Twinkle)         //
   a (drop, Drop / drip)        //
   // Sound
   s (audio, Audio)             //
   s (volume, Volume)           //
   s (volumergb, Volume RGB)    //
   // Ring/loop
   r (clock, Clock face)        //
   r (stargate, Stargate)       //
   //
   r (test, Test)        //
   r (spin, Spin)               //
   r (lava, Lava Lamp)          //
   // Text
   t (text, Text)               //
   t (kern, Text kerned)        //
   t (time, Text time)          //
#undef a
#undef r
#undef t
#undef s
