revk/ESP32-LED/main/clock.c

// Simple clock

#include "app.h"

struct clock_s
{
   uint8_t h0,
     m0,
     s0;
   uint8_t h1,
     m1,
     s1;
};

const char *
appclock (app_t * a)
{
   if (!a->cycle)
   {
      free (a->data);           // Not used supplied
      a->data = mallocspi (sizeof (struct clock_s));
   }
   struct clock_s *c = a->data;
   uint8_t top;
   int8_t dir = 1;
   if (a->top < 0)
   {
      top = -a->top - a->start;
      dir = -1;
   } else
      top = a->top - a->start;

   if (!a->cycle)
   {                            // Sanity checks, etc
      c->h0 = a->start + top;
      c->m0 = a->start + top;
      c->s0 = a->start + top;
      c->h1 = a->start + top;
      c->m1 = a->start + top;
      c->s1 = a->start + top;
      a->step = cps * 3;        // Start at 12:00
   }

   clear (a->start, a->len);

   if (a->stop)
   {
      setR (c->h1, a->fader);
      setG (c->m1, a->fader);
      setB (c->s1, a->fader);
      return NULL;
   }
   if (a->step)
   {                            // Second fade from one to another
      uint8_t l = a->bright * a->step / a->speed;

      if (c->h0 == c->h1)
         setR (c->h0, 255);
      else
      {
         setR (c->h0, 255 - l);
         setR (c->h1, l);
      }
      if (c->m0 == c->m1)
         setG (c->m0, 255);
      else
      {
         setG (c->m0, 255 - l);
         setG (c->m1, l);
      }
      if (c->s0 == c->s1)
         setB (c->s0, 255);
      else
      {
         setB (c->s0, 255 - l);
         setB (c->s1, l);
      }

      if (!--a->step)
      {
         c->h1 = c->h0;
         c->m1 = c->m0;
         c->s1 = c->s0;
         a->step = 0;
      }
      return NULL;
   }

   struct timeval tv;
   gettimeofday (&tv, NULL);
   struct tm t;
   localtime_r (&tv.tv_sec, &t);
   uint32_t s = t.tm_hour * 3600000 + t.tm_min * 60000 + t.tm_sec * 1000 + tv.tv_usec / 1000;;

   c->h0 = a->start + (a->len + top + dir * (a->len * (s % 43200000) / 43200000)) % a->len;
   c->m0 = a->start + (a->len + top + dir * (a->len * (s % 3600000) / 3600000)) % a->len;
   c->s0 = a->start + (a->len + top + dir * (a->len * (s % 60000) / 60000)) % a->len;

   setR (c->h1, 255);
   setG (c->m1, 255);
   setB (c->s1, 255);

   if (c->h0 != c->h1 || c->m0 != c->m1 || c->s0 != c->s1)
      a->step = (a->speed - 1) ? : 1;   // -1 because a speed default of cps means we can be out of step
   return NULL;
}
