revk/ESP32-LED/main/twinkle.c

// Stargate

#include "app.h"
#define SPEED 2                 // Seconds per spin?

const char *
apptwinkle (app_t * a)
{
   if (!a->cycle)
   {
      free (a->data);           // Not used supplied
      a->data = mallocspi (a->len * 2);
      memset (a->data, 0, a->len * 2);
      if (!a->colourset)
         setcolour (a, "white");
      a->step = a->speed;
   }
   uint8_t *old = a->data,
      *new = old + a->len;
   uint8_t q = a->fader;

   if (!--a->step)
   {                            // Next
      a->step = a->speed;
      memcpy (old, new, a->len);
      esp_fill_random (new, a->len);
      for (int i = 0; i < a->len; i++)
         new[i] = (int) 2 *new[i] / 3 + 85;
   }

   for (int i = 0; i < a->len; i++)
   {
      uint8_t l = (int) (a->speed - a->step) * new[i] / a->speed + (int) a->step * old[i] / a->speed;
      setl (a->start + i, a, i, a->len, (int) l * q / 255);
   }

   return NULL;
}
