revk/ESP32-LED/main/palette.h

// Palette logic

// Takes time/position/value and sets R/G/B/W, time and value are 0-255, position is p/n
// Returns mix level to apply (usually v for non value based palettes)
typedef uint8_t palette_t (uint8_t t, int p, int n, uint8_t v, uint8_t * r, uint8_t * g, uint8_t * b, uint8_t * w);

typedef struct
{
   const char *name;
   const char *description;
   palette_t *run;
} palettes_t;
extern palettes_t palettes[];

#define p(x,d) extern palette_t palette_##x;
#include "palette.m"
