revk/ESP32-LED/main/spin.c

// Simple spin color

#include "app.h"

const char *
appspin (app_t * a)
{
   if (!a->cycle)
   {                            // Sanity check / defaults
      if (!a->colourset)
         setcolour (a, "cycling");
   }
   if (a->top > 0)
      a->step -= 256 / a->speed;
   else
      a->step += 256 / a->speed;
   uint8_t l = a->fader;
   for (unsigned int i = 0; i < a->len; i++)
      setl (a->start + i, a, i, a->len, l * cos8[(256 * i / a->len + a->step) & 255] / 255);
   return NULL;
}
