revk/ESP32-LED/(commit log)

2021-12-13 Silly bug in mqtt
    [Gate.c]
2021-12-15 Changed name to LED, and will include various LED strip things in one app based on settings.
2021-12-16 Correct clock fade other than 1 second
    [LED.c]
2023-04-08 Moved PCB here
    [LED.kicad_pcb, LED.kicad_sch, LED.scad, LED.stl, bom.csv, designators.csv, positions.csv]
2023-04-08 Revised for production
    [LED.kicad_pcb, positions.csv]
2023-04-08 Case adjust
    [LED.scad, LED.stl]
2023-04-08 Fine tuning
    [LED.scad, LED.stl]
2023-04-20 Corrected PCB, stupid error
    [LED.kicad_pcb, LED.kicad_sch, bom.csv, designators.csv, positions.csv]
2023-04-22 Handle more LEDs
2023-04-30 Started on Coaster
    [Coaster.kicad_pcb, Coaster.kicad_sch, bom.csv, designators.csv, positions.csv]
2023-04-30 More tidy
    [Coaster.kicad_pcb, Coaster.kicad_sch, designators.csv, positions.csv]
2023-04-30 Reworked for rubber feet
    [Coaster.kicad_pcb, Coaster.kicad_sch, bom.csv, designators.csv, positions.csv]
2023-04-30 12 sided
    [Coaster.kicad_pcb]
2023-05-01 Much tidying
    [Coaster.kicad_pcb, Coaster.kicad_sch, bom.csv, designators.csv, positions.csv]
2023-05-01 Fix stupid position error
    [Coaster.kicad_pcb, positions.csv]
2023-05-01 Better curvey tracks for this
    [Coaster.kicad_pcb]
2023-05-01 Further tidy
    [Coaster.kicad_pcb, Coaster.kicad_sch]
2023-05-11 Changed pads for easier soldering next time
    [Coaster.kicad_pcb, Gate.kicad_pcb, Gate.kicad_sch, bom.csv, designators.csv, positions.csv]
2023-05-12 Library update
    [Coaster.kicad_pcb, Coaster.kicad_sch, bom.csv, designators.csv, positions.csv]
2023-05-14 Cleaner DRC
    [Coaster.kicad_pcb, Coaster.kicad_sch]
2023-06-15 Prog header
    [Coaster.kicad_pcb]
2023-06-21 Rotation fix
    [LED.kicad_pcb, LED.kicad_sch, positions.csv]
2023-06-23 New shelly pads
    [Coaster.kicad_pcb, positions.csv]
2023-06-24 Started on it
    [LED.kicad_pcb, LED.kicad_sch, LED.scad, LED.stl, bom.csv, designators.csv, positions.csv]
2023-06-25 As ordered
    [LED.kicad_pcb, LED.kicad_sch, bom.csv, designators.csv, positions.csv]
2023-06-25 Tear drops
    [LED.kicad_pcb]
2023-06-26 Re panel
    [LED.kicad_pcb, LED.kicad_sch, bom.csv, designators.csv, positions.csv]
2023-06-26 4k7 missing
    [LED.kicad_pcb, bom.csv, designators.csv, positions.csv]
2023-06-26 Another cap
    [LED.kicad_pcb, LED.kicad_sch, bom.csv, designators.csv, positions.csv]
2023-06-26 V Cuts
    [LED.kicad_pcb]
2023-06-27 Better Rails
    [LED.kicad_pcb, LED.kicad_sch, designators.csv, positions.csv]
2023-06-28 CH340X DTR
    [LED.kicad_pcb, LED.kicad_sch, bom.csv, designators.csv, positions.csv]
2023-06-29 Fix RGB
    [LED.kicad_pcb, LED.kicad_sch, positions.csv]
2023-08-07 Deprecate old LED design
    [LED.kicad_pcb, LED.kicad_sch, LED.scad, LED.stl, bom.csv, designators.csv, positions.csv]
2023-08-08 Started new layout for S3
    [LED.kicad_pcb, LED.kicad_sch, LED.scad, LED.stl, bom.csv, designators.csv, positions.csv]
2023-08-08 Started tracking
    [LED.kicad_pcb, LED.kicad_sch, bom.csv, designators.csv, positions.csv]
2023-08-09 New S3
    [LED.kicad_pcb, LED.kicad_sch, designators.csv, positions.csv]
2023-08-14 LED for S3
2023-08-14 LED config
2023-08-14 LED input
    [LED.kicad_pcb, LED.kicad_sch, designators.csv, positions.csv]
2023-08-14 Clean up, allow in panel USB prog.
    [LED.kicad_pcb, LED.kicad_sch, bom.csv, designators.csv, positions.csv]
2023-08-15 3D cases
    [LED.kicad_pcb, LED.scad, LED.stl, positions.csv]
2023-08-16 Not working for Matter yet
    [lava.c, matter_main.cpp]
2023-08-19 New Reg
    [LED.kicad_pcb, LED.kicad_sch, positions.csv]
2023-08-19 New LED driver (S3)
    [LED.kicad_pcb, LED.kicad_sch, LED.scad, LED.stl, bom.csv, designators.csv, positions.csv]
2023-09-03 More marking for JLC
    [5x7.kicad_pcb, 5x7.kicad_sch, Coaster.kicad_pcb, Coaster.kicad_sch, bom.csv, designators.csv, positions.csv]
2023-09-23 Reworked for orientation, and ordered
    [5x7.kicad_pcb, 5x7.kicad_sch, bom.csv, designators.csv, positions.csv]
2023-09-23 Not started
    [150x7.kicad_pcb, 150x7.kicad_sch, bom.csv, designators.csv, positions.csv]
2023-09-24 grid code started
    [LED.scad]
2023-09-24 Started grid
    [150x7.kicad_pcb, 5x7.kicad_pcb, LED.scad, LED.stl]
2023-09-24 Try again
    [150x7.kicad_pcb, 5x7.kicad_pcb]
2023-09-24 Some tracks
    [150x7.kicad_pcb, 5x7.kicad_pcb, LED.scad]
2023-09-24 Works - would be nice to have a way to delete the created old entries...
    [150x7.kicad_pcb, 5x7.kicad_pcb]
2023-09-24 New layout
    [150x7.kicad_pcb, 5x7.kicad_pcb, 5x7.kicad_sch, bom.csv, designators.csv, positions.csv]
2023-09-24 Work on otehr sizes later
    [150x7.kicad_pcb, 150x7.kicad_sch, bom.csv, designators.csv, positions.csv]
2023-09-24 Matching old tracks
    [5x7.kicad_pcb]
2023-09-25 Working on ring logic
    [5x7.kicad_pcb, LED.scad]
2023-09-25 Start on ring
    [Gate.kicad_pcb, Gate.kicad_sch]
2023-09-26 Zone fill
    [5x7.kicad_pcb, Gate.kicad_pcb, LED.scad]
2023-09-26 Gate done
    [5x7.kicad_pcb, Gate.kicad_pcb, Gate.kicad_sch, LED.scad, bom.csv, designators.csv, positions.csv]
2023-09-26 Needs more work
    [Gate.kicad_pcb, positions.csv]
2023-09-26 Better logic for clashes
    [5x7.kicad_pcb, Gate.kicad_pcb, LED.scad, positions.csv]
2023-09-26 Cleaner avoiding clashes on vias
    [5x7.kicad_pcb, positions.csv]
2023-09-27 New options
    [5x7.kicad_pcb, Gate.kicad_sch, Gate1.kicad_pcb, Gate1.kicad_sch, Gate2.kicad_pcb, Gate2.kicad_sch, LED.scad, bom.csv]
2023-09-27 Cap value
    [5x7.kicad_pcb, Gate.kicad_sch, bom.csv]
2023-09-28 Updated fills
    [positions.csv]
2023-09-29 Clean up a lot
    [positions.csv]
2023-10-05 5x9 grid
    [5x9.kicad_pcb, 5x9.kicad_sch, LED.stl, bom.csv, designators.csv, positions.csv]
2023-10-08 Change pads
    [5x7.kicad_pcb, 5x9.kicad_pcb, positions.csv]
2023-10-08 New footprint on LEDs
    [5x7.kicad_pcb, 5x9.kicad_pcb, LED.scad, positions.csv]
2023-10-08 Smaller, and evenly spaced rings
    [positions.csv]
2023-10-10 SCAD model to house PCB
    [Glyphs.dxf, Stargate.scad]
2023-10-11 Tidy and avoid lower ghlyphs in random dial
    [stargate.c]
2023-10-11 Tooling holes
    [designators.csv, positions.csv]
2023-10-11 pos file fix
    [positions.csv]
2023-10-11 Cleaner chevrons
    [Stargate.scad, positions.csv]
2023-10-11 Tweak LED placement on chevrons
    [Stargate.scad, positions.csv]
2023-10-12 498 ring
    [Gate.kicad_sch, Stargate.scad, bom.csv, designators.csv, positions.csv]
2023-10-12 New board
    [positions.csv]
2023-10-12 Revised PCb clearance
    [Stargate.scad]
2023-10-13 3D models
    [Stargate.scad, Stargate.stl, StargateBottom.stl, StargateTop.stl, StargateWithRamp.stl, positions.csv]
2023-10-14 Can no order JLC
    [Gate.kicad_sch, bom.csv, positions.csv]
2023-10-14 507 LEDs now
    [Gate.kicad_sch, bom.csv, designators.csv, positions.csv]
2023-10-14 Updated 3D model for latest (507 LED) PCB design.
    [Stargate.scad, StargateBottom.stl, StargateTop.stl]
2023-10-15 Fix mounting holes
    [Gate.kicad_sch, designators.csv, positions.csv]
2023-10-15 Two holes
    [Gate.kicad_sch, positions.csv]
2023-10-16 Tweek tooling holes
    [Gate.kicad_sch, LED.kicad_sch, positions.csv]
2023-10-16 Made status LED the 1st LED
    [LED.kicad_pcb, LED.kicad_sch, bom.csv, designators.csv, positions.csv]
2023-10-16 Fix pos file
    [LED.kicad_pcb, positions.csv]
2023-10-17 Even more silk screen
    [LED.kicad_pcb, positions.csv]
2023-10-20 Parts - needs text and artwork
    [Roulette.kicad_pcb, Roulette.kicad_sch, bom.csv, positions.csv]
2023-10-21 First attempt
    [Roulette.kicad_sch, bom.csv, designators.csv, positions.csv]
2023-10-23 Handle extra LED for status
2023-10-23 Reworked slightly
    [Stargate.scad, Stargate.stl, StargateBottom.stl, StargateTop.stl, StargateWithRamp.stl]
2023-10-24 Reworked - no mirror
    [Stargate.scad, Stargate.stl, StargateBottom.stl, StargateTop.stl, StargateWithRamp.stl]
2023-10-24 Tighter around PCB
    [Stargate.scad, Stargate.stl, StargateBottom.stl, StargateRamp.stl, StargateRampBottom.stl, StargateRampTop.stl, StargateTop.stl]
2023-10-25 Tweaked slightly
    [Stargate.scad, Stargate.stl, StargateBottom.stl, StargateRamp.stl, StargateRampBottom.stl, StargateRampTop.stl, StargateTop.stl]
2024-05-14 Added bigger cap
    [LED.kicad_pcb, LED.kicad_sch, bom.csv, designators.csv, positions.csv]
2024-06-01 Handle power blink
2024-06-04 Update silkscreen
    [LED.kicad_pcb]
2024-06-04 Solder tabs
    [LED.kicad_pcb]
2024-06-04 Revised for new placement of the USB-C FFS
    [LED.kicad_pcb]
2024-06-06 Allow screw terminal
    [LED.kicad_pcb, LED.kicad_sch, bom.csv, designators.csv, positions.csv]
2024-06-06 Lots of buggering about to get aligned
    [LED.kicad_pcb, LED.kicad_sch, bom.csv, positions.csv]
2024-06-06 Round corners
    [LED.kicad_pcb]
2024-06-08 Change USB connector on back of processor
    [LED.kicad_pcb, LED.kicad_sch, bom.csv, designators.csv, positions.csv]
2024-06-08 Remove USB on back of CPU
    [LED.kicad_pcb, LED.kicad_sch, bom.csv, designators.csv, positions.csv]
2024-06-08 Started on HA (non crashy this time)
    [LED.c]
2024-06-14 USB pads for in panel flashing
    [LED.kicad_pcb, LED.kicad_sch, designators.csv, positions.csv]
2024-06-23 New pin out
    [LED.kicad_pcb, LED.kicad_sch, bom.csv, designators.csv, positions.csv]
2024-06-23 New PCB design
    [LED.kicad_pcb, LED.kicad_sch, bom.csv, designators.csv, positions.csv]
2024-06-23 More vias
    [LED.kicad_pcb]
2024-06-24 Tidy PCB
    [LED.kicad_pcb, LED.kicad_sch]
2024-06-25 Coment on baking
    [LED.kicad_pcb]
2024-06-25 More silk screen
    [LED.kicad_pcb]
2024-06-27 Not working right yet - new virtual strip stuff
    [LED.c]
2024-06-30 Reset pads
    [LED.kicad_pcb, LED.kicad_sch, bom.csv, designators.csv, positions.csv]
2024-07-01 Changed default Blink LED
2024-07-06 Fix more complex json in preset
    [LED.c]
2024-07-06 Tweak for GPIO45
    [LED.kicad_pcb, LED.kicad_sch, positions.csv]
2024-07-15 Safer snapout
    [LED.kicad_pcb]
2024-07-19 Latest boards
2024-07-28 Extra clearance
    [LED.stl]
2024-07-28 Adjusted case
    [LED.scad, LED.stl]
2024-07-28 Better fit
    [LED.scad, LED.stl]
2024-07-31 Fix 3D, and add cap
    [LED.kicad_pcb, LED.kicad_sch, bom.csv, designators.csv, positions.csv]
2024-08-10 New WAGO connector
    [LED.kicad_pcb, LED.kicad_sch, bom.csv, positions.csv]
2024-08-10 Order change, pin 1 GND as normal
    [LED-Screw.stl, LED.kicad_pcb, LED.scad, LED.stl, positions.csv]
2024-08-10 3d placement
    [LED.kicad_pcb, LED.kicad_sch, positions.csv]
2024-08-11 new case design
    [LED.scad, LED.stl]
2024-08-11 0.5mm taken off, bet cap marking
    [LED.kicad_pcb, LED.kicad_sch]
2024-08-14 New dual LED board
    [LED.kicad_pcb, LED.kicad_sch, bom.csv, designators.csv, positions.csv]
2024-08-14 Tidy silkscreen
    [LED.kicad_pcb, positions.csv]
2024-08-18 SS change
    [LED.kicad_pcb]
2024-08-21 HA colour reporting error (G was R)
    [LED.c]
2024-08-25 Position fix
    [LED.kicad_pcb, positions.csv]
2024-08-25 Clean up GND GPIOs
    [LED.kicad_pcb, LED.kicad_sch, positions.csv]
2024-08-25 Tidy mic
    [LED.kicad_pcb]
2024-08-26 BOM fix
    [LED.kicad_pcb, LED.kicad_sch, bom.csv]
2024-08-26 Adjusted to 45mm and more caps
    [LED.kicad_pcb, LED.kicad_sch, bom.csv, designators.csv, positions.csv]
2024-08-26 Tweak caps
    [LED.kicad_pcb, LED.kicad_sch, bom.csv]
2024-08-27 Fix LED count (was 1 too high, which really only mattered for stargate)
    [LED.c]
2024-08-27 J1 fix
    [LED.kicad_pcb, LED.kicad_sch, bom.csv, positions.csv]
2024-08-29 Fix LED status
2024-09-03 Now an LED project
    [USBA.kicad_pcb, USBA.kicad_sch, USBA.scad, USBA.stl, bom.csv, designators.csv, positions.csv]
2024-09-06 Retracked for EMC/USB
    [LED.kicad_pcb, positions.csv]
2024-09-06 GPIO tweak
    [LED.kicad_pcb, LED.kicad_sch]
2024-09-07 Retrack to move USB away from power
    [USBA.kicad_pcb, USBA.kicad_sch, bom.csv, designators.csv, positions.csv]
2024-09-08 Extra via
    [LED.kicad_pcb]
2024-09-16 3D case
    [LED.scad, LED.stl]
2024-09-16 3D remade
    [LED.scad, LED.stl]
2024-09-18 LEFT channel
    [LED.kicad_pcb, LED.kicad_sch]
2024-09-22 Left channel tidy
    [LED.kicad_pcb]
2024-09-24 Library and case
2024-09-30 SS fix
    [LED.kicad_pcb]
2024-10-17 Started on I2S (not working yet)
    [LED.c]
2024-10-19 Fix some RGB issues with HA
    [LED.c, volumergb.c]
2024-10-19 Added revbow (reverse rainbow)
    [audio.c, palette.c]
2024-10-21 Fix malloc, change palette logic, add xmas and neenaw palette (will drop neenaw effect)
    [LED.c, app.h, audio.c, bargraph.c, countdown.c, cylon.c, idle.c, palette.c]
2024-10-21 end LED
2024-10-25 25Hz and synchronised and oversampled.
2024-10-25 New boards GPIO
2024-10-25 Mic on 2 LED module
    [LED.kicad_pcb, LED.kicad_sch, bom.csv, designators.csv, positions.csv]
2024-10-25 Tweak - add slot
    [LED.kicad_pcb, positions.csv]
2024-10-26 live for power on control, simpler.
2024-10-27 Correct fader on drop
    [drop.c]
2024-10-28 New microphone
    [LED.kicad_pcb, LED.kicad_sch, bom.csv, designators.csv, positions.csv]
2024-10-31 New mic
    [USBA.kicad_pcb, USBA.kicad_sch, bom.csv, designators.csv, positions.csv]
2024-11-01 Pads for button
    [LED.kicad_pcb, LED.kicad_sch, designators.csv]
2024-11-02 Revamp audio response, not convinced it is technically correct but way better on higher frequencies now.
    [LED.c, app.h, audio.c, volume.c, volumergb.c]
2024-11-03 100Hz-6400Hz makes clean bins at 1/4 octave spacing
2024-11-04 ADC and tidy SS
    [USBA.kicad_pcb, USBA.kicad_sch, bom.csv, designators.csv, positions.csv]
2024-11-04 audio: Fewer LEDs than bands now handled nicely
2024-11-05 Level shift
    [LED.kicad_pcb, LED.kicad_sch, bom.csv, designators.csv, positions.csv]
2024-11-06 No level convert
    [LED.kicad_pcb, LED.kicad_sch, bom.csv, designators.csv, positions.csv]
2024-11-06 Ok safer for existing boards for now
2024-11-08 Tryign to do extra holes
    [USBA.kicad_pcb, bom.csv, designators.csv, positions.csv]
2024-11-08 Default zero LEDs
2024-11-08 For some reason the led_stgrip is not able to allocate second RMT, needs investigating./ Changed to one strip for now
2024-11-08 Startup with zero LEDs shows R/G/B(/W) fixed pattern for testing
    [LED.c]
2024-11-08 Use SPI memory if possible
2024-11-09 LED strip
2024-11-09 led_strip update
2024-11-11 New design with relay and speaker
    [LED-Screw.stl, LED.kicad_pcb, LED.kicad_sch, LED.scad, LED.stl, bom.csv, designators.csv, positions.csv]
2024-11-11 More caps
    [LED.kicad_pcb, LED.kicad_sch, bom.csv, designators.csv, positions.csv]
2024-11-11 Silk Screen
    [LED.kicad_pcb]
2024-11-11 Tweak GPIOS and update SS
    [LED.kicad_pcb, LED.kicad_sch]
2024-11-12 Update BGA
    [LED.kicad_pcb]
2024-11-14 9dB gain and L+R output
    [LED.kicad_pcb, LED.kicad_sch, bom.csv, designators.csv, positions.csv]
2024-11-14 Clean up and more caps
    [LED.kicad_pcb, LED.kicad_sch, bom.csv, designators.csv, positions.csv]
2024-11-15 LDO and 1st pixel as level shifter
    [LED.kicad_pcb, LED.kicad_sch, bom.csv, designators.csv, positions.csv]
2024-11-15 Moved antenna
    [LED.kicad_pcb, LED.kicad_sch, bom.csv, designators.csv, positions.csv]
2024-11-15 Update for new board
    [LED.kicad_pcb]
2024-11-16 Moved GPIO
    [LED.kicad_pcb, LED.kicad_sch, positions.csv]
2024-11-16 Tidy - for order
    [LED.kicad_pcb, LED.kicad_sch, bom.csv]
2024-11-16 part nos
    [LED.kicad_sch]
2024-11-26 Added light sensor, why not
    [LED.kicad_pcb, LED.kicad_sch, bom.csv, designators.csv, positions.csv]
2024-12-02 Simple button working
2024-12-08 Changed relay logic
    [LED.kicad_pcb, LED.kicad_sch, bom.csv, designators.csv]
2024-12-14 Not level convert as fixes to RGB mode
    [LEDX.kicad_pcb, LEDX.kicad_sch, bom.csv, designators.csv, positions.csv]
2024-12-14 Changed so no level shifter as forces RGB not RGBW
    [LED.kicad_pcb, LED.kicad_sch, bom.csv, designators.csv, positions.csv]
2024-12-14 Tidy tracks
    [LEDX.kicad_pcb, positions.csv]
2024-12-15 No default
    [LEDX.kicad_pcb]
2024-12-21 Started on new coaster
    [Coaster.kicad_sch, Gate.kicad_sch, LED.kicad_pcb, USBA.kicad_pcb, bom.csv, positions.csv]
2024-12-25 Improved for new KiCAD - needs more work on track nets
    [Coaster.kicad_sch]
2024-12-25 199 LEDs
    [Coaster.kicad_pcb, Coaster.kicad_sch]
2024-12-26 124 LEDs
    [Coaster.kicad_pcb, Coaster.kicad_sch, bom.csv, designators.csv, positions.csv]
2024-12-27 Final, and spacers
    [Coaster.kicad_pcb, Coaster.kicad_sch, Spacer.kicad_pcb, designators.csv, positions.csv]
2024-12-28 Tidy SS
    [LED.kicad_pcb, LED.kicad_sch]
2025-01-01 Log tweak for crash
    [LED.c]
2025-01-04 Started on STLs
    [LED.kicad_pcb, LED.scad, LED.stl]
2025-01-11 Reworked layout
    [LED.kicad_pcb, LED.kicad_sch, bom.csv, designators.csv, positions.csv]
2025-01-11 Silkscreen tweak
    [Coaster.kicad_pcb, Spacer.kicad_pcb]
2025-01-11 No QR on white for some reason
    [Coaster.kicad_pcb, designators.csv]
2025-01-11 New image files
    [Coaster.kicad_pcb, LED.kicad_pcb, LED.kicad_sch, LED.scad, LED.stl]
2025-01-12 UIpper case
2025-01-12 remove button
    [LED.kicad_pcb]
2025-01-12 Image updates
    [LED.scad, LED.stl]
2025-01-12 Tab in image
    [LED.kicad_pcb]
2025-01-13 New images
    [LED.kicad_pcb]
2025-01-15 Control which effect on power and clap
2025-01-15 Button and fixes
2025-01-15 Fix bugs
    [Coaster.kicad_sch, Spacer.kicad_pcb, designators.csv]
2025-01-15 Try that
    [Spacer.kicad_pcb]
2025-01-16 LED35 added
    [Coaster.kicad_pcb, Coaster.kicad_sch, LED.kicad_pcb, LED.kicad_sch, Spacer.kicad_pcb, bom.csv, designators.csv, positions.csv]
2025-01-16 Ok 32mm
    [LED.kicad_pcb, LED.kicad_sch, bom.csv, designators.csv, positions.csv]
2025-01-18 Tidy images
    [LED.scad, LED.stl]
2025-01-18 Tidy parts
    [5x7.kicad_pcb, 5x7.kicad_sch, 5x9.kicad_sch, bom.csv, positions.csv]
2025-01-21 Re render (colours)
    [LED.kicad_pcb, LED.kicad_sch]
2025-01-22 New LED types
2025-01-23 PCB Update
    [5x7.kicad_sch, 5x9.kicad_sch, Clock.kicad_pcb, Clock.kicad_sch, Coaster.kicad_pcb, Coaster.kicad_sch, Gate.kicad_sch, Gate1.kicad_pcb]
2025-01-25 Only 4 RMT total, so 3 LED strips
2025-01-25 New README
    [LED.kicad_pcb, LED.kicad_sch, bom.csv, positions.csv]
2025-01-25 Latest layout
    [LED.kicad_pcb, LED.kicad_sch, bom.csv, positions.csv]
2025-02-04 Fixed render
    [Coaster.kicad_pcb, Coaster.kicad_sch, LED.kicad_pcb]
2025-02-21 PCB tidy
    [LED.kicad_pcb, LED.kicad_sch, LED.scad, LED.stl]
2025-04-04 Default current build if not bin file
2025-04-04 Changed GPIO
    [LED.kicad_pcb, LED.kicad_sch, bom.csv, positions.csv]
2025-04-28 Larger caps
    [LED.kicad_pcb, LED.kicad_sch, bom.csv]
2025-04-28 Bigger caps
    [LED.kicad_pcb, LED.kicad_sch, bom.csv, designators.csv, positions.csv]
2025-05-24 WAGO power pads
    [Coaster.kicad_pcb, Coaster.kicad_sch, bom.csv, designators.csv]
2025-06-01 New design
    [LED.kicad_pcb, LED.kicad_sch, LED.scad, LED.stl, bom.csv, designators.csv, positions.csv]
2025-06-22 New power control on LEDC
    [LED.kicad_pcb, LED.kicad_sch, bom.csv, designators.csv, positions.csv]
2025-06-22 Revert as too high voltage for part
    [LED.kicad_pcb, LED.kicad_sch, bom.csv, designators.csv, positions.csv]
2025-06-27 4k7 for DS18B20?
    [LED.kicad_pcb, LED.kicad_sch, bom.csv, designators.csv, positions.csv]
2025-07-12 12V version
    [LED.kicad_pcb, LED.kicad_sch, bom.csv, designators.csv, positions.csv]
2025-07-19 Updated STL
    [LED.scad, LED.stl]
2025-07-19 Updated IR
    [LED.scad, LED.stl]
2025-08-04 Case update
    [LED.scad, LED.stl]
2025-08-12 Re-do cases
    [LEDB.scad, LEDB.stl, LEDT.scad, LEDT.stl]
2025-08-15 Margins tidy
    [LED.kicad_pcb, LED.kicad_sch]
2025-08-15 Re render
    [LED.kicad_pcb, LEDB.scad, LEDB.stl, LEDT.scad, LEDT.stl, bom.csv, positions.csv]
2025-08-24 Render and date code
    [LEDB.scad, LEDB.stl, LEDT.scad, LEDT.stl]
2025-08-25 Re render case# Please enter the commit message for your changes. Lines starting
    [LEDB.scad, LEDB.stl, LEDT.scad, LEDT.stl]
2025-08-26 new cases
    [LEDB.scad, LEDB.stl, LEDT.scad, LEDT.stl]
2025-08-29 As ordered today
    [LED.kicad_pcb, LED.kicad_sch, LEDB.scad, LEDB.stl, LEDT.scad, LEDT.stl, bom.csv, designators.csv]
2025-08-30 Thicker wall
    [LEDB.scad, LEDB.stl, LEDT.scad, LEDT.stl]
2025-09-04 Slight change
    [LED.kicad_pcb, LEDB.scad, LEDB.stl, LEDT.scad, LEDT.stl]
2025-09-07 New coaster case
    [Coaster.scad, Coaster2.scad, Coaster2Base.scad, Coaster2Top.scad, LEDB.scad, LEDB.stl, LEDT.scad, LEDT.stl]
2025-09-07 New case
    [Coaster2.scad]
2025-09-07 Case design
    [Coaster2.scad]
2025-09-07 More base bumps
    [Coaster2Base.scad]
2025-09-07 Case tidy
    [Coaster.kicad_pcb, Coaster.scad, Coaster2.scad]
2025-09-08 Clean up
    [Coaster2.scad, Coaster2Base.scad, Coaster2Top.scad]
2025-09-08 PCB based values
    [Coaster.scad, Coaster2.scad, Coaster2Base.scad, LEDB.scad, LEDB.stl, LEDT.scad, LEDT.stl]
2025-09-21 New LEDX12
    [LED.kicad_pcb, LED.kicad_sch, LEDB.scad, LEDB.stl, LEDT.scad, LEDT.stl, bom.csv, designators.csv]
2025-09-21 Updated (thicker case)
    [Coaster.scad, LED.kicad_pcb, LED.kicad_sch, LEDB.scad, LEDB.stl, LEDT.scad, LEDT.stl, bom.csv]
2025-09-29 Test boards
    [LED.kicad_pcb, LED.kicad_sch, LEDB.scad, LEDB.stl, LEDT.scad, LEDT.stl, bom.csv, designators.csv]
2025-09-30 LEDX12 manifest/NVS
2025-10-01 Tweaked design
    [LED.kicad_pcb, LED.kicad_sch, LEDB.scad, LEDB.stl, LEDT.scad, LEDT.stl, bom.csv]
2025-10-01 Fix GPIO label
    [LED.kicad_pcb, LEDB.scad, LEDB.stl, LEDT.scad, LEDT.stl]
2025-10-06 Ready for LEDX12-WLED
2025-10-09 New LEDs
    [LED.kicad_pcb, LED.kicad_sch, LEDB.scad, LEDB.stl, LEDT.scad, LEDT.stl, bom.csv, designators.csv]
2025-10-09 Started Coaster3 for new LEDs
    [Coaster.kicad_pcb, Coaster.kicad_sch, Spacer.kicad_pcb, bom.csv, designators.csv, positions.csv]
2025-10-10 Bigger hole
    [LEDB.scad, LEDB.stl, LEDT.scad, LEDT.stl]
2025-10-15 Update test seven seg
    [LED.kicad_pcb, LED.kicad_sch]
2025-10-15 Tweak board
    [LED.kicad_pcb, LED.kicad_sch, LEDB.scad, LEDB.stl, LEDT.scad, LEDT.stl, bom.csv, designators.csv]
2025-10-27 test allows fixed colour at end
    [test.c]
2025-11-05 Cleaner render
    [LEDB.stl, LEDC.stl, LEDT.stl]
2025-11-15 Not a good case, but started one, and some cleaner renders
    [LED.kicad_pcb, LED.kicad_sch, LEDB.scad, LEDB.stl, LEDC.scad, LEDC.stl, LEDT.scad, LEDT.stl]
2025-11-19 fix: Text scrolling Added speed control to scrolling text (seconds per character) Added snake and flip and height as globals for text Extended clock to seconds if space
    [LED.c, app.h, settings.c, settings.h, text.c]
2025-11-19 Edge case on offset text
2025-11-20 fix: Clock - change kerning and zero to be fixed space and neater
    [text.c]
2025-11-20 fix: scrolling kerned text
    [chars.h, settings.c, settings.h, text.c]
2025-11-20 fix: character height squashing (good at 7 and 8, less so at lower values)
    [text.c]
2025-11-20 Non gamma option (currently global)
